greatscottgadgets/misc/README.md

misc
====

miscellaneous Great Scott Gadgets projects
