greatscottgadgets/misc/evaluation-boards/rf-amps/rf-amps.kicad_pcb

## KiCad design evaluation-boards/rf-amps/rf-amps.kicad_pcb (2025-06-16)

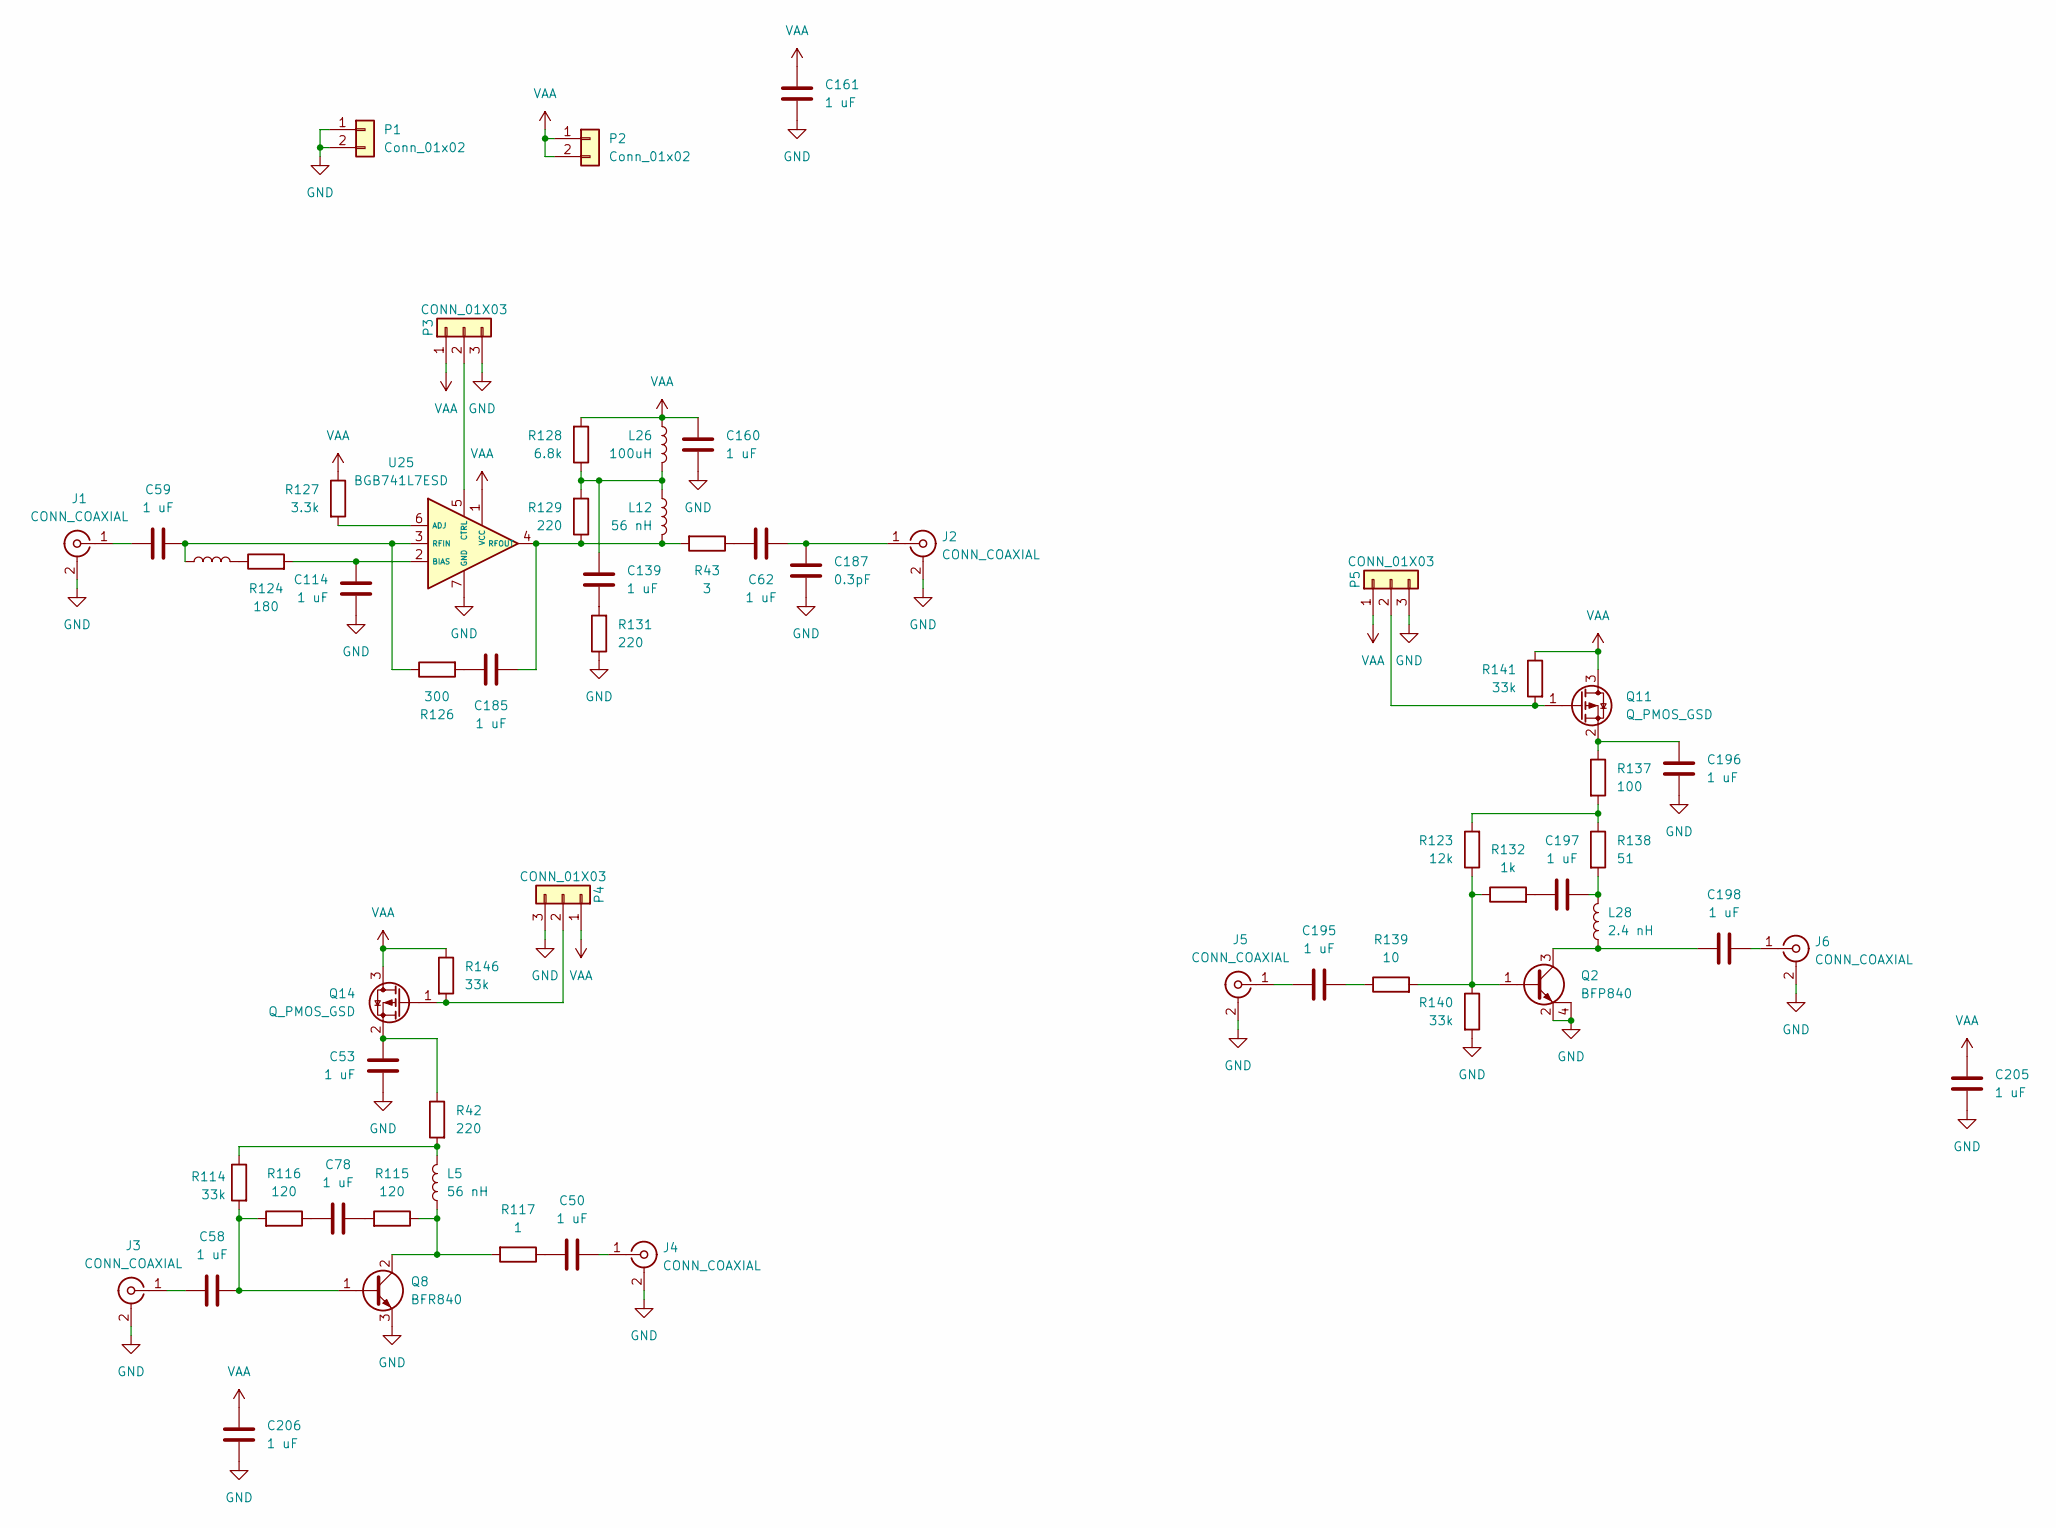
[picture p1: schematic rf-amps.kicad_sch]

Parts:
C50, C53, C58, C59, C62, C78, C114, C139, C160, C161, C185, C195, C196, C197, C198, C205, C206: 1 uF; C_0201_0603Metric; Part Number GRM033R61A105ME44D
C187: 0.3pF; C_0201_0603Metric; Part Number GRM0335C1ER30BA01D
J1, J2, J3, J4, J5, J6: CONN_COAXIAL; SMA_MyAntenna_A-SMA-KE-16.5A_EdgeMount
L5, L12: 56 nH; L_0201_0603Metric; Part Number LQP03TN56NJ02D
L25: 8.2 nH; L_0201_0603Metric; Part Number LQP03TN8N2J02D
L26: 100uH; L_TDK_MLZ2012_h1.25mm; Part Number MLZ2012N101LT000
L28: 2.4 nH; L_0201_0603Metric; Part Number LQP03TN2N4C02D
P1, P2: Conn_01x02; PinHeader_1x02_P2.54mm_Vertical
P3, P4, P5: CONN_01X03; PinHeader_1x03_P2.54mm_Vertical
Q2: BFP840; SOT-343-4-3; Part Number BFP840ESDH6327XTSA1
Q8: BFR840; TSLP-3-9; Part Number BFR840L3RHESDE6327XTSA1
Q11, Q14: Q_PMOS_GSD; TSLP-3-9; Part Number LP0404N3T5G
R42, R129, R131: 220; R_0201_0603Metric; Part Number RC0201JR-07220RL
R43: 3; R_0201_0603Metric; Part Number RC0402JR-073RL
R114, R140, R141, R146: 33k; R_0201_0603Metric; Part Number RC0201JR-0733KL
R115, R116: 120; R_0201_0603Metric; Part Number RC0201FR-07120RL
R117: 1; R_0201_0603Metric; Part Number RC0201JR-071RL
R123: 12k; R_0201_0603Metric; Part Number RC0201FR-0712KL
R124: 180; R_0201_0603Metric; Part Number RC0201FR-07180RL
R126: 300; R_0201_0603Metric; Part Number RC0201FR-07300RL
R127: 3.3k; R_0201_0603Metric; Part Number RC0201FR-073K3L
R128: 6.8k; R_0201_0603Metric; Part Number RC0201FR-076K8L
R132: 1k; R_0201_0603Metric; Part Number RC0201FR-071KL
R137: 100; R_0201_0603Metric; Part Number RC0201JR-07100RL
R138: 51; R_0201_0603Metric; Part Number RC0201JR-0751RL
R139: 10; R_0201_0603Metric; Part Number RC0201JR-0710RL
U25: BGB741L7ESD; TSLP-7-1; Part Number BGB741L7ESDE6327XTSA1

Connections:
GND: C53.2, C114.2, C160.2, C161.2, C187.2, C196.2, C205.2, C206.2, J1.2 (Ext), J2.2 (Ext), J3.2 (Ext), J4.2 (Ext), J5.2 (Ext), J6.2 (Ext), P1.1, P1.2, P3.3, P4.3, P5.3, Q2.2 (E), Q2.4 (C), Q8.3 (E), R131.1, R140.2, U25.7 (GND)
unnamed: C50.2, R117.1
unnamed: C62.1, R43.1
unnamed: C78.1, R115.2
unnamed: C78.2, R116.1
unnamed: C139.1, L12.1, L26.2, R128.1, R129.2
unnamed: C139.2, R131.2
unnamed: C185.2, R126.2
unnamed: C195.1, R139.1
unnamed: C197.1, L28.2, R138.2
unnamed: C197.2, R132.2
unnamed: C198.2, L28.1, Q2.3 (C)
unnamed: C59.1, J1.1 (In)
unnamed: C62.2, C187.1, J2.1 (In)
unnamed: C58.1, J3.1 (In)
unnamed: C50.1, J4.1 (In)
unnamed: C195.2, J5.1 (In)
unnamed: C198.1, J6.1 (In)
unnamed: L5.1, R42.2, R114.1
unnamed: L25.2, R124.1
unnamed: P3.2, U25.5 (CTRL)
unnamed: P4.2, Q14.1 (G), R146.2
unnamed: P5.2, Q11.1 (G), R141.2
unnamed: Q2.1 (B), R123.1, R132.1, R139.2, R140.1
unnamed: C58.2, Q8.1 (B), R114.2, R116.2
unnamed: L5.2, Q8.2 (C), R115.1, R117.2
unnamed: C196.1, Q11.2 (S), R137.1
unnamed: C53.1, Q14.2 (S), R42.1
unnamed: R123.2, R137.2, R138.1
unnamed: R127.2, U25.6 (ADJ)
unnamed: C114.1, R124.2, U25.2 (BIAS)
unnamed: C59.2, L25.1, R126.1, U25.3 (RFIN)
unnamed: C185.1, L12.2, R43.2, R129.1, U25.4 (RFOUT)
VAA: C160.1, C161.1, C205.1, C206.1, L26.1, P2.1, P2.2, P3.1, P4.1, P5.1, Q11.3 (D), Q14.3 (D), R127.1, R128.2, R141.1, R146.1, U25.1 (VCC)

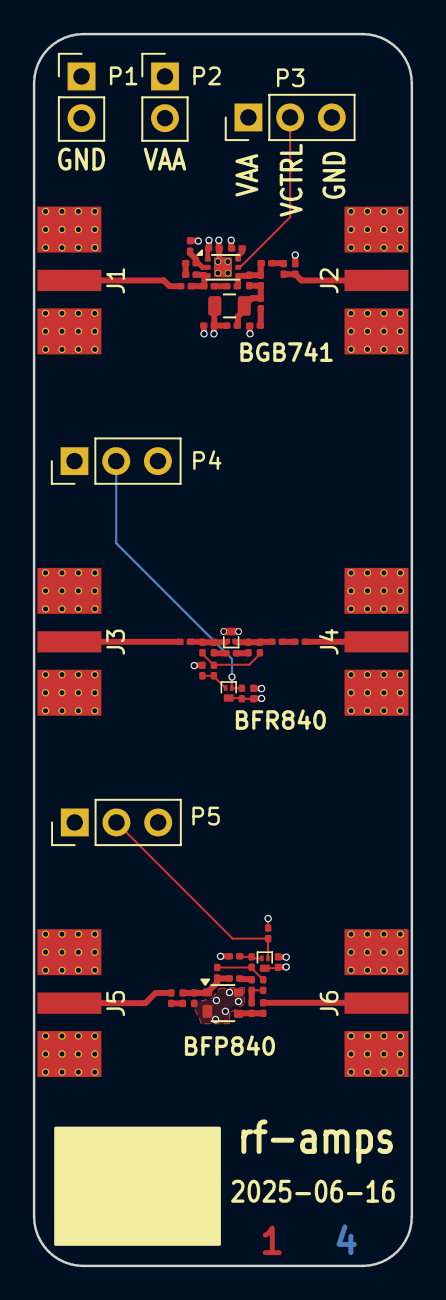
[picture p2: board rf-amps.kicad_pcb from above]

Board: 4 copper layers, 23.0 x 75.0 mm, 59 parts (0 on the bottom side), 34 nets.
