greatscottgadgets/misc/evaluation-boards/baluns/baluns.kicad_pcb

## KiCad design evaluation-boards/baluns/baluns.kicad_pcb (2025-06-16)

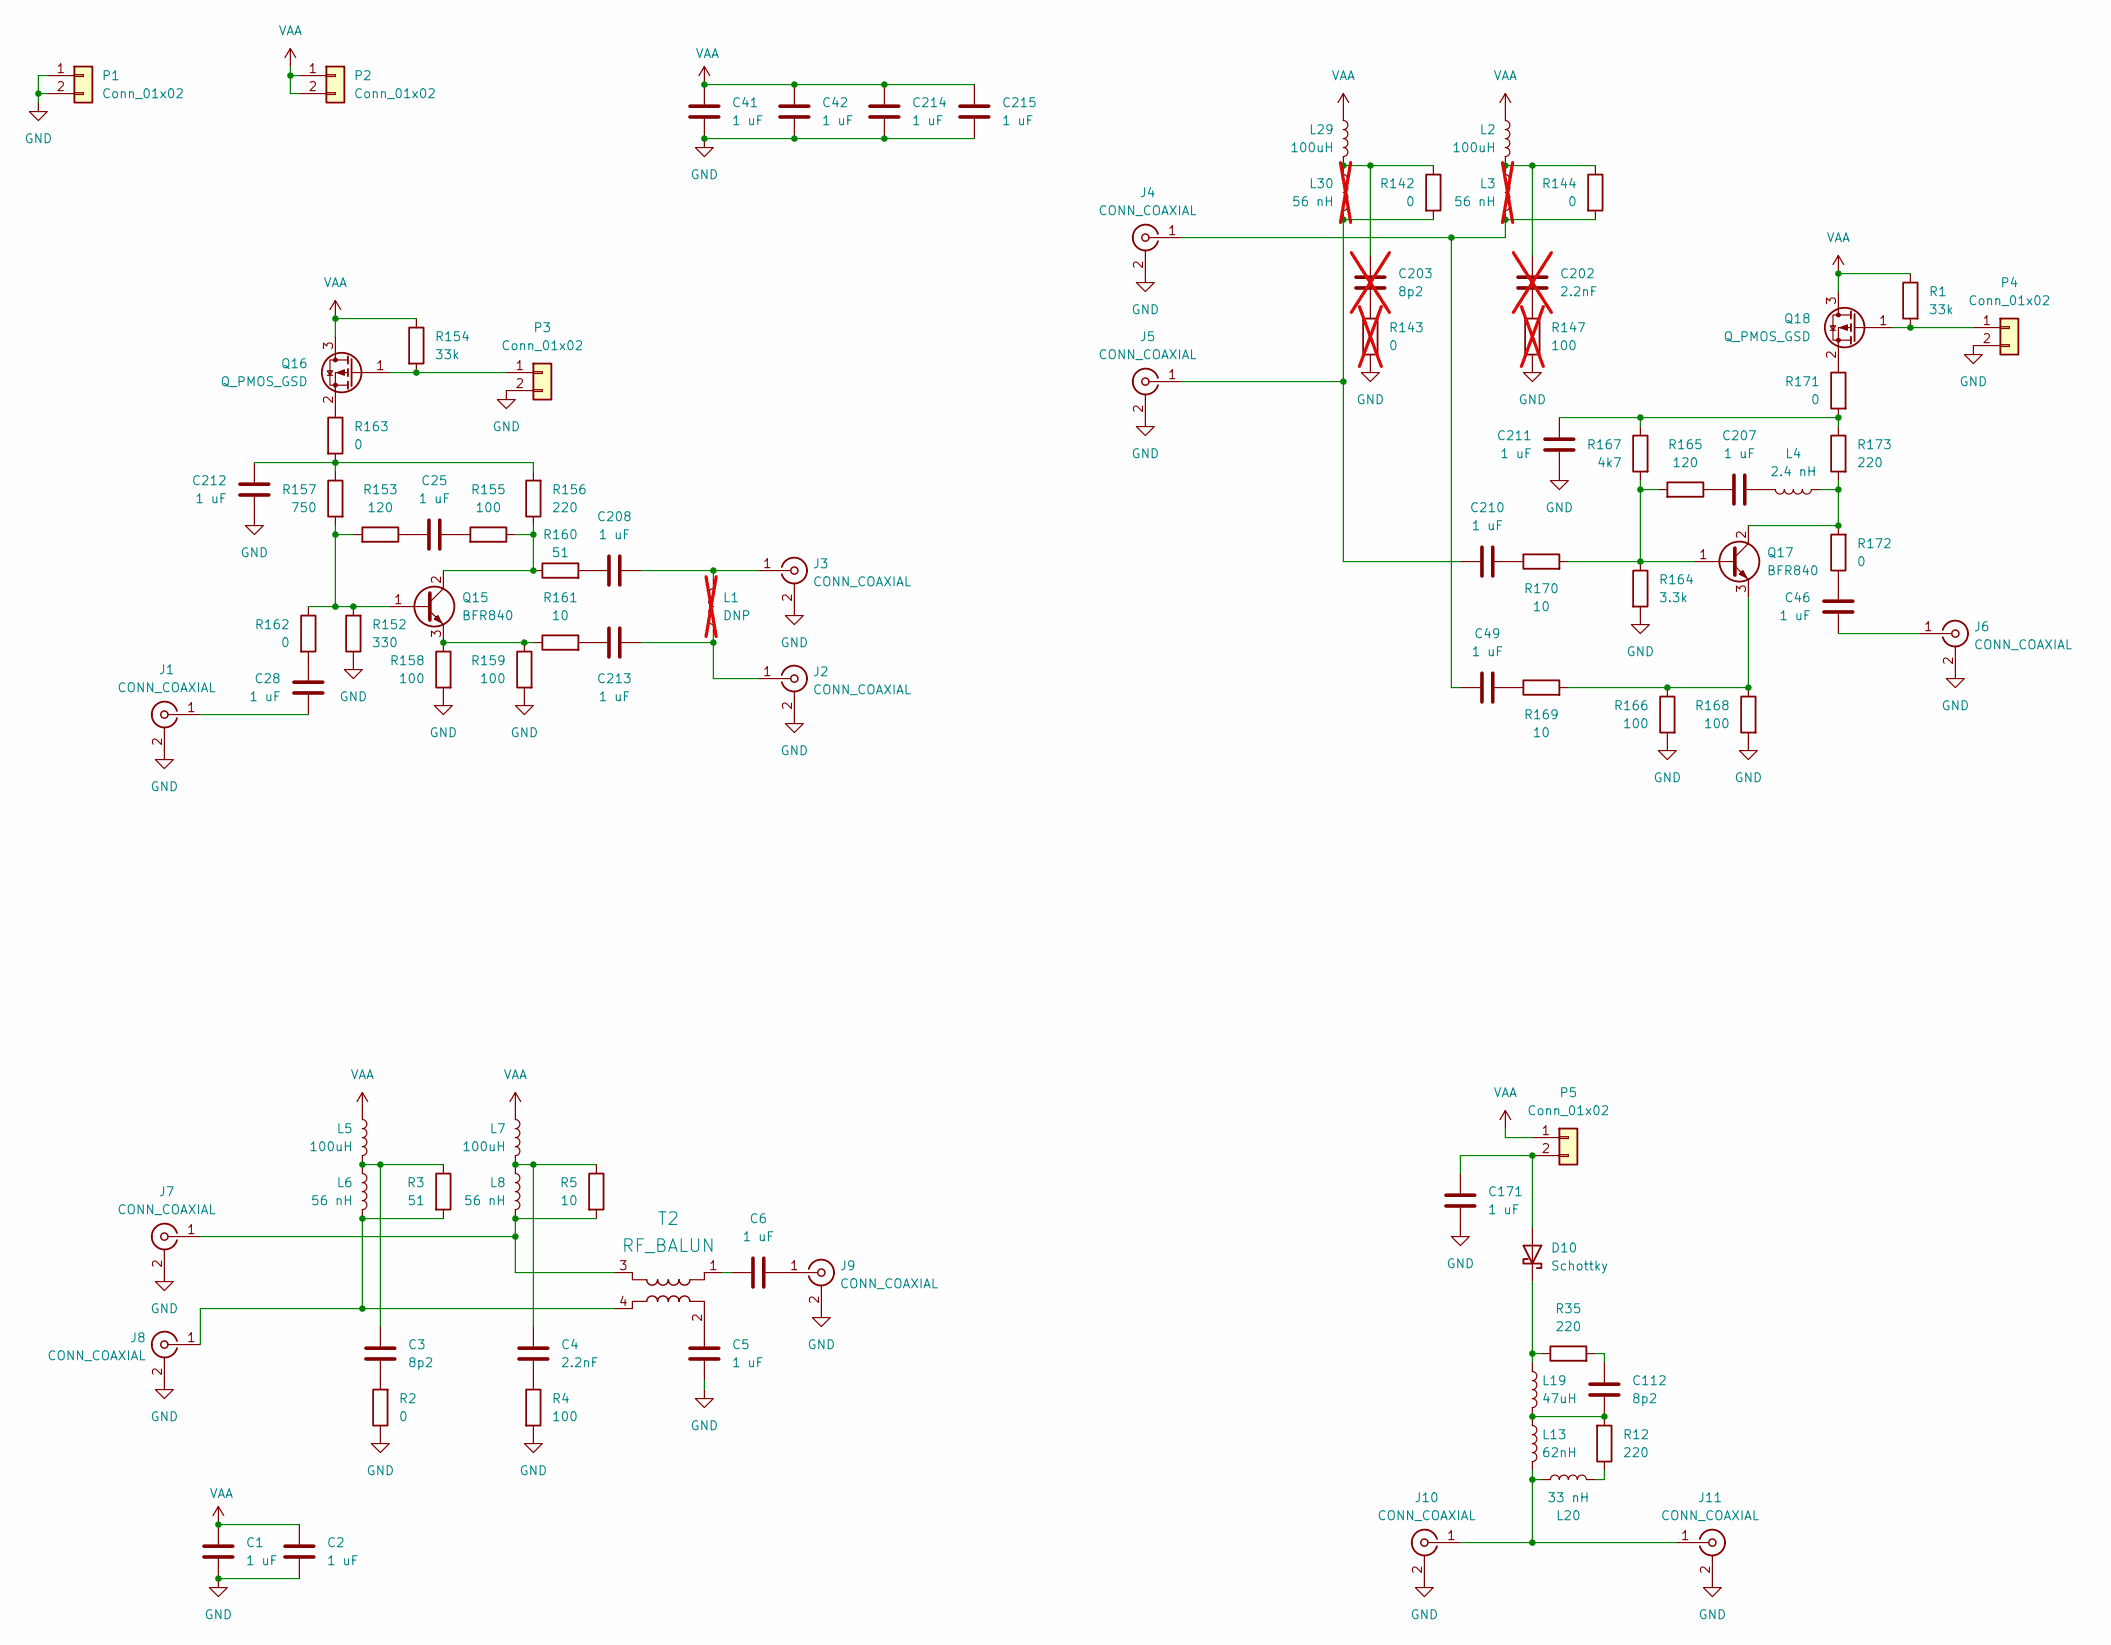
[picture p3: schematic baluns.kicad_sch, {$TITLE}]

Parts:
C1, C2, C5, C6, C25, C28, C41, C42, C46, C49, C171, C207, C208, C210, C211, C212, C213, C214, C215: 1 uF; C_0201_0603Metric; Part Number GRM033R61A105ME44D
C3, C112: 8p2; C_0201_0603Metric; Part Number GRM0335C1H8R2CA01D
C4: 2.2nF; C_0201_0603Metric; Part Number GRM033R71A222KA01D
C202: 2.2nF; C_0201_0603Metric; Part Number GRM033R71A222KA01D; not fitted
C203: 8p2; C_0201_0603Metric; Part Number GRM0335C1H8R2CA01D; not fitted
D10: Schottky; TSLP-2-19; Part Number PMEG4010ESBYL
J1, J2, J3, J4, J5, J6, J7, J8, J9, J10, J11: CONN_COAXIAL; SMA_MyAntenna_A-SMA-KE-16.5A_EdgeMount
L1: DNP; L_0201_0603Metric; not fitted
L2, L5, L7, L29: 100uH; L_TDK_MLZ2012_h1.25mm; Part Number MLZ2012N101LT000
L3, L30: 56 nH; L_0201_0603Metric; Part Number LQP03TN56NJ02D; not fitted
L4: 2.4 nH; L_0201_0603Metric; Part Number LQP03TN2N4C02D
L6, L8: 56 nH; L_0201_0603Metric; Part Number LQP03TN56NJ02D
L13: 62nH; L_0603_1608Metric; Part Number LQW18AN62NJ00D
L19: 47uH; L_Taiyo-Yuden_A251818; Part Number LSQEA251818T470M
L20: 33 nH; L_0201_0603Metric; Part Number LQP03TN33NJ02D
P1, P2, P3, P4, P5: Conn_01x02; PinHeader_1x02_P2.54mm_Vertical
Q15, Q17: BFR840; TSLP-3-9; Part Number BFR840L3RHESDE6327XTSA1
Q16, Q18: Q_PMOS_GSD; TSLP-3-9; Part Number LP0404N3T5G
R1, R154: 33k; R_0201_0603Metric; Part Number RC0201JR-0733KL
R2, R142, R144, R162, R163, R171, R172: 0; R_0201_0603Metric; Part Number RC0201JR-070RL
R3, R160: 51; R_0201_0603Metric; Part Number RC0201JR-0751RL
R4, R155, R158, R159, R166, R168: 100; R_0201_0603Metric; Part Number RC0201JR-07100RL
R5, R161, R169, R170: 10; R_0201_0603Metric; Part Number RC0201JR-0710RL
R12, R35, R156, R173: 220; R_0201_0603Metric; Part Number RC0201JR-07220RL
R143: 0; R_0201_0603Metric; Part Number RC0201JR-070RL; not fitted
R147: 100; R_0201_0603Metric; Part Number RC0201JR-07100RL; not fitted
R152: 330; R_0201_0603Metric; Part Number RC0201JR-07330RL
R153, R165: 120; R_0201_0603Metric; Part Number RC0201FR-07120RL
R157: 750; R_0201_0603Metric; Part Number RC0201JR-07750RL
R164: 3.3k; R_0201_0603Metric; Part Number RC0201FR-073K3L
R167: 4k7; R_0201_0603Metric; Part Number RC0201FR-074K7L
T2: RF_BALUN; Anaren_0805_2012Metric-6; Part Number B0310J50100AHF

Connections:
GND: C1.2, C2.2, C5.1, C41.2, C42.2, C171.2, C211.2, C212.2, C214.2, C215.2, J1.2 (Ext), J2.2 (Ext), J3.2 (Ext), J4.2 (Ext), J5.2 (Ext), J6.2 (Ext), J7.2 (Ext), J8.2 (Ext), J9.2 (Ext), J10.2 (Ext), J11.2 (Ext), P1.1, P1.2, P3.2, P4.2, R2.1, R4.2, R143.1, R147.2, R152.1, R158.2, R159.2, R164.2, R166.2, R168.2
unnamed: C3.1, L5.2, L6.1, R3.1
unnamed: C3.2, R2.2
unnamed: C4.1, R4.1
unnamed: C4.2, L7.2, L8.1, R5.1
unnamed: C6.2, T2.1
unnamed: C25.1, R155.2
unnamed: C25.2, R153.1
unnamed: C28.1, R162.2
unnamed: C46.1, R172.1
unnamed: C49.1, R169.1
unnamed: C112.1, R35.2
unnamed: C112.2, L13.1, L19.2, R12.2
unnamed: C202.1, R147.1
unnamed: C202.2, L2.2, L3.1, R144.1
unnamed: C203.1, L29.2, L30.1, R142.1
unnamed: C203.2, R143.2
unnamed: C207.1, L4.2
unnamed: C207.2, R165.1
unnamed: C208.2, R160.2
unnamed: C210.1, R170.1
unnamed: C211.1, R167.1, R171.2, R173.1
unnamed: C212.1, R156.2, R157.1, R163.2
unnamed: C213.2, R161.2
unnamed: C171.1, D10.2 (A), P5.2
unnamed: D10.1 (K), L19.1, R35.1
unnamed: C28.2, J1.1 (In)
unnamed: C213.1, J2.1 (In), L1.1
unnamed: C208.1, J3.1 (In), L1.2
unnamed: C49.2, J4.1 (In), L3.2, R144.2
unnamed: C210.2, J5.1 (In), L30.2, R142.2
unnamed: C46.2, J6.1 (In)
unnamed: J7.1 (In), L8.2, R5.2, T2.3
unnamed: J8.1 (In), L6.2, R3.2, T2.4
unnamed: C6.1, J9.1 (In)
unnamed: J10.1 (In), J11.1 (In), L13.2, L20.2
unnamed: L20.1, R12.1
unnamed: P3.1, Q16.1 (G), R154.2
unnamed: P4.1, Q18.1 (G), R1.2
unnamed: Q15.1 (B), R152.2, R153.2, R157.2, R162.1
unnamed: Q15.2 (C), R155.1, R156.1, R160.1
unnamed: Q15.3 (E), R158.1, R159.1, R161.1
unnamed: Q16.2 (S), R163.1
unnamed: Q17.1 (B), R164.1, R165.2, R167.2, R170.2
unnamed: L4.1, Q17.2 (C), R172.2, R173.2
unnamed: Q17.3 (E), R166.1, R168.1, R169.2
unnamed: Q18.2 (S), R171.1
unnamed: C5.2, T2.2 (GND)
VAA: C1.1, C2.1, C41.1, C42.1, C214.1, C215.1, L2.1, L5.1, L7.1, L29.1, P2.1, P2.2, P5.1, Q16.3 (D), Q18.3 (D), R1.1, R154.1

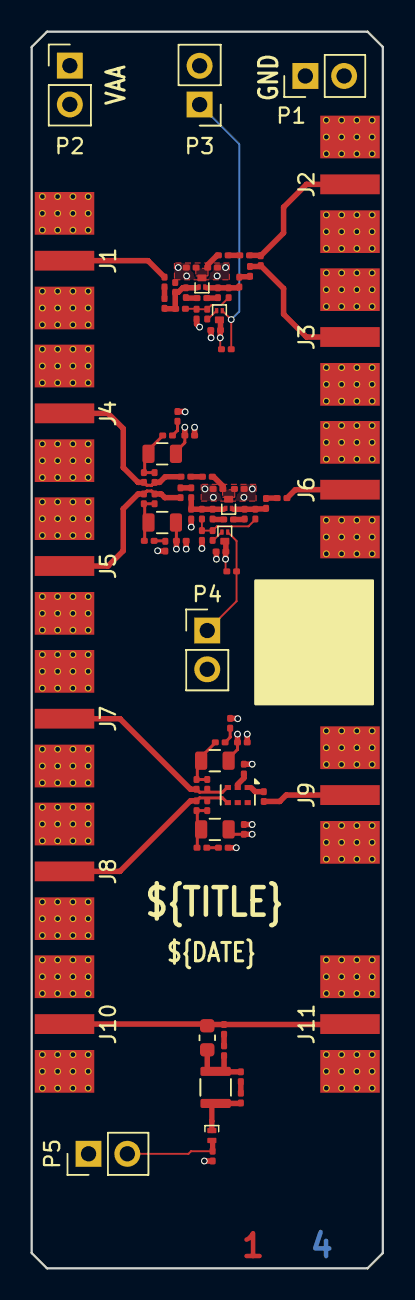
[picture p4: board baluns.kicad_pcb from above]

Board: 4 copper layers, 23.0 x 81.0 mm, 92 parts (0 on the bottom side), 49 nets.
