greatscottgadgets/misc/evaluation-boards/filters/filters.kicad_pcb

## KiCad design evaluation-boards/filters/filters.kicad_pcb (2025-06-16)

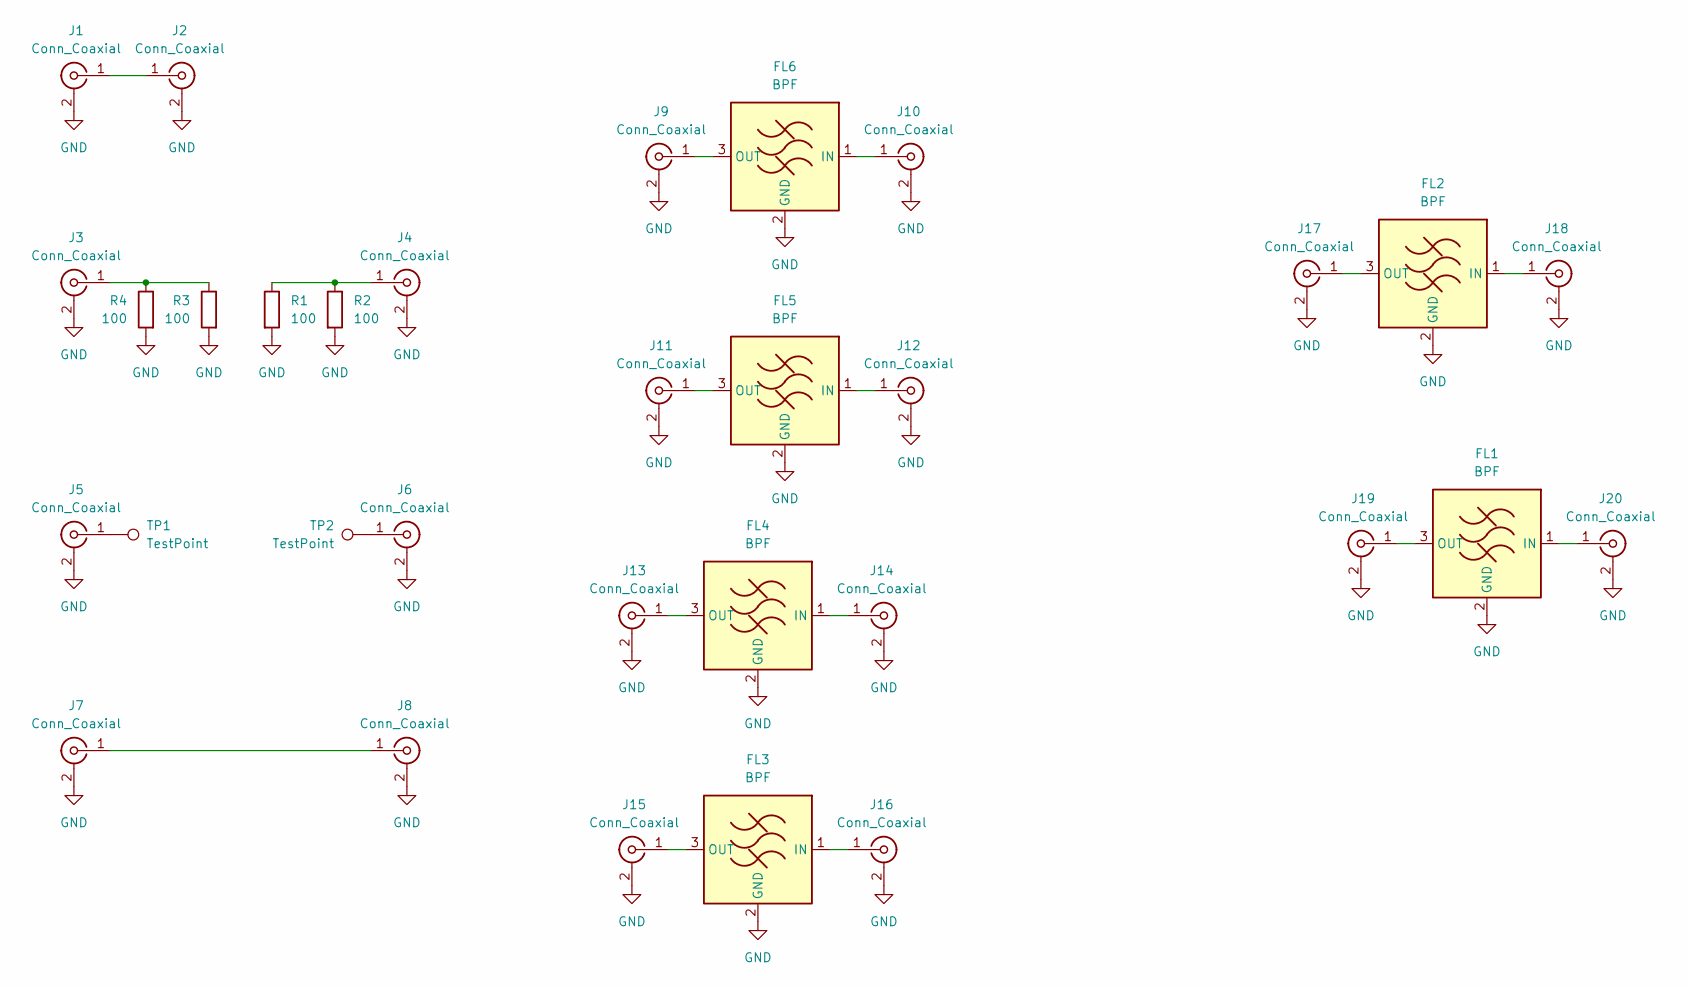
[picture p5: schematic filters.kicad_sch, ${TITLE}]

Parts:
FL1, FL2, FL3, FL4, FL5, FL6: BPF; Filter_Pulse_BPF1608LM09R5000A; Part Number BPF1608LM02R2400A
J1, J2, J3, J4, J5, J6, J7, J8, J9, J10, J11, J12, J13, J14, J15, J16, J17, J18, J19, J20: Conn_Coaxial; SMA_MyAntenna_A-SMA-KE-16.5A_EdgeMount
R1, R2, R3, R4: 100; R_0201_0603Metric
TP1, TP2: TestPoint; Square_Pad_0.364x0.364mm

Connections:
GND: FL1.2 (GND), FL1.4 (GND), FL2.2 (GND), FL2.4 (GND), FL3.2 (GND), FL3.4 (GND), FL4.2 (GND), FL4.4 (GND), FL5.2 (GND), FL5.4 (GND), FL6.2 (GND), FL6.4 (GND), J1.2 (Ext), J2.2 (Ext), J3.2 (Ext), J4.2 (Ext), J5.2 (Ext), J6.2 (Ext), J7.2 (Ext), J8.2 (Ext), J9.2 (Ext), J10.2 (Ext), J11.2 (Ext), J12.2 (Ext), J13.2 (Ext), J14.2 (Ext), J15.2 (Ext), J16.2 (Ext), J17.2 (Ext), J18.2 (Ext), J19.2 (Ext), J20.2 (Ext), R1.2, R2.2, R3.2, R4.2
unnamed: FL1.1 (IN), J20.1 (In)
unnamed: FL1.3 (OUT), J19.1 (In)
unnamed: FL2.1 (IN), J18.1 (In)
unnamed: FL2.3 (OUT), J17.1 (In)
unnamed: FL3.1 (IN), J16.1 (In)
unnamed: FL3.3 (OUT), J15.1 (In)
unnamed: FL4.1 (IN), J14.1 (In)
unnamed: FL4.3 (OUT), J13.1 (In)
unnamed: FL5.1 (IN), J12.1 (In)
unnamed: FL5.3 (OUT), J11.1 (In)
unnamed: FL6.1 (IN), J10.1 (In)
unnamed: FL6.3 (OUT), J9.1 (In)
unnamed: J1.1 (In), J2.1 (In)
unnamed: J3.1 (In), R3.1, R4.1
unnamed: J4.1 (In), R1.1, R2.1
unnamed: J5.1 (In), TP1.1
unnamed: J6.1 (In), TP2.1
unnamed: J7.1 (In), J8.1 (In)

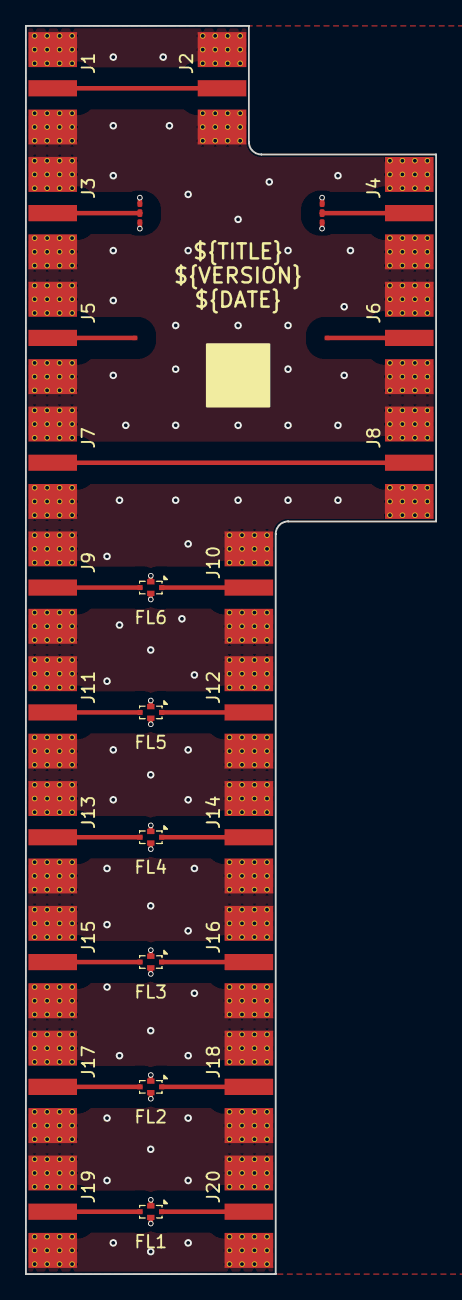
[picture p6: board filters.kicad_pcb from above]

Board: 4 copper layers, 32.9 x 100.0 mm, 32 parts (0 on the bottom side), 19 nets.
