greatscottgadgets/misc/evaluation-boards/trace-width/sma-jlcpcb.kicad_pcb

## KiCad design evaluation-boards/trace-width/sma-jlcpcb.kicad_pcb (2025-03-12)

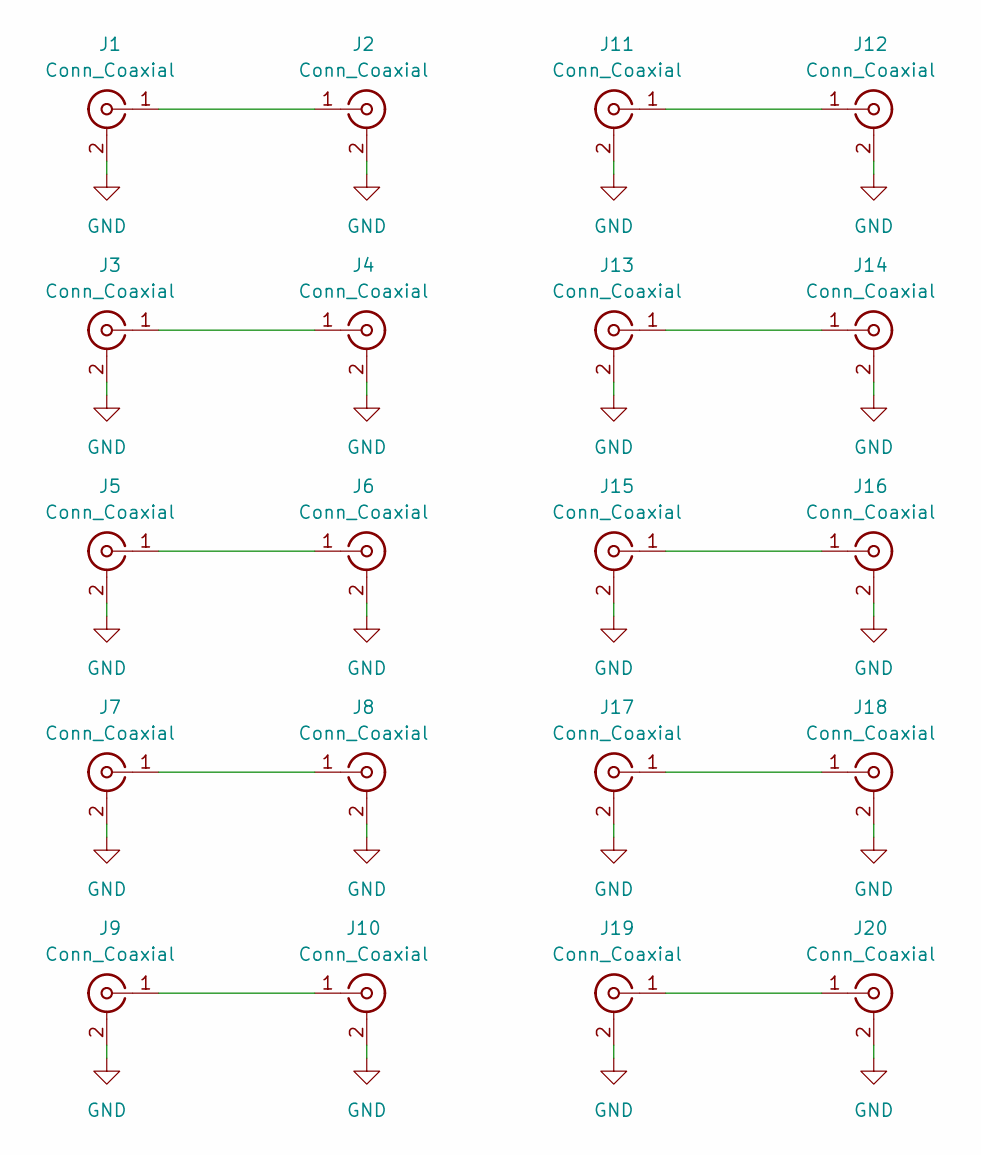
[picture p7: schematic sma-jlcpcb.kicad_sch]

Parts:
J1, J2, J3, J4, J5, J6, J7, J8, J9, J10, J11, J12, J13, J14, J15, J16, J17, J18, J19, J20: Conn_Coaxial

Connections:
GND: J1.2 (Ext), J2.2 (Ext), J3.2 (Ext), J4.2 (Ext), J5.2 (Ext), J6.2 (Ext), J7.2 (Ext), J8.2 (Ext), J9.2 (Ext), J10.2 (Ext), J11.2 (Ext), J12.2 (Ext), J13.2 (Ext), J14.2 (Ext), J15.2 (Ext), J16.2 (Ext), J17.2 (Ext), J18.2 (Ext), J19.2 (Ext), J20.2 (Ext)
unnamed: J1.1 (In), J2.1 (In)
unnamed: J3.1 (In), J4.1 (In)
unnamed: J5.1 (In), J6.1 (In)
unnamed: J7.1 (In), J8.1 (In)
unnamed: J9.1 (In), J10.1 (In)
unnamed: J11.1 (In), J12.1 (In)
unnamed: J13.1 (In), J14.1 (In)
unnamed: J15.1 (In), J16.1 (In)
unnamed: J17.1 (In), J18.1 (In)
unnamed: J19.1 (In), J20.1 (In)

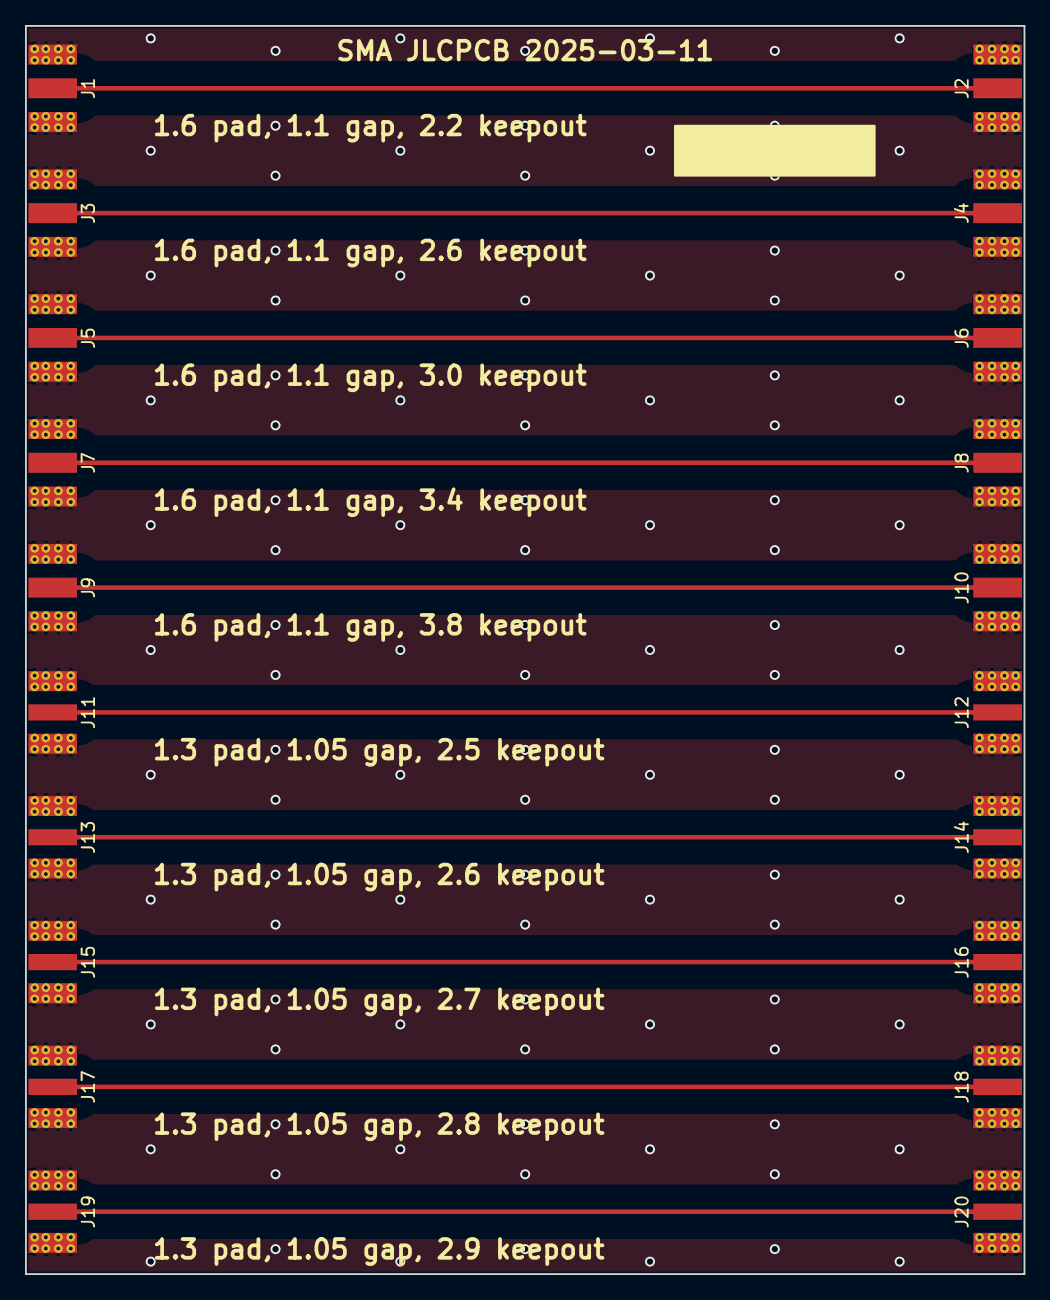
[picture p8: board sma-jlcpcb.kicad_pcb from above]

Board: 6 copper layers, 80.0 x 100.0 mm, 20 parts (0 on the bottom side), 11 nets.
