greatscottgadgets/misc/evaluation-boards/leds/leds.kicad_pcb

## KiCad design evaluation-boards/leds/leds.kicad_pcb (2025-03-12)

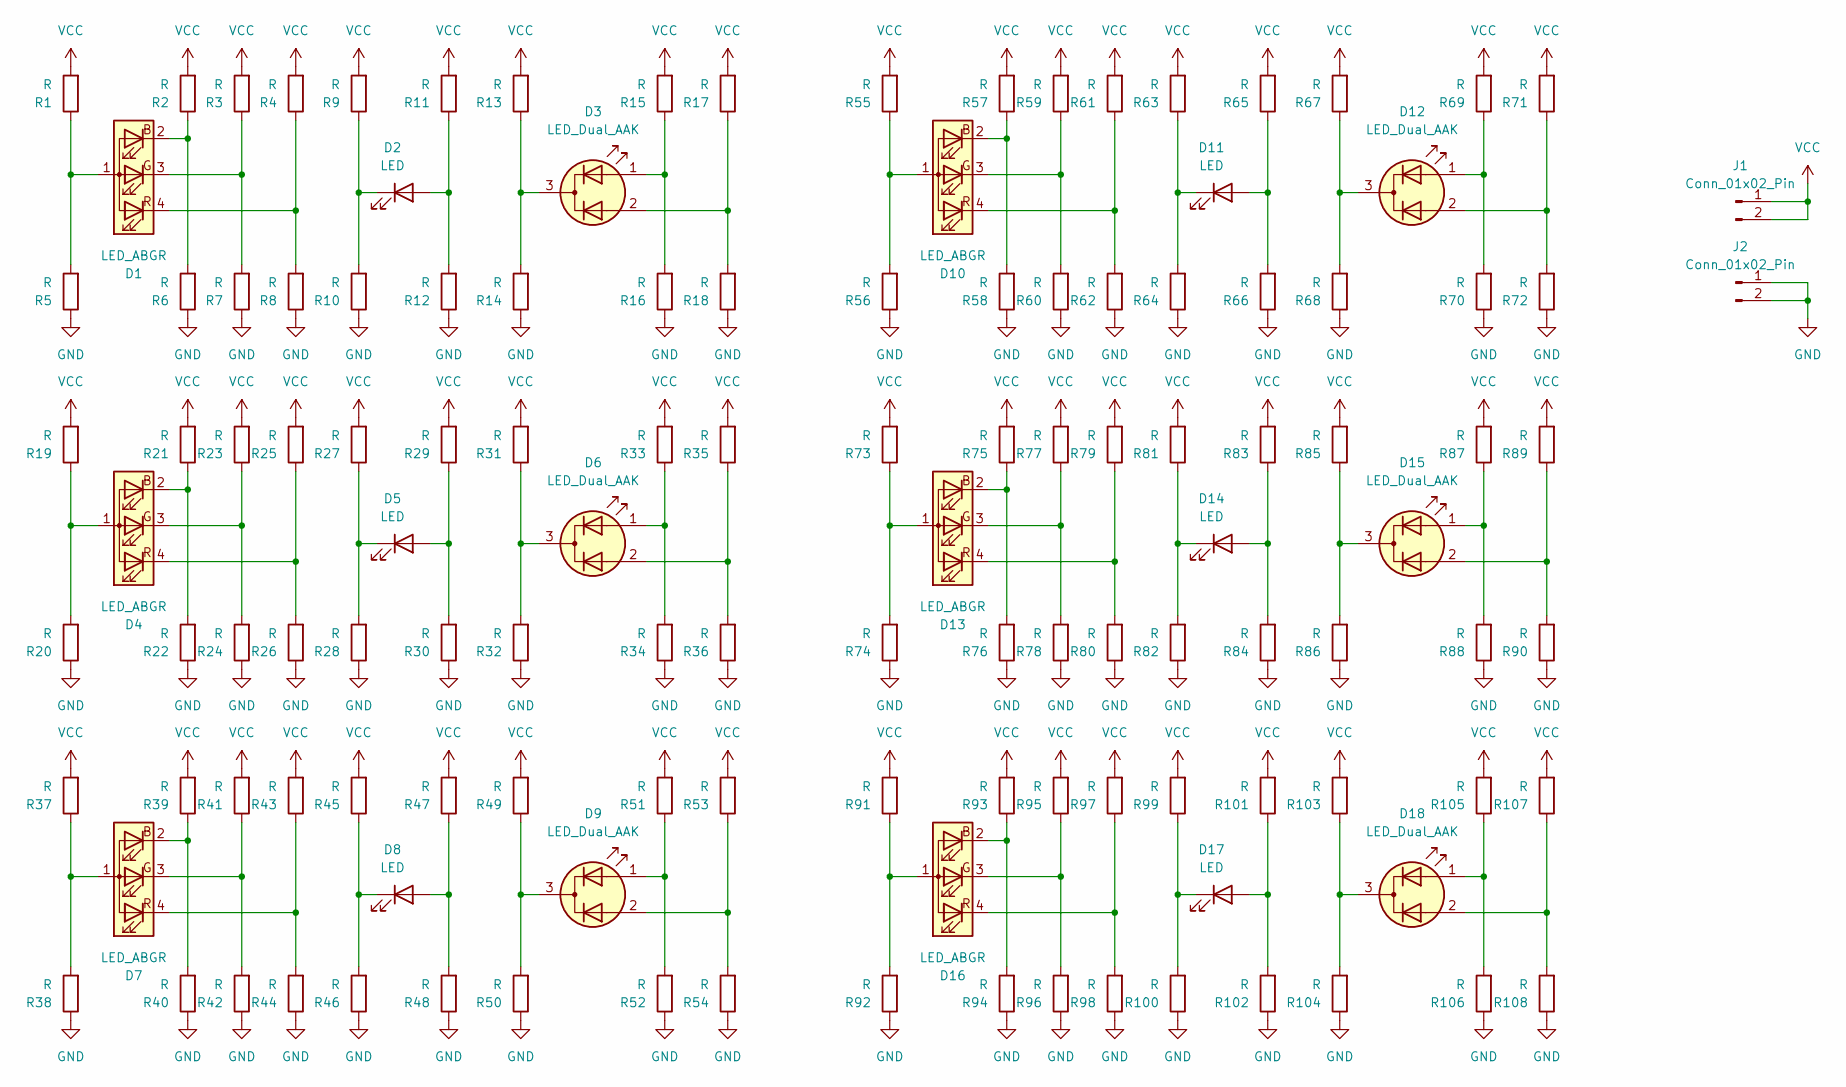
[picture p9: schematic leds.kicad_sch, ${TITLE}]

Parts:
D1, D4, D7, D10, D13, D16: LED_ABGR; LED_RGB_Everlight_EASV3015RGBA0_Horizontal
D2, D5, D8, D11, D14, D17: LED; LED_Kingbright_APA1606_1.6x0.6mm_Horizontal
D3, D6, D9, D12, D15, D18: LED_Dual_AAK; LED_Kingbright_KPA-3010_3x2x1mm
J1, J2: Conn_01x02_Pin; PinHeader_1x02_P2.54mm_Vertical
R1, R2, R3, R4, R5, R6, R7, R8, R9, R10, R11, R12, R13, R14, R15, R16, R17, R18, R19, R20, R21, R22, R23, R24, R25, R26, R27, R28, R29, R30, R31, R32, R33, R34, R35, R36, R37, R38, R39, R40, R41, R42, R43, R44, R45, R46, R47, R48, R49, R50, R51, R52, R53, R54, R55, R56, R57, R58, R59, R60, R61, R62, R63, R64, R65, R66, R67, R68, R69, R70, R71, R72, R73, R74, R75, R76, R77, R78, R79, R80, R81, R82, R83, R84, R85, R86, R87, R88, R89, R90, R91, R92, R93, R94, R95, R96, R97, R98, R99, R100, R101, R102, R103, R104, R105, R106, R107, R108: R; R_0402_1005Metric

Connections:
GND: J2.1, J2.2, R5.1, R6.1, R7.1, R8.1, R10.1, R12.1, R14.1, R16.1, R18.1, R20.1, R22.1, R24.1, R26.1, R28.1, R30.1, R32.1, R34.1, R36.1, R38.1, R40.1, R42.1, R44.1, R46.1, R48.1, R50.1, R52.1, R54.1, R56.1, R58.1, R60.1, R62.1, R64.1, R66.1, R68.1, R70.1, R72.1, R74.1, R76.1, R78.1, R80.1, R82.1, R84.1, R86.1, R88.1, R90.1, R92.1, R94.1, R96.1, R98.1, R100.1, R102.1, R104.1, R106.1, R108.1
unnamed: D1.1 (A), R1.1, R5.2
unnamed: D1.2 (BK), R2.1, R6.2
unnamed: D1.3 (GK), R3.1, R7.2
unnamed: D1.4 (RK), R4.1, R8.2
unnamed: D2.2 (A), R11.1, R12.2
unnamed: D2.1 (K), R9.1, R10.2
unnamed: D3.1 (A1), R15.1, R16.2
unnamed: D3.2 (A2), R17.1, R18.2
unnamed: D3.3 (K), R13.1, R14.2
unnamed: D4.1 (A), R19.1, R20.2
unnamed: D4.2 (BK), R21.1, R22.2
unnamed: D4.3 (GK), R23.1, R24.2
unnamed: D4.4 (RK), R25.1, R26.2
unnamed: D5.2 (A), R29.1, R30.2
unnamed: D5.1 (K), R27.1, R28.2
unnamed: D6.1 (A1), R33.1, R34.2
unnamed: D6.2 (A2), R35.1, R36.2
unnamed: D6.3 (K), R31.1, R32.2
unnamed: D7.1 (A), R37.1, R38.2
unnamed: D7.2 (BK), R39.1, R40.2
unnamed: D7.3 (GK), R41.1, R42.2
unnamed: D7.4 (RK), R43.1, R44.2
unnamed: D8.2 (A), R47.1, R48.2
unnamed: D8.1 (K), R45.1, R46.2
unnamed: D9.1 (A1), R51.1, R52.2
unnamed: D9.2 (A2), R53.1, R54.2
unnamed: D9.3 (K), R49.1, R50.2
unnamed: D10.1 (A), R55.1, R56.2
unnamed: D10.2 (BK), R57.1, R58.2
unnamed: D10.3 (GK), R59.1, R60.2
unnamed: D10.4 (RK), R61.1, R62.2
unnamed: D11.2 (A), R65.1, R66.2
unnamed: D11.1 (K), R63.1, R64.2
unnamed: D12.1 (A1), R69.1, R70.2
unnamed: D12.2 (A2), R71.1, R72.2
unnamed: D12.3 (K), R67.1, R68.2
unnamed: D13.1 (A), R73.1, R74.2
unnamed: D13.2 (BK), R75.1, R76.2
unnamed: D13.3 (GK), R77.1, R78.2
unnamed: D13.4 (RK), R79.1, R80.2
unnamed: D14.2 (A), R83.1, R84.2
unnamed: D14.1 (K), R81.1, R82.2
unnamed: D15.1 (A1), R87.1, R88.2
unnamed: D15.2 (A2), R89.1, R90.2
unnamed: D15.3 (K), R85.1, R86.2
unnamed: D16.1 (A), R91.1, R92.2
unnamed: D16.2 (BK), R93.1, R94.2
unnamed: D16.3 (GK), R95.1, R96.2
unnamed: D16.4 (RK), R97.1, R98.2
unnamed: D17.2 (A), R101.1, R102.2
unnamed: D17.1 (K), R99.1, R100.2
unnamed: D18.1 (A1), R105.1, R106.2
unnamed: D18.2 (A2), R107.1, R108.2
unnamed: D18.3 (K), R103.1, R104.2
VCC: J1.1, J1.2, R1.2, R2.2, R3.2, R4.2, R9.2, R11.2, R13.2, R15.2, R17.2, R19.2, R21.2, R23.2, R25.2, R27.2, R29.2, R31.2, R33.2, R35.2, R37.2, R39.2, R41.2, R43.2, R45.2, R47.2, R49.2, R51.2, R53.2, R55.2, R57.2, R59.2, R61.2, R63.2, R65.2, R67.2, R69.2, R71.2, R73.2, R75.2, R77.2, R79.2, R81.2, R83.2, R85.2, R87.2, R89.2, R91.2, R93.2, R95.2, R97.2, R99.2, R101.2, R103.2, R105.2, R107.2
