greatscottgadgets/misc/evaluation-boards/leds/leds.kicad_pcb

## KiCad design evaluation-boards/leds/leds.kicad_pcb (continued)

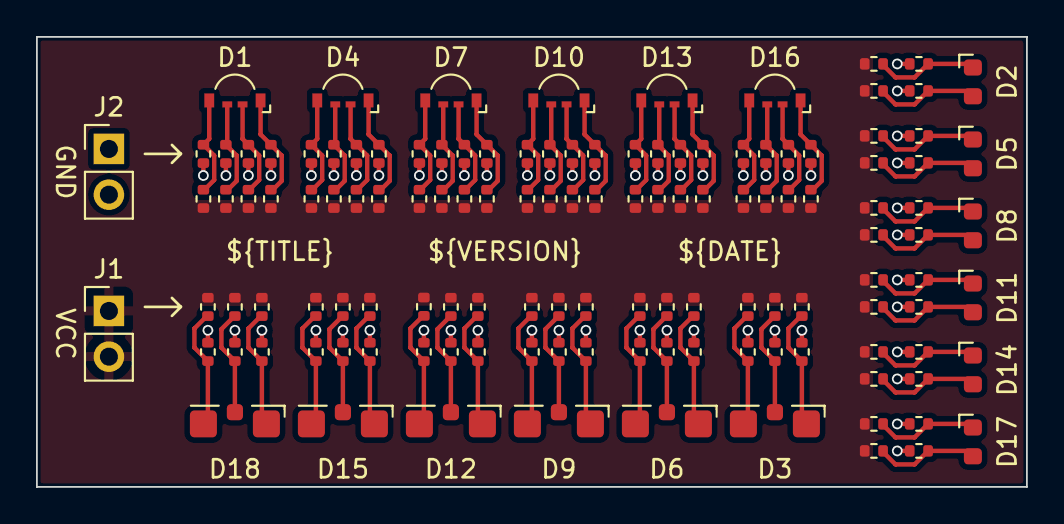
[picture p10: board leds.kicad_pcb from above]

Board: 2 copper layers, 55.0 x 25.0 mm, 128 parts (0 on the bottom side), 56 nets.
