greatscottgadgets/misc/evaluation-boards/limiters/limiters.kicad_pcb

## KiCad design evaluation-boards/limiters/limiters.kicad_pcb (2024-12-10)

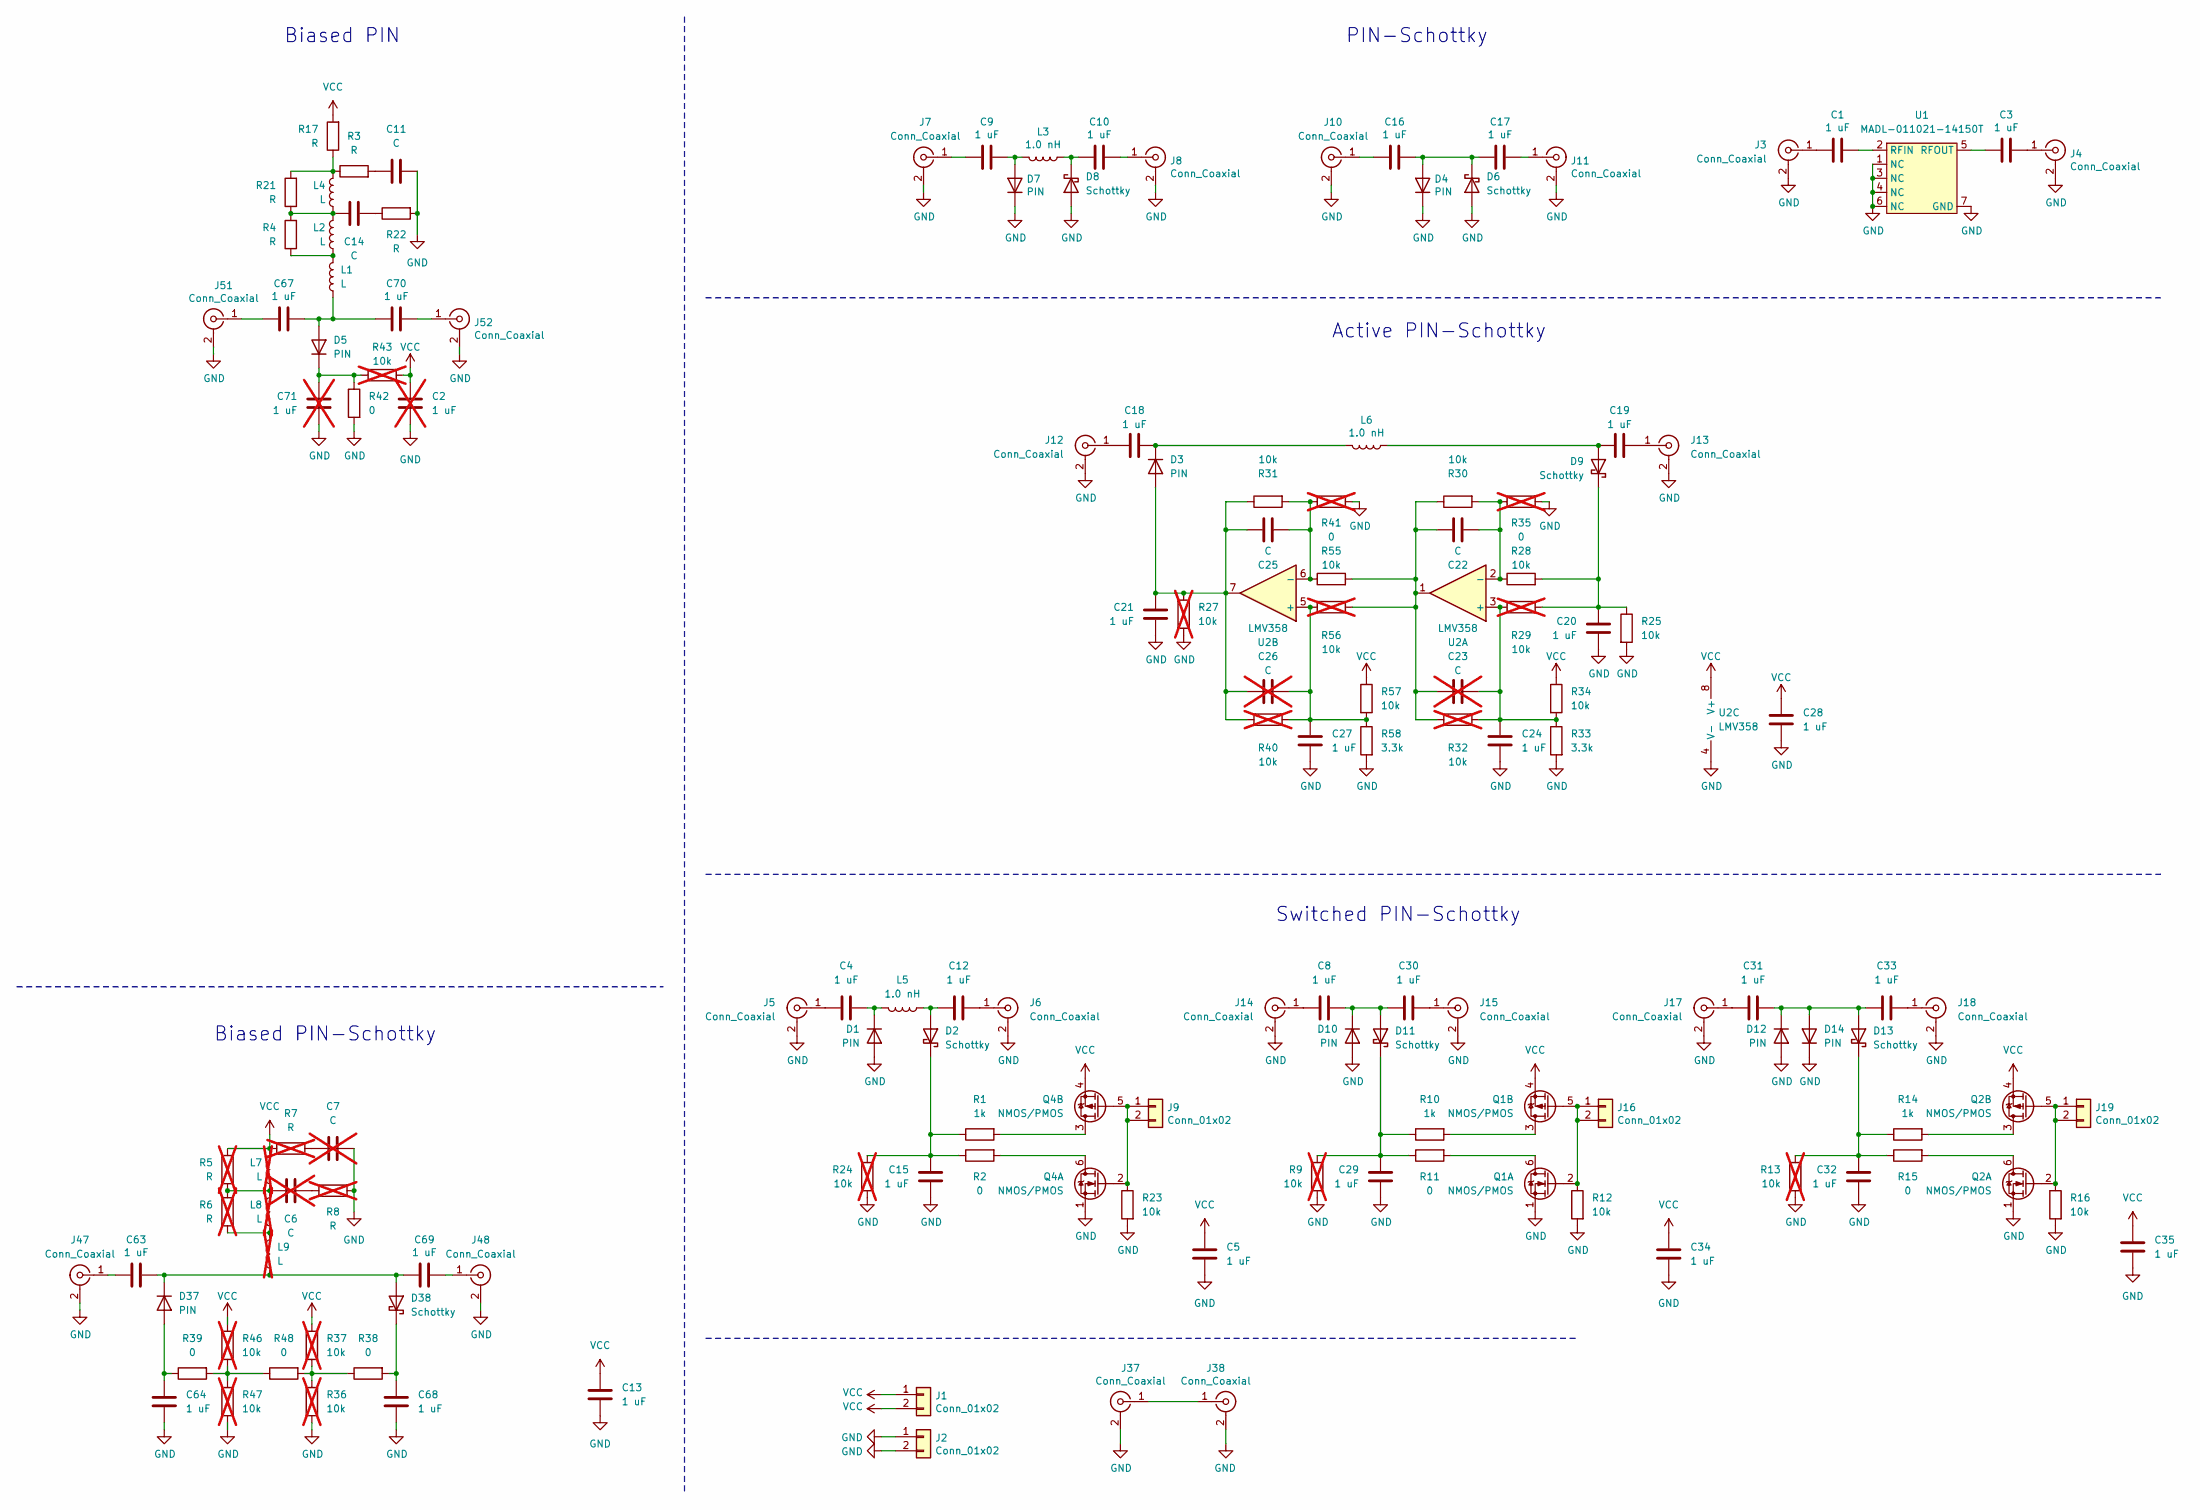
[picture p11: schematic limiters.kicad_sch]

Parts:
C1, C3, C5, C10, C12, C13, C15, C17, C18, C19, C20, C21, C24, C27, C28, C29, C30, C32, C33, C34, C35, C63, C64, C67, C68, C69, C70: 1 uF; C_0201_0603Metric; Part Number GRM033R61A105ME44D
C2, C71: 1 uF; C_0201_0603Metric; Part Number GRM033R61A105ME44D; not fitted
C4, C8, C31: 1 uF; C_0402_1005Metric; Part Number Capacitor_SMD:C_0402_1005Metric
C6, C7, C23, C26: C; C_0201_0603Metric; not fitted
C9, C16: 1 uF; C_0402_1005Metric
C11, C14, C22, C25: C; C_0201_0603Metric
D1, D3, D4, D5, D7, D10, D12, D14, D37: PIN; TSLP-2-19; Part Number BAR9002ELE6327XTMA1
D2, D6, D8, D9, D11, D13, D38: Schottky; TSSLP-2-1; Part Number BAT2402LSE6327XTSA1
J1, J2, J9, J16, J19: Conn_01x02; PinHeader_1x02_P2.54mm_Vertical
J3, J4, J5, J6, J7, J8, J10, J11, J12, J13, J14, J15, J17, J18, J37, J38, J47, J48, J51, J52: Conn_Coaxial; Linx_SMA_CONSMA003.062; Part Number CONSMA003.062
L1, L2: L; L_0201_0603Metric
L3, L5, L6: 1.0 nH; L_0201_0603Metric; Part Number LQP03HQ1N0W02D
L4: L; L_0805_2012Metric
L7: L; L_0805_2012Metric; not fitted
L8, L9: L; L_0201_0603Metric; not fitted
Q1, Q2, Q4: NMOS/PMOS; SOT-563; Part Number DMC2400UV
R1, R10, R14: 1k; R_0402_1005Metric
R2, R11, R15, R38, R39, R42, R48: 0; R_0402_1005Metric
R3, R4, R17, R21, R22: R; R_0201_0603Metric
R5, R6, R7, R8: R; R_0201_0603Metric; not fitted
R9, R13, R24, R27, R29, R32, R36, R37, R40, R43, R46, R47, R56: 10k; R_0402_1005Metric; not fitted
R12, R16, R23, R25, R28, R30, R31, R34, R55, R57: 10k; R_0402_1005Metric
R33, R58: 3.3k; R_0402_1005Metric
R35, R41: 0; R_0402_1005Metric; not fitted
U1: MADL-011021-14150T; TDFN-6-1EP_1.5x1.2mm_P0.4mm_EP0.47x0.8mm
U2: LMV358; MSOP-8_3x3mm_P0.65mm

Connections:
GND: C2.2, C5.2, C7.1, C11.1, C13.2, C15.2, C20.2, C21.2, C24.2, C27.2, C28.2, C29.2, C32.2, C34.2, C35.2, C64.2, C68.2, C71.2, D1.2 (A), D4.1 (K), D6.2 (A), D7.1 (K), D8.2 (A), D10.2 (A), D12.2 (A), D14.1 (K), J2.1, J2.2, J3.2 (Ext), J4.2 (Ext), J5.2 (Ext), J6.2 (Ext), J7.2 (Ext), J8.2 (Ext), J10.2 (Ext), J11.2 (Ext), J12.2 (Ext), J13.2 (Ext), J14.2 (Ext), J15.2 (Ext), J17.2 (Ext), J18.2 (Ext), J37.2 (Ext), J38.2 (Ext), J47.2 (Ext), J48.2 (Ext), J51.2 (Ext), J52.2 (Ext), Q1.1 (S), Q2.1 (S), Q4.1 (S), R8.2, R9.2, R12.2, R13.2, R16.2, R22.2, R23.2, R24.2, R25.2, R27.2, R33.2, R35.2, R36.2, R41.2, R42.2, R47.2, R58.2, U1.1 (NC), U1.3 (NC), U1.4 (NC), U1.6 (NC), U1.7 (GND), U2.4 (V-)
unnamed: C6.1, R8.1
unnamed: C6.2, L7.1, L8.2, R5.1, R6.2
unnamed: C7.2, R7.2
unnamed: C11.2, R3.2
unnamed: C14.1, R22.1
unnamed: C14.2, L2.2, L4.1, R4.2, R21.1
unnamed: C22.1, C23.1, R30.1, R32.1, R55.2, R56.2, U2.1
unnamed: C4.1, D1.1 (K), L5.2
unnamed: C12.2, D2.2 (A), L5.1
unnamed: C15.1, D2.1 (K), R1.1, R2.1, R24.1
unnamed: C21.1, C25.1, C26.1, D3.2 (A), R27.1, R31.1, R40.1, U2.7
unnamed: C18.1, D3.1 (K), L6.2
unnamed: C16.1, C17.2, D4.2 (A), D6.1 (K)
unnamed: C67.1, C70.2, D5.2 (A), L1.1
unnamed: C71.1, D5.1 (K), R42.1, R43.1
unnamed: C9.1, D7.2 (A), L3.2
unnamed: C10.2, D8.1 (K), L3.1
unnamed: C19.2, D9.2 (A), L6.1
unnamed: C20.1, D9.1 (K), R25.1, R28.2, R29.2
unnamed: C8.1, C30.2, D10.1 (K), D11.2 (A)
unnamed: C29.1, D11.1 (K), R9.1, R10.1, R11.1
unnamed: C31.1, C33.2, D12.1 (K), D13.2 (A), D14.2 (A)
unnamed: C32.1, D13.1 (K), R13.1, R14.1, R15.1
unnamed: C64.1, D37.2 (A), R39.1
unnamed: C63.1, C69.2, D37.1 (K), D38.2 (A), L9.1
unnamed: C68.1, D38.1 (K), R38.2
unnamed: C1.2, J3.1 (In)
unnamed: C3.1, J4.1 (In)
unnamed: C4.2, J5.1 (In)
unnamed: C12.1, J6.1 (In)
unnamed: C9.2, J7.1 (In)
unnamed: C10.1, J8.1 (In)
unnamed: J9.1, J9.2, Q4.2 (G), Q4.5 (G), R23.1
unnamed: C16.2, J10.1 (In)
unnamed: C17.1, J11.1 (In)
unnamed: C18.2, J12.1 (In)
unnamed: C19.1, J13.1 (In)
unnamed: C8.2, J14.1 (In)
unnamed: C30.1, J15.1 (In)
unnamed: J16.1, J16.2, Q1.2 (G), Q1.5 (G), R12.1
unnamed: C31.2, J17.1 (In)
unnamed: C33.1, J18.1 (In)
unnamed: J19.1, J19.2, Q2.2 (G), Q2.5 (G), R16.1
unnamed: J37.1 (In), J38.1 (In)
unnamed: C63.2, J47.1 (In)
unnamed: C69.1, J48.1 (In)
unnamed: C67.2, J51.1 (In)
unnamed: C70.1, J52.1 (In)
unnamed: L1.2, L2.1, R4.1
unnamed: L4.2, R3.1, R17.1, R21.2
unnamed: L8.1, L9.2, R6.1
unnamed: Q1.6 (D), R11.2
unnamed: Q1.3 (D), R10.2
unnamed: Q2.6 (D), R15.2
unnamed: Q2.3 (D), R14.2
unnamed: Q4.6 (D), R2.2
unnamed: Q4.3 (D), R1.2
unnamed: R36.1, R37.2, R38.1, R48.2
unnamed: R39.2, R46.2, R47.1, R48.1
unnamed: C1.1, U1.2 (RFIN)
unnamed: C3.2, U1.5 (RFOUT)
unnamed: C23.2, C24.1, R29.1, R32.2, R33.1, R34.2, U2.3 (+)
unnamed: C22.2, R28.1, R30.2, R35.1, U2.2 (-)
unnamed: C26.2, C27.1, R40.2, R56.1, R57.2, R58.1, U2.5 (+)
unnamed: C25.2, R31.2, R41.1, R55.1, U2.6 (-)
VCC: C2.1, C5.1, C13.1, C28.1, C34.1, C35.1, J1.1, J1.2, L7.2, Q1.4 (S), Q2.4 (S), Q4.4 (S), R5.2, R7.1, R17.2, R34.1, R37.1, R43.2, R46.1, R57.1, U2.8 (V+)

Notes on the sheet:
Active PIN-Schottky
Switched PIN-Schottky
Biased PIN-Schottky
PIN-Schottky
Biased PIN

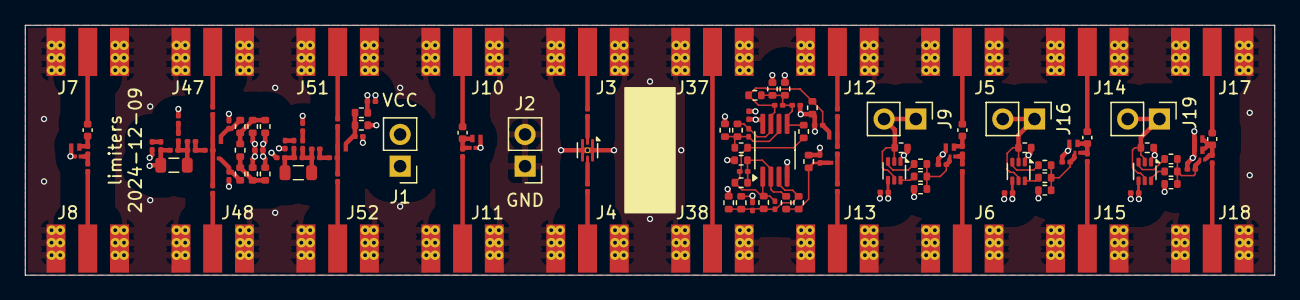
[picture p12: board limiters.kicad_pcb from above]

Board: 4 copper layers, 100.0 x 20.0 mm, 143 parts (0 on the bottom side), 67 nets.
