greatscottgadgets/misc/evaluation-boards/passives/passives.kicad_pcb

## KiCad design evaluation-boards/passives/passives.kicad_pcb (2024-12-09)

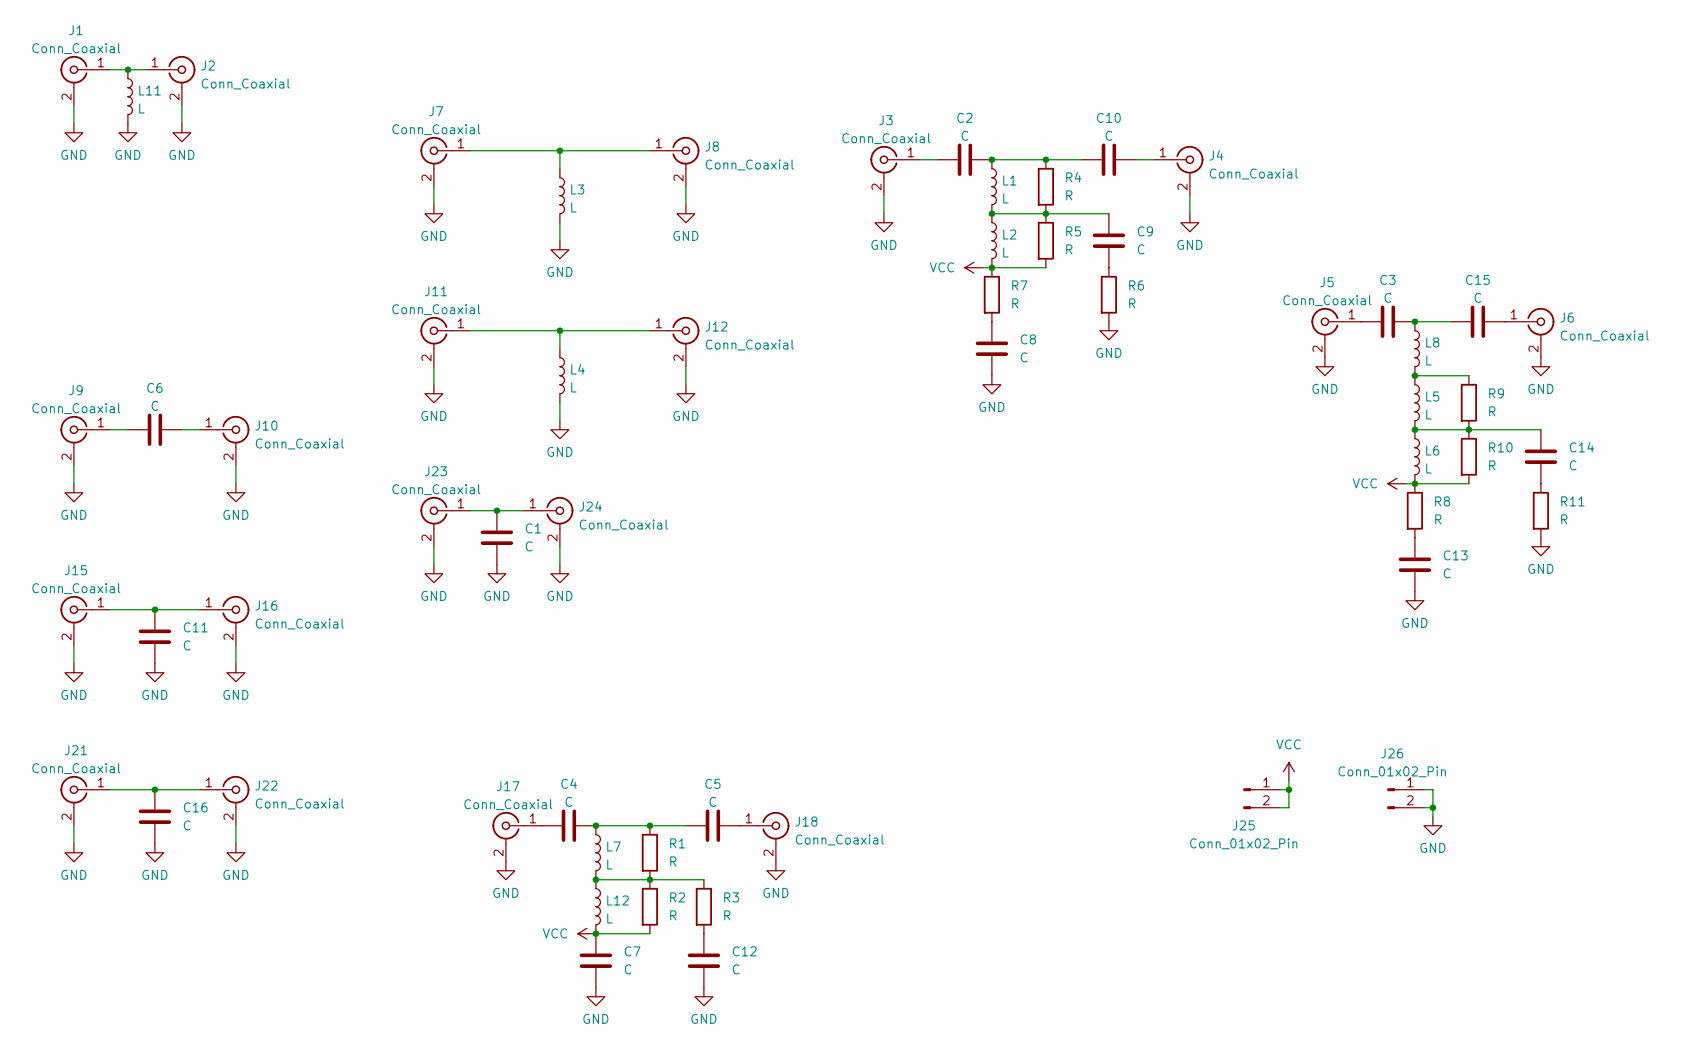
[picture p13: schematic passives.kicad_sch]

Parts:
C1, C2, C3, C4, C5, C8, C9, C10, C11, C13, C14, C15: C; C_0201_0603Metric
C6, C7, C12, C16: C; C_0402_1005Metric
J1, J2, J3, J4, J5, J6, J7, J8, J9, J10, J11, J12, J15, J16, J17, J18, J21, J22, J23, J24: Conn_Coaxial; Linx_SMA_CONSMA003.062
J25, J26: Conn_01x02_Pin; PinHeader_1x02_P2.54mm_Vertical
L1, L5, L8: L; L_0201_0603Metric
L2, L4, L6: L; L_0805_2012Metric
L3, L7, L11, L12: L; L_0603_1608Metric
R1, R2, R3: R; R_0402_1005Metric
R4, R5, R6, R7, R8, R9, R10, R11: R; R_0201_0603Metric

Connections:
GND: C1.1, C7.1, C8.1, C11.1, C12.1, C13.1, C16.1, J1.2 (Ext), J2.2 (Ext), J3.2 (Ext), J4.2 (Ext), J5.2 (Ext), J6.2 (Ext), J7.2 (Ext), J8.2 (Ext), J9.2 (Ext), J10.2 (Ext), J11.2 (Ext), J12.2 (Ext), J15.2 (Ext), J16.2 (Ext), J17.2 (Ext), J18.2 (Ext), J21.2 (Ext), J22.2 (Ext), J23.2 (Ext), J24.2 (Ext), J26.1, J26.2, L3.2, L4.2, L11.2, R6.2, R11.2
unnamed: C4.2, C5.1, L7.1, R1.1
unnamed: C8.2, R7.2
unnamed: C9.1, R6.1
unnamed: C9.2, L1.2, L2.1, R4.2, R5.1
unnamed: C2.2, C10.1, L1.1, R4.1
unnamed: C12.2, R3.2
unnamed: C13.2, R8.2
unnamed: C14.1, R11.1
unnamed: C14.2, L5.2, L6.1, R9.2, R10.1
unnamed: C3.2, C15.1, L8.1
unnamed: J1.1 (In), J2.1 (In), L11.1
unnamed: C2.1, J3.1 (In)
unnamed: C10.2, J4.1 (In)
unnamed: C3.1, J5.1 (In)
unnamed: C15.2, J6.1 (In)
unnamed: J7.1 (In), J8.1 (In), L3.1
unnamed: C6.1, J9.1 (In)
unnamed: C6.2, J10.1 (In)
unnamed: J11.1 (In), J12.1 (In), L4.1
unnamed: C11.2, J15.1 (In), J16.1 (In)
unnamed: C4.1, J17.1 (In)
unnamed: C5.2, J18.1 (In)
unnamed: C16.2, J21.1 (In), J22.1 (In)
unnamed: C1.2, J23.1 (In), J24.1 (In)
unnamed: L5.1, L8.2, R9.1
unnamed: L7.2, L12.1, R1.2, R2.1, R3.1
VCC: C7.2, J25.1, J25.2, L2.2, L6.2, L12.2, R2.2, R5.2, R7.1, R8.1, R10.2

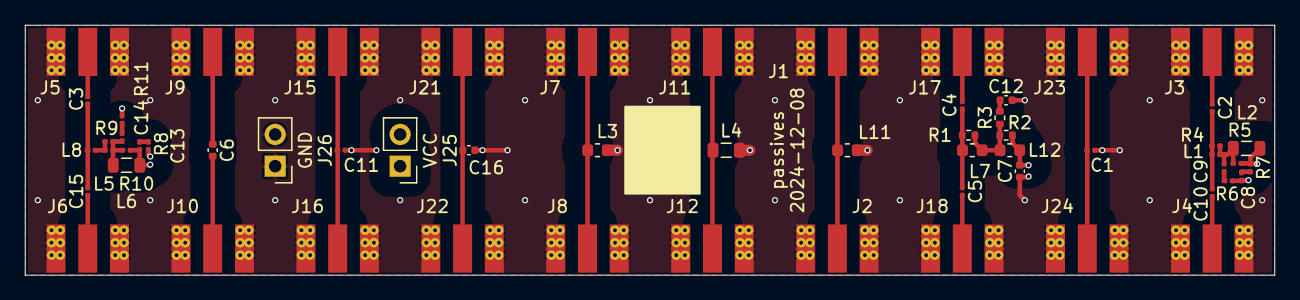
[picture p14: board passives.kicad_pcb from above]

Board: 4 copper layers, 100.0 x 20.0 mm, 59 parts (0 on the bottom side), 28 nets.
