greatscottgadgets/misc/evaluation-boards/rf-switch-sp4t/rf-switch-sp4t.kicad_pcb

## KiCad design evaluation-boards/rf-switch-sp4t/rf-switch-sp4t.kicad_pcb (2024-11-12)

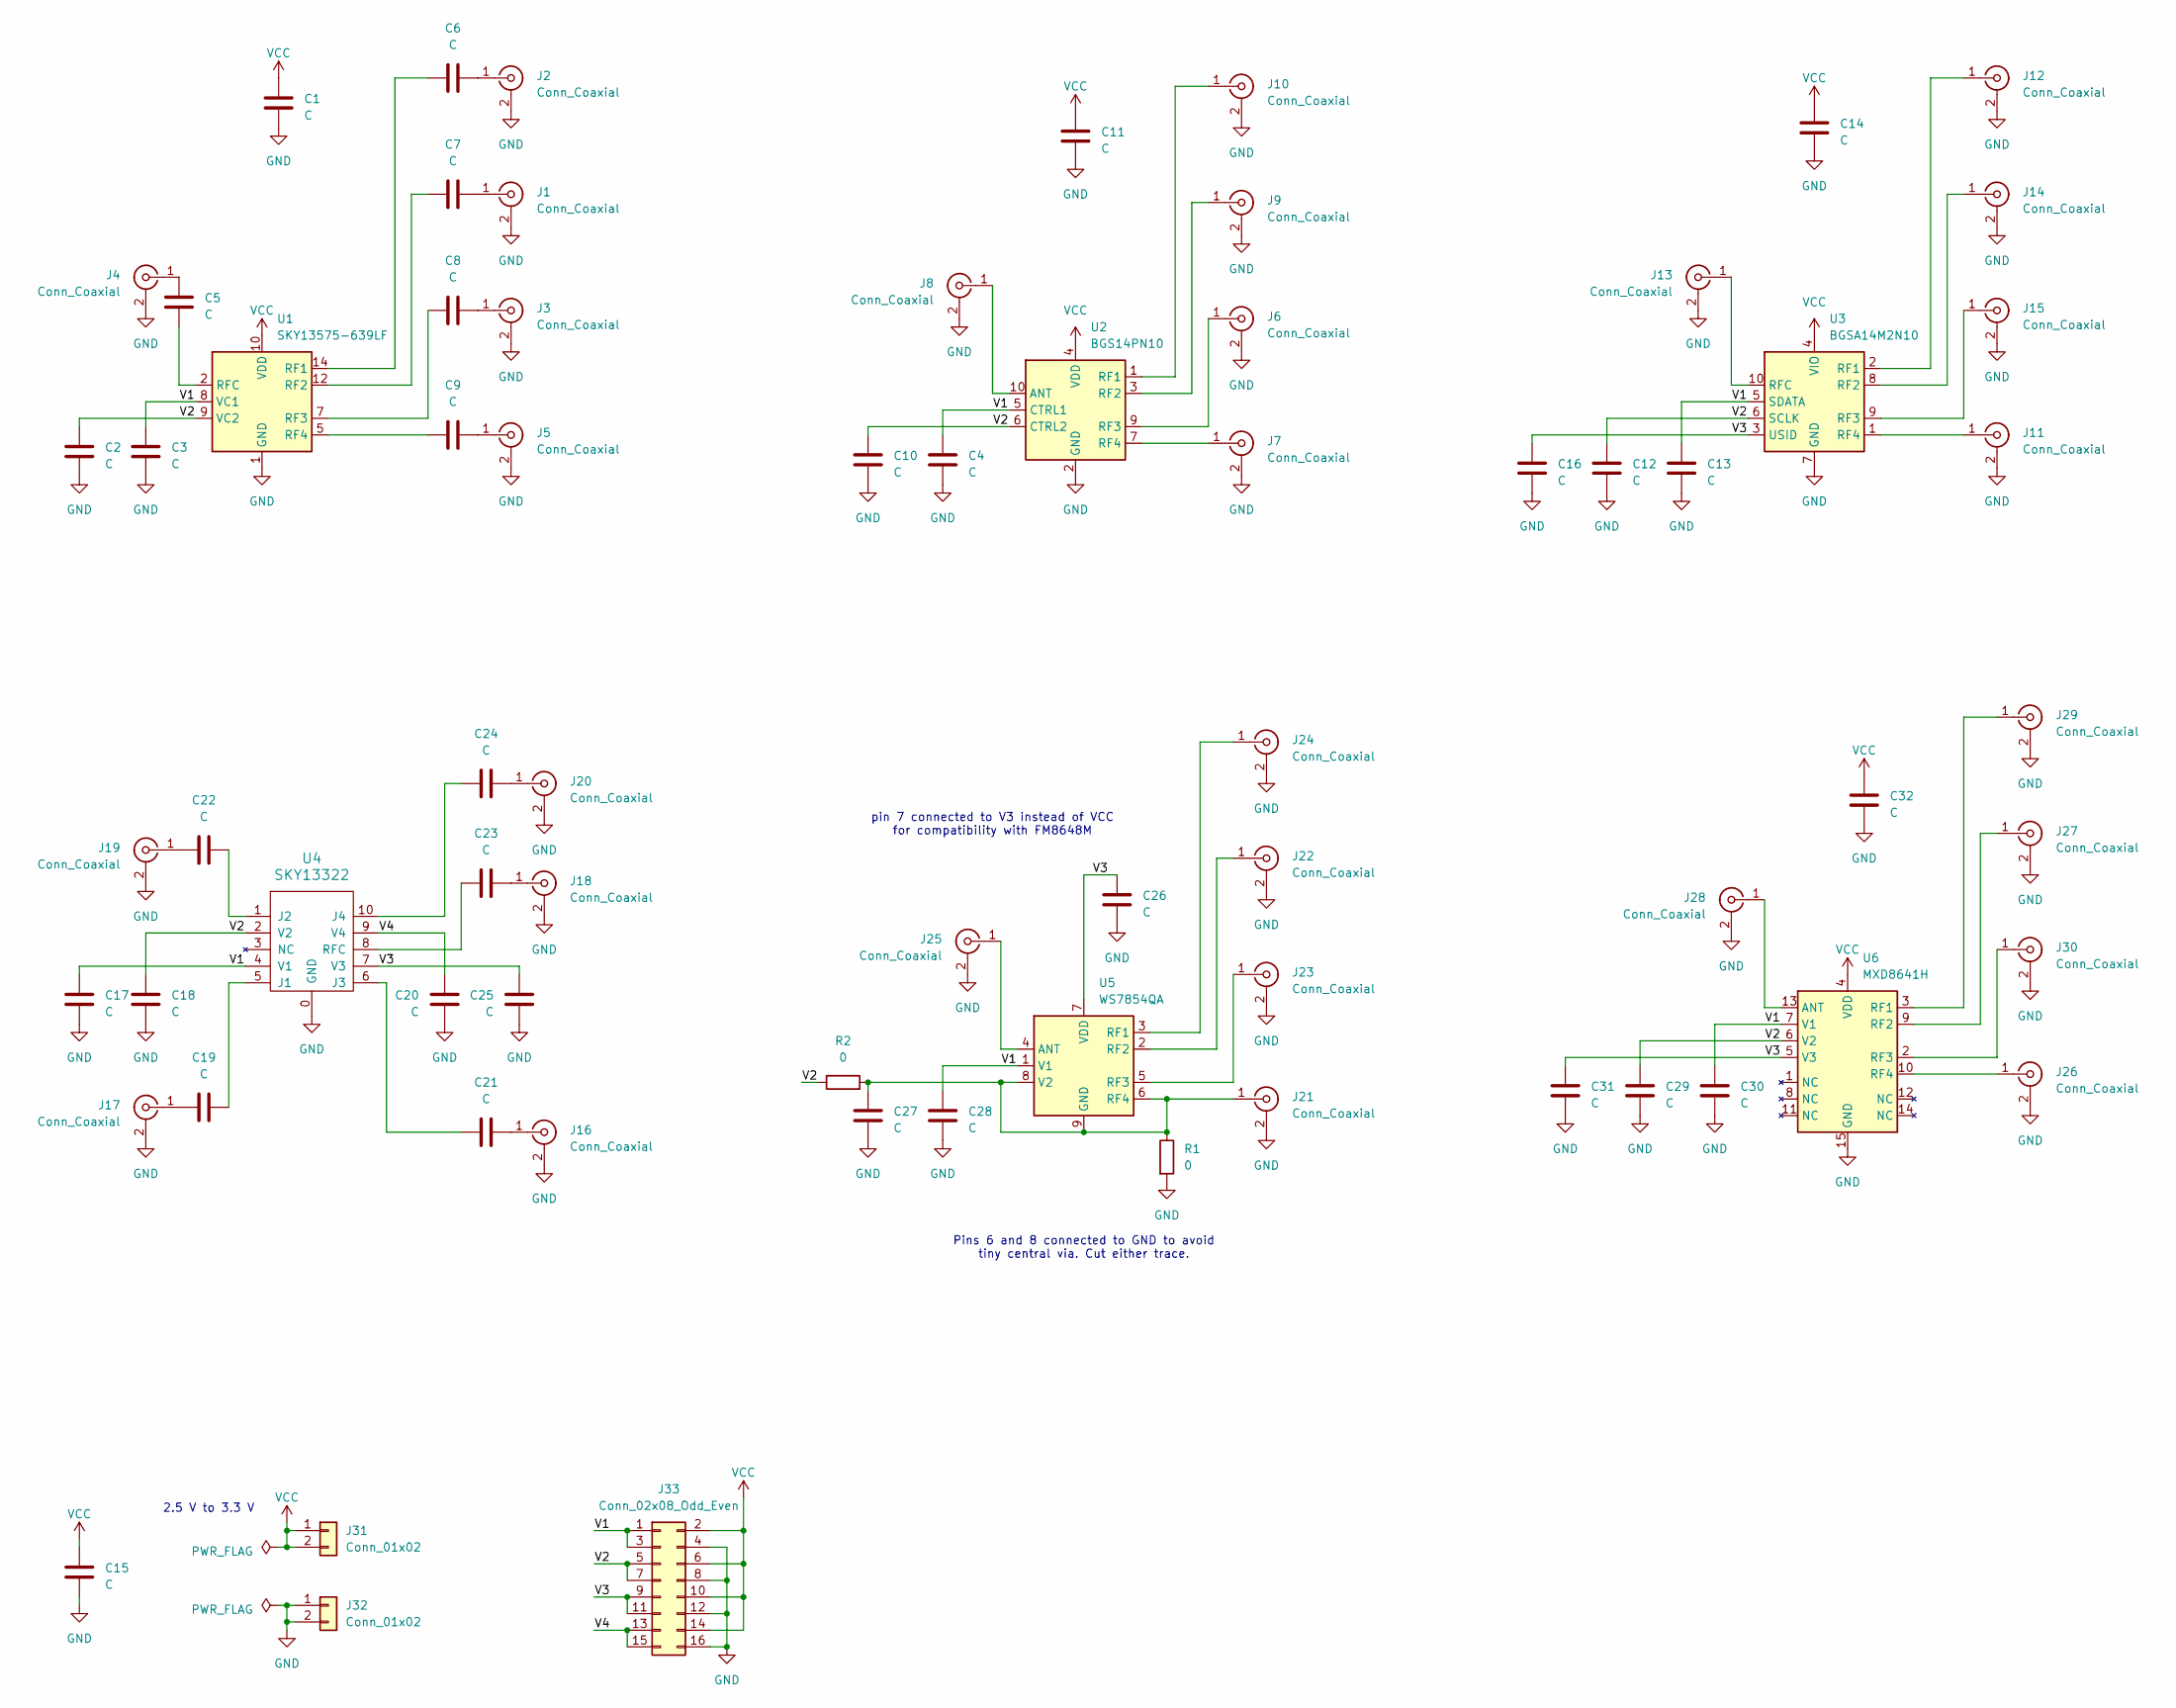
[picture p15: schematic rf-switch-sp4t.kicad_sch, ${TITLE}]

Parts:
C1, C2, C3, C4, C5, C6, C7, C8, C9, C10, C11, C12, C13, C14, C15, C16, C17, C18, C19, C20, C21, C22, C23, C24, C25, C26, C27, C28, C29, C30, C31, C32: C; C_0201_0603Metric
J1, J2, J3, J4, J5, J6, J7, J8, J9, J10, J11, J12, J13, J14, J15, J16, J17, J18, J19, J20, J21, J22, J23, J24, J25, J26, J27, J28, J29, J30: Conn_Coaxial; Linx_SMA_CONSMA003.062
J31, J32: Conn_01x02; PinHeader_1x02_P2.54mm_Vertical
J33: Conn_02x08_Odd_Even; PinHeader_2x08_P2.54mm_Vertical
R1, R2: 0; R_0201_0603Metric
U1: SKY13575-639LF; Skyworks_SKY13575_639LF
U2: BGS14PN10; ATSLP-10-50
U3: BGSA14M2N10; TSNP-10-10
U4: SKY13322; SKY13322-375LF
U5: WS7854QA; TSNP-9-3
U6: MXD8641H; SKY13414

Connections:
/V1: C3.1, C4.1, C13.1, C17.1, C28.1, C30.1, J33.1, J33.3, U1.8 (VC1), U2.5 (CTRL1), U3.5 (SDATA), U4.4 (V1), U5.1 (V1), U6.7 (V1)
/V2: C2.1, C10.1, C12.1, C18.1, C29.1, J33.5, J33.7, R2.1, U1.9 (VC2), U2.6 (CTRL2), U3.6 (SCLK), U4.2 (V2), U6.6 (V2)
/V3: C16.1, C25.1, C26.1, C31.1, J33.9, J33.11, U3.3 (USID), U4.7 (V3), U5.7 (VDD), U6.5 (V3)
/V4: C20.1, J33.13, J33.15, U4.9 (V4)
GND: C1.2, C2.2, C3.2, C4.2, C10.2, C11.2, C12.2, C13.2, C14.2, C15.2, C16.2, C17.2, C18.2, C20.2, C25.2, C26.2, C27.2, C28.2, C29.2, C30.2, C31.2, C32.2, J1.2 (Ext), J2.2 (Ext), J3.2 (Ext), J4.2 (Ext), J5.2 (Ext), J6.2 (Ext), J7.2 (Ext), J8.2 (Ext), J9.2 (Ext), J10.2 (Ext), J11.2 (Ext), J12.2 (Ext), J13.2 (Ext), J14.2 (Ext), J15.2 (Ext), J16.2 (Ext), J17.2 (Ext), J18.2 (Ext), J19.2 (Ext), J20.2 (Ext), J21.2 (Ext), J22.2 (Ext), J23.2 (Ext), J24.2 (Ext), J25.2 (Ext), J26.2 (Ext), J27.2 (Ext), J28.2 (Ext), J29.2 (Ext), J30.2 (Ext), J32.1, J32.2, J33.4, J33.8, J33.12, J33.16, R1.2, U1.1 (GND), U1.3 (GND), U1.4 (GND), U1.6 (GND), U1.11 (GND), U1.13 (GND), U1.15 (GND), U2.2 (GND), U2.8 (GND), U3.7 (GND), U4.0 (GND), U6.15 (GND)
unnamed: C7.2, J1.1 (In)
unnamed: C6.2, J2.1 (In)
unnamed: C8.2, J3.1 (In)
unnamed: C5.1, J4.1 (In)
unnamed: C9.2, J5.1 (In)
unnamed: J6.1 (In), U2.9 (RF3)
unnamed: J7.1 (In), U2.7 (RF4)
unnamed: J8.1 (In), U2.10 (ANT)
unnamed: J9.1 (In), U2.3 (RF2)
unnamed: J10.1 (In), U2.1 (RF1)
unnamed: J11.1 (In), U3.1 (RF4)
unnamed: J12.1 (In), U3.2 (RF1)
unnamed: J13.1 (In), U3.10 (RFC)
unnamed: J14.1 (In), U3.8 (RF2)
unnamed: J15.1 (In), U3.9 (RF3)
unnamed: C21.2, J16.1 (In)
unnamed: C19.1, J17.1 (In)
unnamed: C23.2, J18.1 (In)
unnamed: C22.2, J19.1 (In)
unnamed: C24.2, J20.1 (In)
unnamed: C27.1, J21.1 (In), R1.1, R2.2, U5.6 (RF4), U5.8 (V2), U5.9 (GND)
unnamed: J22.1 (In), U5.2 (RF2)
unnamed: J23.1 (In), U5.5 (RF3)
unnamed: J24.1 (In), U5.3 (RF1)
unnamed: J25.1 (In), U5.4 (ANT)
unnamed: J26.1 (In), U6.10 (RF4)
unnamed: J27.1 (In), U6.9 (RF2)
unnamed: J28.1 (In), U6.13 (ANT)
unnamed: J29.1 (In), U6.3 (RF1)
unnamed: J30.1 (In), U6.2 (RF3)
unnamed: C6.1, U1.14 (RF1)
unnamed: C7.1, U1.12 (RF2)
unnamed: C8.1, U1.7 (RF3)
unnamed: C9.1, U1.5 (RF4)
unnamed: C5.2, U1.2 (RFC)
unnamed: C19.2, U4.5 (J1)
unnamed: C22.1, U4.1 (J2)
unnamed: C21.1, U4.6 (J3)
unnamed: C24.1, U4.10 (J4)
unnamed: C23.1, U4.8 (RFC)
VCC: C1.1, C11.1, C14.1, C15.1, C32.1, J31.1, J31.2, J33.2, J33.6, J33.10, J33.14, U1.10 (VDD), U2.4 (VDD), U3.4 (VIO), U6.4 (VDD)

Notes on the sheet:
2.5 V to 3.3 V
pin 7 connected to V3 instead of VCC for compatibility with FM8648M
Pins 6 and 8 connected to GND to avoid tiny central via. Cut either trace.

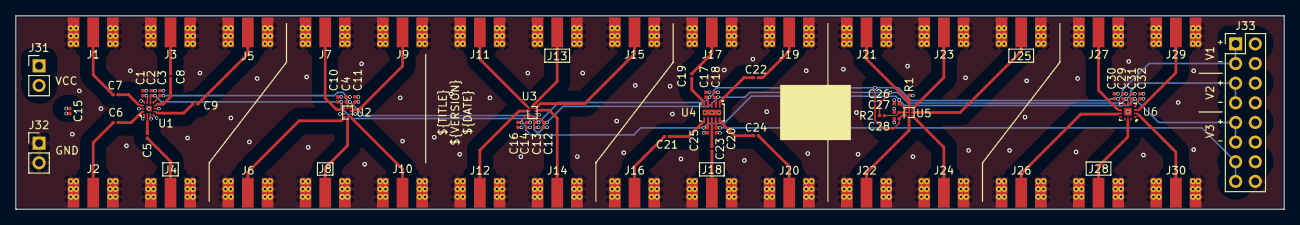
[picture p16: board rf-switch-sp4t.kicad_pcb from above]

Board: 4 copper layers, 164.0 x 25.0 mm, 73 parts (0 on the bottom side), 46 nets.
