greatscottgadgets/misc/evaluation-boards/rf-switch-sp3t/rf-switch-sp3t.kicad_pcb

## KiCad design evaluation-boards/rf-switch-sp3t/rf-switch-sp3t.kicad_pcb (2024-11-12)

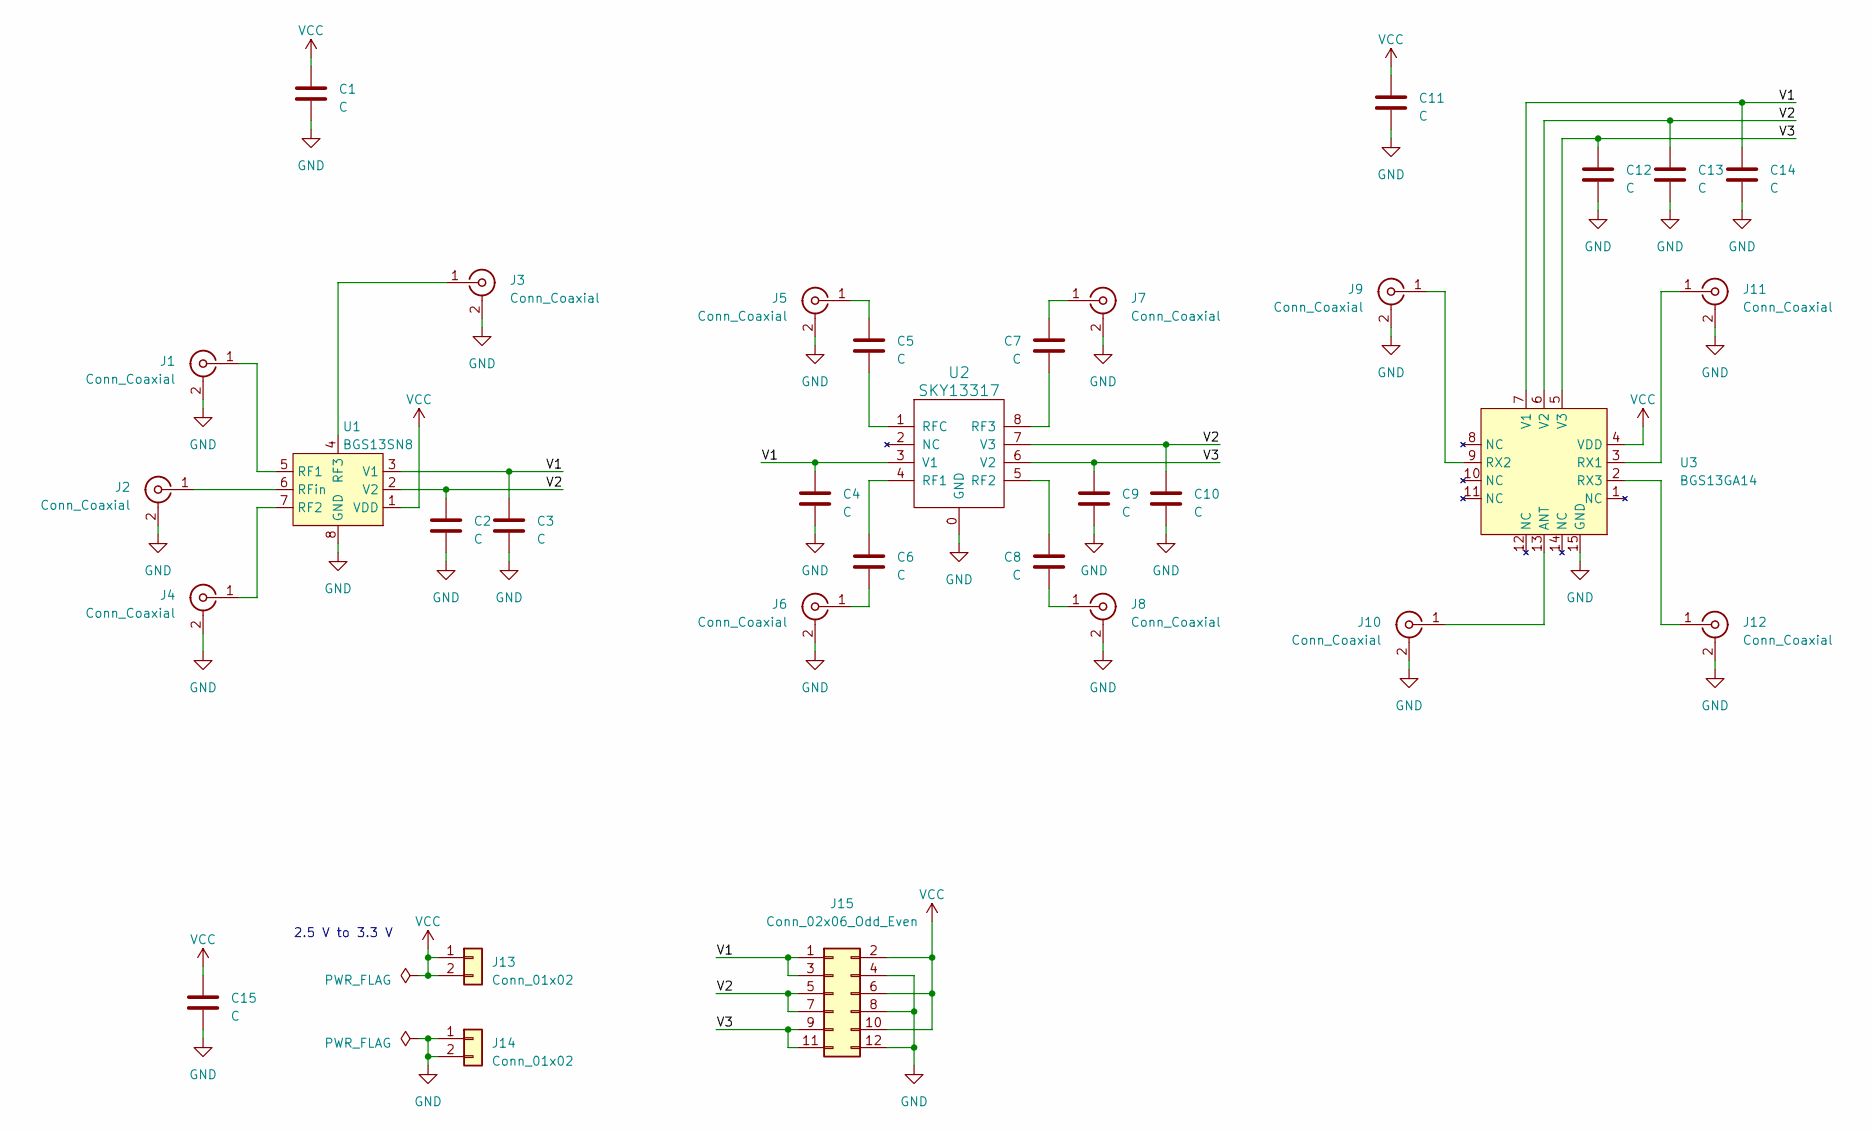
[picture p17: schematic rf-switch-sp3t.kicad_sch, ${TITLE}]

Parts:
C1, C2, C3, C4, C5, C6, C7, C8, C9, C10, C11, C12, C13, C14, C15: C; C_0201_0603Metric
J1, J2, J3, J4, J5, J6, J7, J8, J9, J10, J11, J12: Conn_Coaxial; Linx_SMA_CONSMA003.062
J13, J14: Conn_01x02; PinHeader_1x02_P2.54mm_Vertical
J15: Conn_02x06_Odd_Even; PinHeader_2x06_P2.54mm_Vertical
U1: BGS13SN8; TSNP-9-3
U2: SKY13317; SKY13317-373LF
U3: BGS13GA14; ATSLP-14-1EP_2x2mm_P0.4mm_EP1x1mm

Connections:
/V1: C3.1, C4.1, C14.1, J15.1, J15.3, U1.3 (V1), U2.3 (V1), U3.7 (V1)
/V2: C2.1, C10.1, C13.1, J15.5, J15.7, U1.2 (V2), U2.7 (V3), U3.6 (V2)
/V3: C9.1, C12.1, J15.9, J15.11, U2.6 (V2), U3.5 (V3)
GND: C1.2, C2.2, C3.2, C4.2, C9.2, C10.2, C11.2, C12.2, C13.2, C14.2, C15.2, J1.2 (Ext), J2.2 (Ext), J3.2 (Ext), J4.2 (Ext), J5.2 (Ext), J6.2 (Ext), J7.2 (Ext), J8.2 (Ext), J9.2 (Ext), J10.2 (Ext), J11.2 (Ext), J12.2 (Ext), J14.1, J14.2, J15.4, J15.8, J15.12, U1.8 (GND), U1.9 (GND), U2.0 (GND), U3.15 (GND)
unnamed: J1.1 (In), U1.5 (RF1)
unnamed: J2.1 (In), U1.6 (RFin)
unnamed: J3.1 (In), U1.4 (RF3)
unnamed: J4.1 (In), U1.7 (RF2)
unnamed: C5.1, J5.1 (In)
unnamed: C6.2, J6.1 (In)
unnamed: C7.1, J7.1 (In)
unnamed: C8.2, J8.1 (In)
unnamed: J9.1 (In), U3.9 (RX2)
unnamed: J10.1 (In), U3.13 (ANT)
unnamed: J11.1 (In), U3.3 (RX1)
unnamed: J12.1 (In), U3.2 (RX3)
unnamed: C6.1, U2.4 (RF1)
unnamed: C8.1, U2.5 (RF2)
unnamed: C7.2, U2.8 (RF3)
unnamed: C5.2, U2.1 (RFC)
VCC: C1.1, C11.1, C15.1, J13.1, J13.2, J15.2, J15.6, J15.10, U1.1 (VDD), U3.4 (VDD)

Notes on the sheet:
2.5 V to 3.3 V

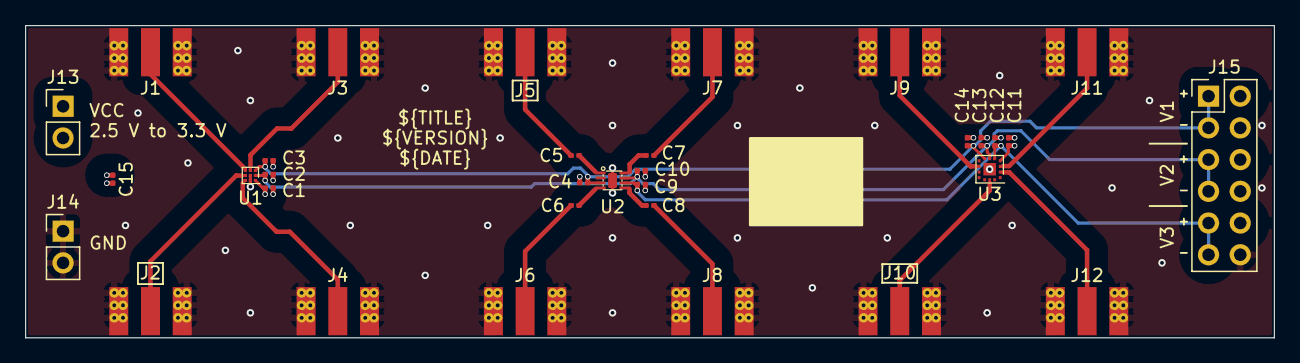
[picture p18: board rf-switch-sp3t.kicad_pcb from above]

Board: 4 copper layers, 100.0 x 25.0 mm, 33 parts (0 on the bottom side), 21 nets.
