greatscottgadgets/misc/evaluation-boards/rf-switch-spdt/rf-switch-spdt.kicad_pcb

## KiCad design evaluation-boards/rf-switch-spdt/rf-switch-spdt.kicad_pcb (2024-11-12)

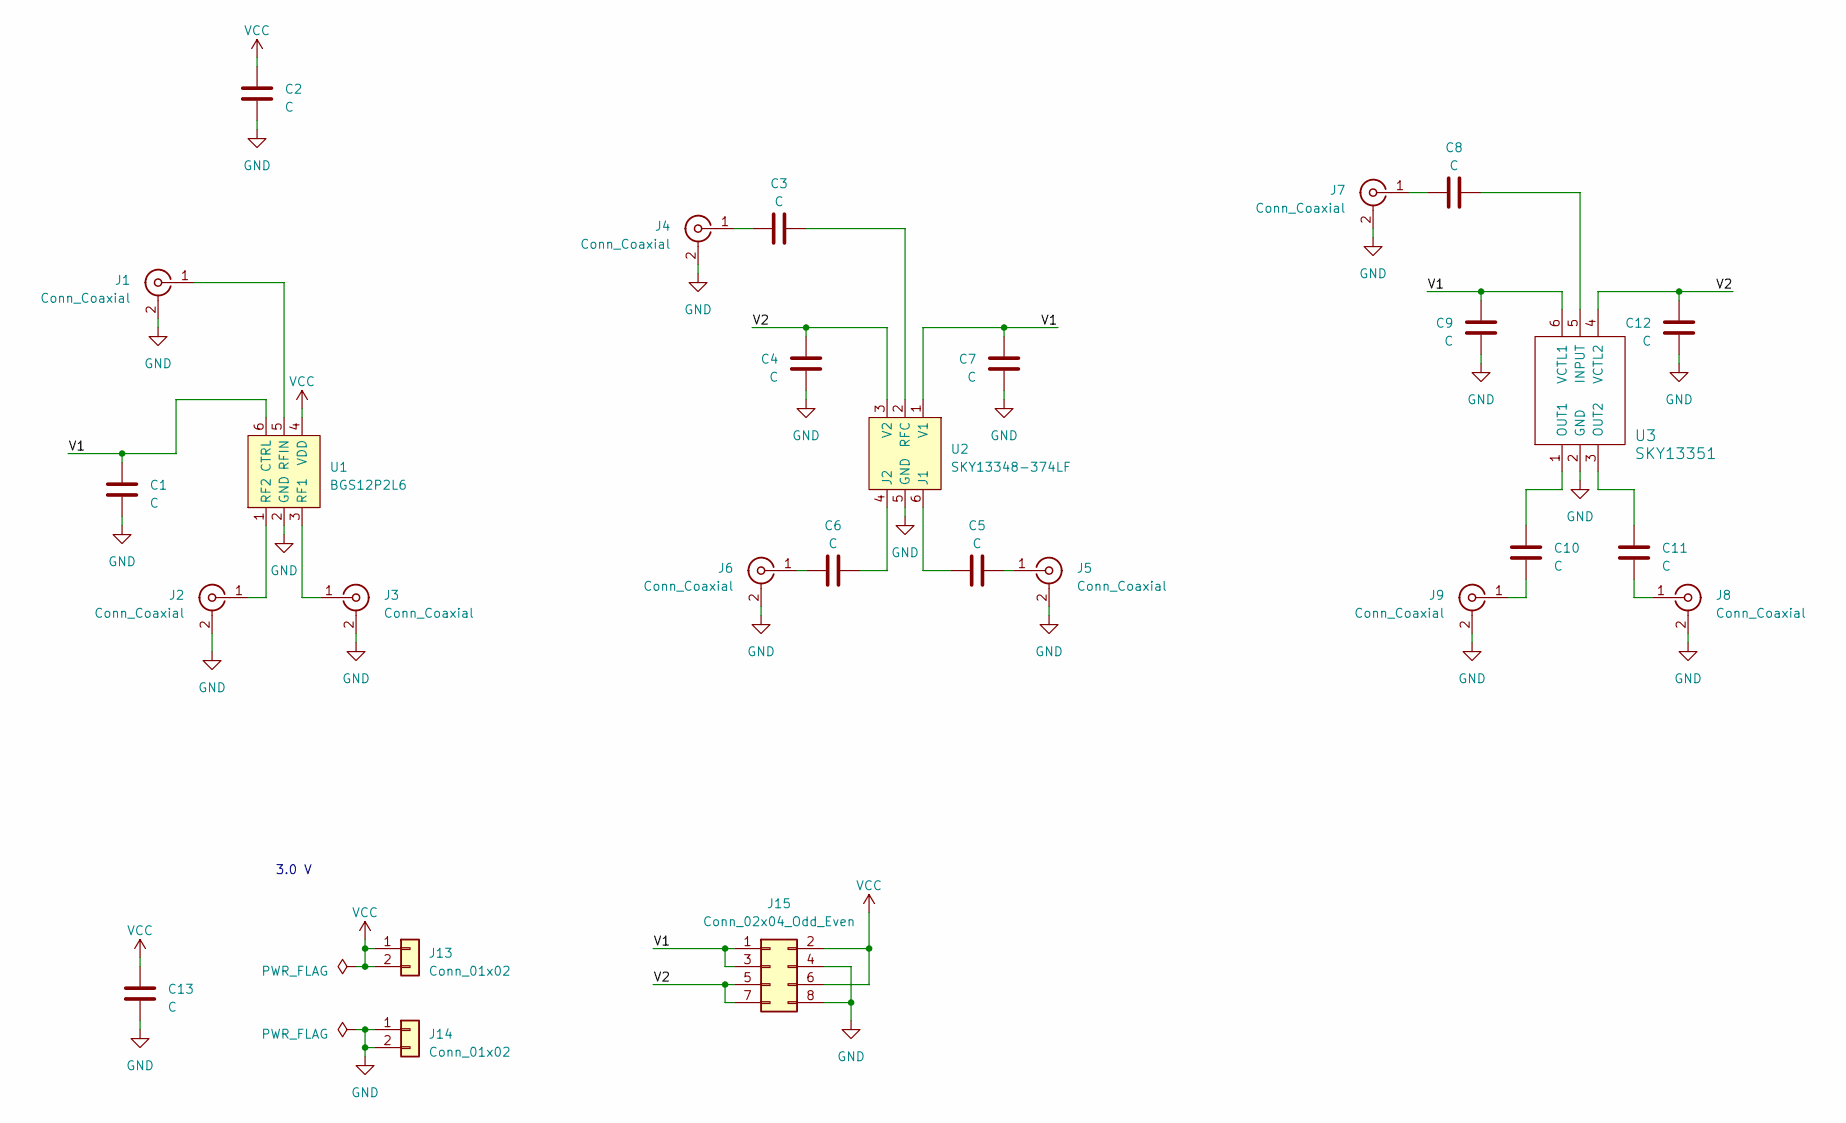
[picture p19: schematic rf-switch-spdt.kicad_sch, ${TITLE}]

Parts:
C1, C2, C3, C4, C5, C6, C7, C8, C9, C10, C11, C12, C13: C; C_0201_0603Metric
J1, J2, J3, J4, J5, J6, J7, J8, J9: Conn_Coaxial; Linx_SMA_CONSMA003.062
J13, J14: Conn_01x02; PinHeader_1x02_P2.54mm_Vertical
J15: Conn_02x04_Odd_Even; PinHeader_2x04_P2.54mm_Vertical
U1: BGS12P2L6; TSLP-6-4_1.1x0.7mm_P0.4mm
U2: SKY13348-374LF; Skyworks_SKY65404-31
U3: SKY13351; SKY13351-378LF

Connections:
/V1: C1.1, C7.1, C9.1, J15.1, J15.3, U1.6 (CTRL), U2.1 (V1), U3.6 (VCTL1)
/V2: C4.1, C12.1, J15.5, J15.7, U2.3 (V2), U3.4 (VCTL2)
GND: C1.2, C2.2, C4.2, C7.2, C9.2, C12.2, C13.2, J1.2 (Ext), J2.2 (Ext), J3.2 (Ext), J4.2 (Ext), J5.2 (Ext), J6.2 (Ext), J7.2 (Ext), J8.2 (Ext), J9.2 (Ext), J14.1, J14.2, J15.4, J15.8, U1.2 (GND), U2.5 (GND), U2.7 (GND), U3.2 (GND)
unnamed: J1.1 (In), U1.5 (RFIN)
unnamed: J2.1 (In), U1.1 (RF2)
unnamed: J3.1 (In), U1.3 (RF1)
unnamed: C3.1, J4.1 (In)
unnamed: C5.2, J5.1 (In)
unnamed: C6.1, J6.1 (In)
unnamed: C8.1, J7.1 (In)
unnamed: C11.2, J8.1 (In)
unnamed: C10.2, J9.1 (In)
unnamed: C5.1, U2.6 (J1)
unnamed: C6.2, U2.4 (J2)
unnamed: C3.2, U2.2 (RFC)
unnamed: C8.2, U3.5 (INPUT)
unnamed: C10.1, U3.1 (OUT1)
unnamed: C11.1, U3.3 (OUT2)
VCC: C2.1, C13.1, J13.1, J13.2, J15.2, J15.6, U1.4 (VDD)

Notes on the sheet:
3.0 V

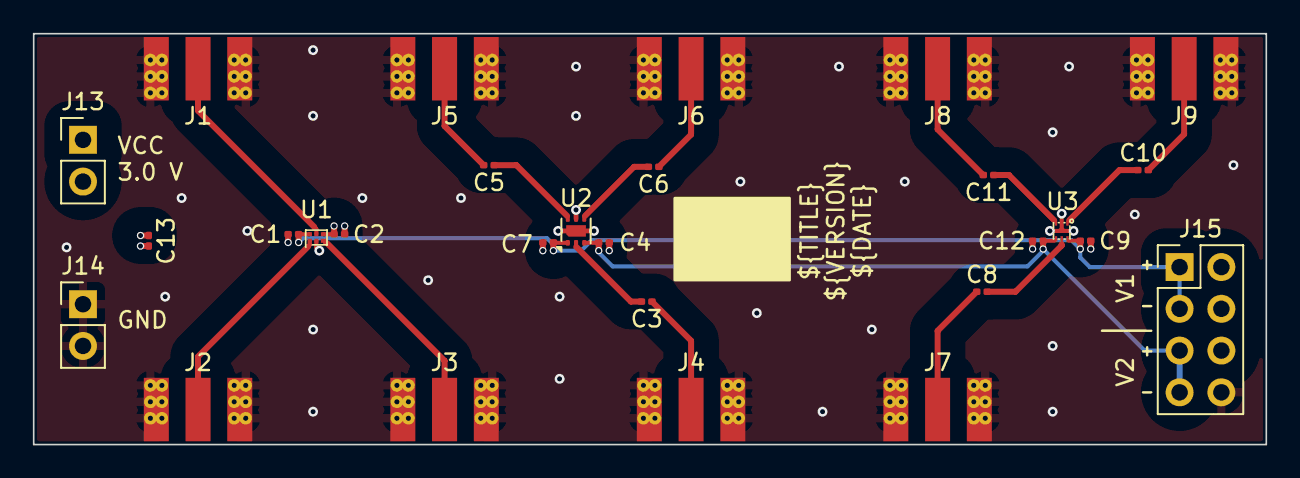
[picture p20: board rf-switch-spdt.kicad_pcb from above]

Board: 4 copper layers, 75.0 x 25.0 mm, 28 parts (0 on the bottom side), 19 nets.
