greatscottgadgets/misc/evaluation-boards/rf-switch-dpdt/rf-switch-dpdt.kicad_pcb

## KiCad design evaluation-boards/rf-switch-dpdt/rf-switch-dpdt.kicad_pcb (2023-04-22)

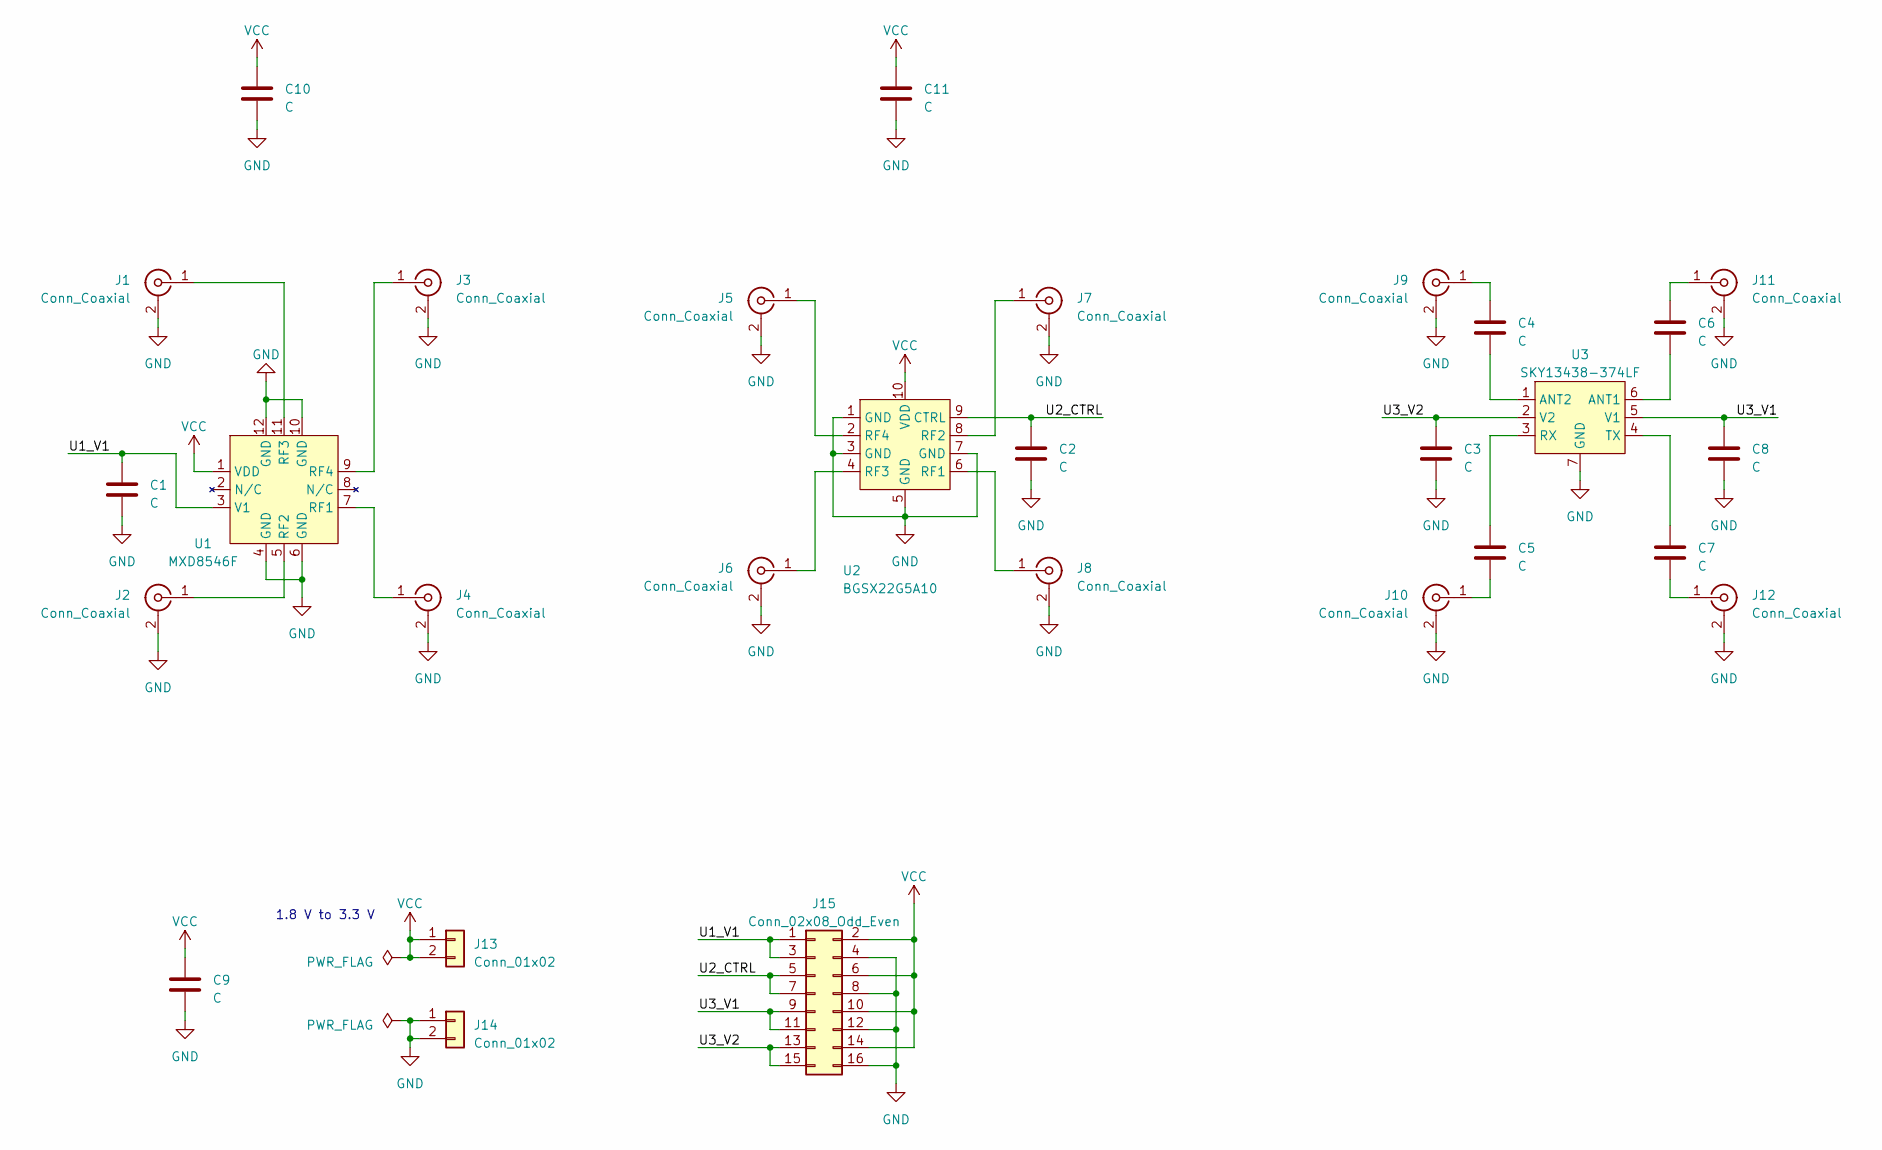
[picture p21: schematic rf-switch-dpdt.kicad_sch, ${TITLE}]

Parts:
C1, C2, C3, C4, C5, C6, C7, C8, C9, C10, C11: C; C_0402_1005Metric
J1, J2, J3, J4, J5, J6, J7, J8, J9, J10, J11, J12: Conn_Coaxial; CONSMA003.062
J13, J14: Conn_01x02; PinHeader_1x02_P2.54mm_Vertical
J15: Conn_02x08_Odd_Even; PinHeader_2x08_P2.54mm_Vertical
U1: MXD8546F; QFN-12-1EP_2x2mm_P0.5mm_EP1x1mm
U2: BGSX22G5A10; ATSLP-10-50
U3: SKY13438-374LF; Skyworks_SKY65404-31

Connections:
/U1_V1: C1.1, J15.1, J15.3, U1.3 (V1)
/U2_CTRL: C2.1, J15.5, J15.7, U2.9 (CTRL)
/U3_V1: C8.1, J15.9, J15.11, U3.5 (V1)
/U3_V2: C3.1, J15.13, J15.15, U3.2 (V2)
GND: C1.2, C2.2, C3.2, C8.2, C9.2, C10.2, C11.2, J1.2 (Ext), J2.2 (Ext), J3.2 (Ext), J4.2 (Ext), J5.2 (Ext), J6.2 (Ext), J7.2 (Ext), J8.2 (Ext), J9.2 (Ext), J10.2 (Ext), J11.2 (Ext), J12.2 (Ext), J14.1, J14.2, J15.4, J15.8, J15.12, J15.16, U1.4 (GND), U1.6 (GND), U1.10 (GND), U1.12 (GND), U1.13 (GND), U2.1 (GND), U2.3 (GND), U2.5 (GND), U2.7 (GND), U3.7 (GND)
unnamed: J1.1 (In), U1.11 (RF3)
unnamed: J2.1 (In), U1.5 (RF2)
unnamed: J3.1 (In), U1.9 (RF4)
unnamed: J4.1 (In), U1.7 (RF1)
unnamed: J5.1 (In), U2.2 (RF4)
unnamed: J6.1 (In), U2.4 (RF3)
unnamed: J7.1 (In), U2.8 (RF2)
unnamed: J8.1 (In), U2.6 (RF1)
unnamed: C4.1, J9.1 (In)
unnamed: C5.2, J10.1 (In)
unnamed: C6.1, J11.1 (In)
unnamed: C7.2, J12.1 (In)
unnamed: C6.2, U3.6 (ANT1)
unnamed: C4.2, U3.1 (ANT2)
unnamed: C5.1, U3.3 (RX)
unnamed: C7.1, U3.4 (TX)
VCC: C9.1, C10.1, C11.1, J13.1, J13.2, J15.2, J15.6, J15.10, J15.14, U1.1 (VDD), U2.10 (VDD)

Notes on the sheet:
1.8 V to 3.3 V

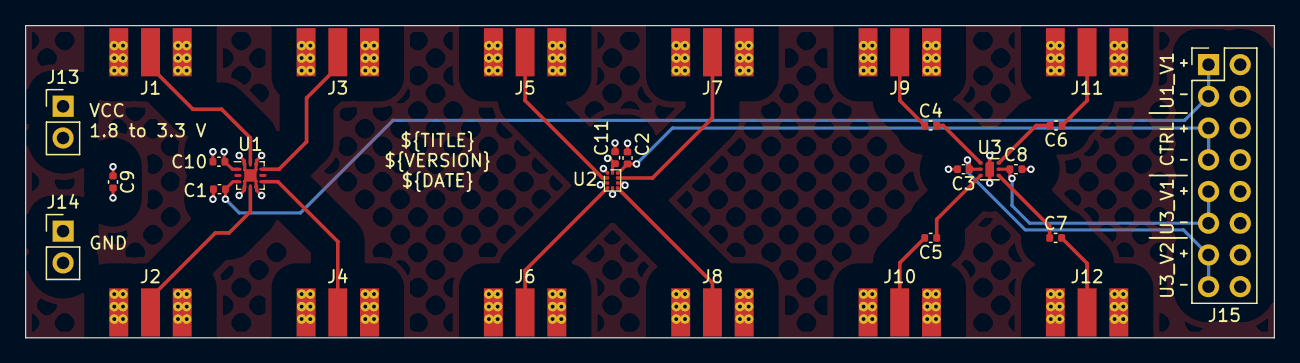
[picture p22: board rf-switch-dpdt.kicad_pcb from above]

Board: 4 copper layers, 100.0 x 25.0 mm, 29 parts (0 on the bottom side), 22 nets.
