greatscottgadgets/misc/evaluation-boards/vbus-switch/vbus-switch.kicad_pcb

## KiCad design evaluation-boards/vbus-switch/vbus-switch.kicad_pcb (2023-02-13)

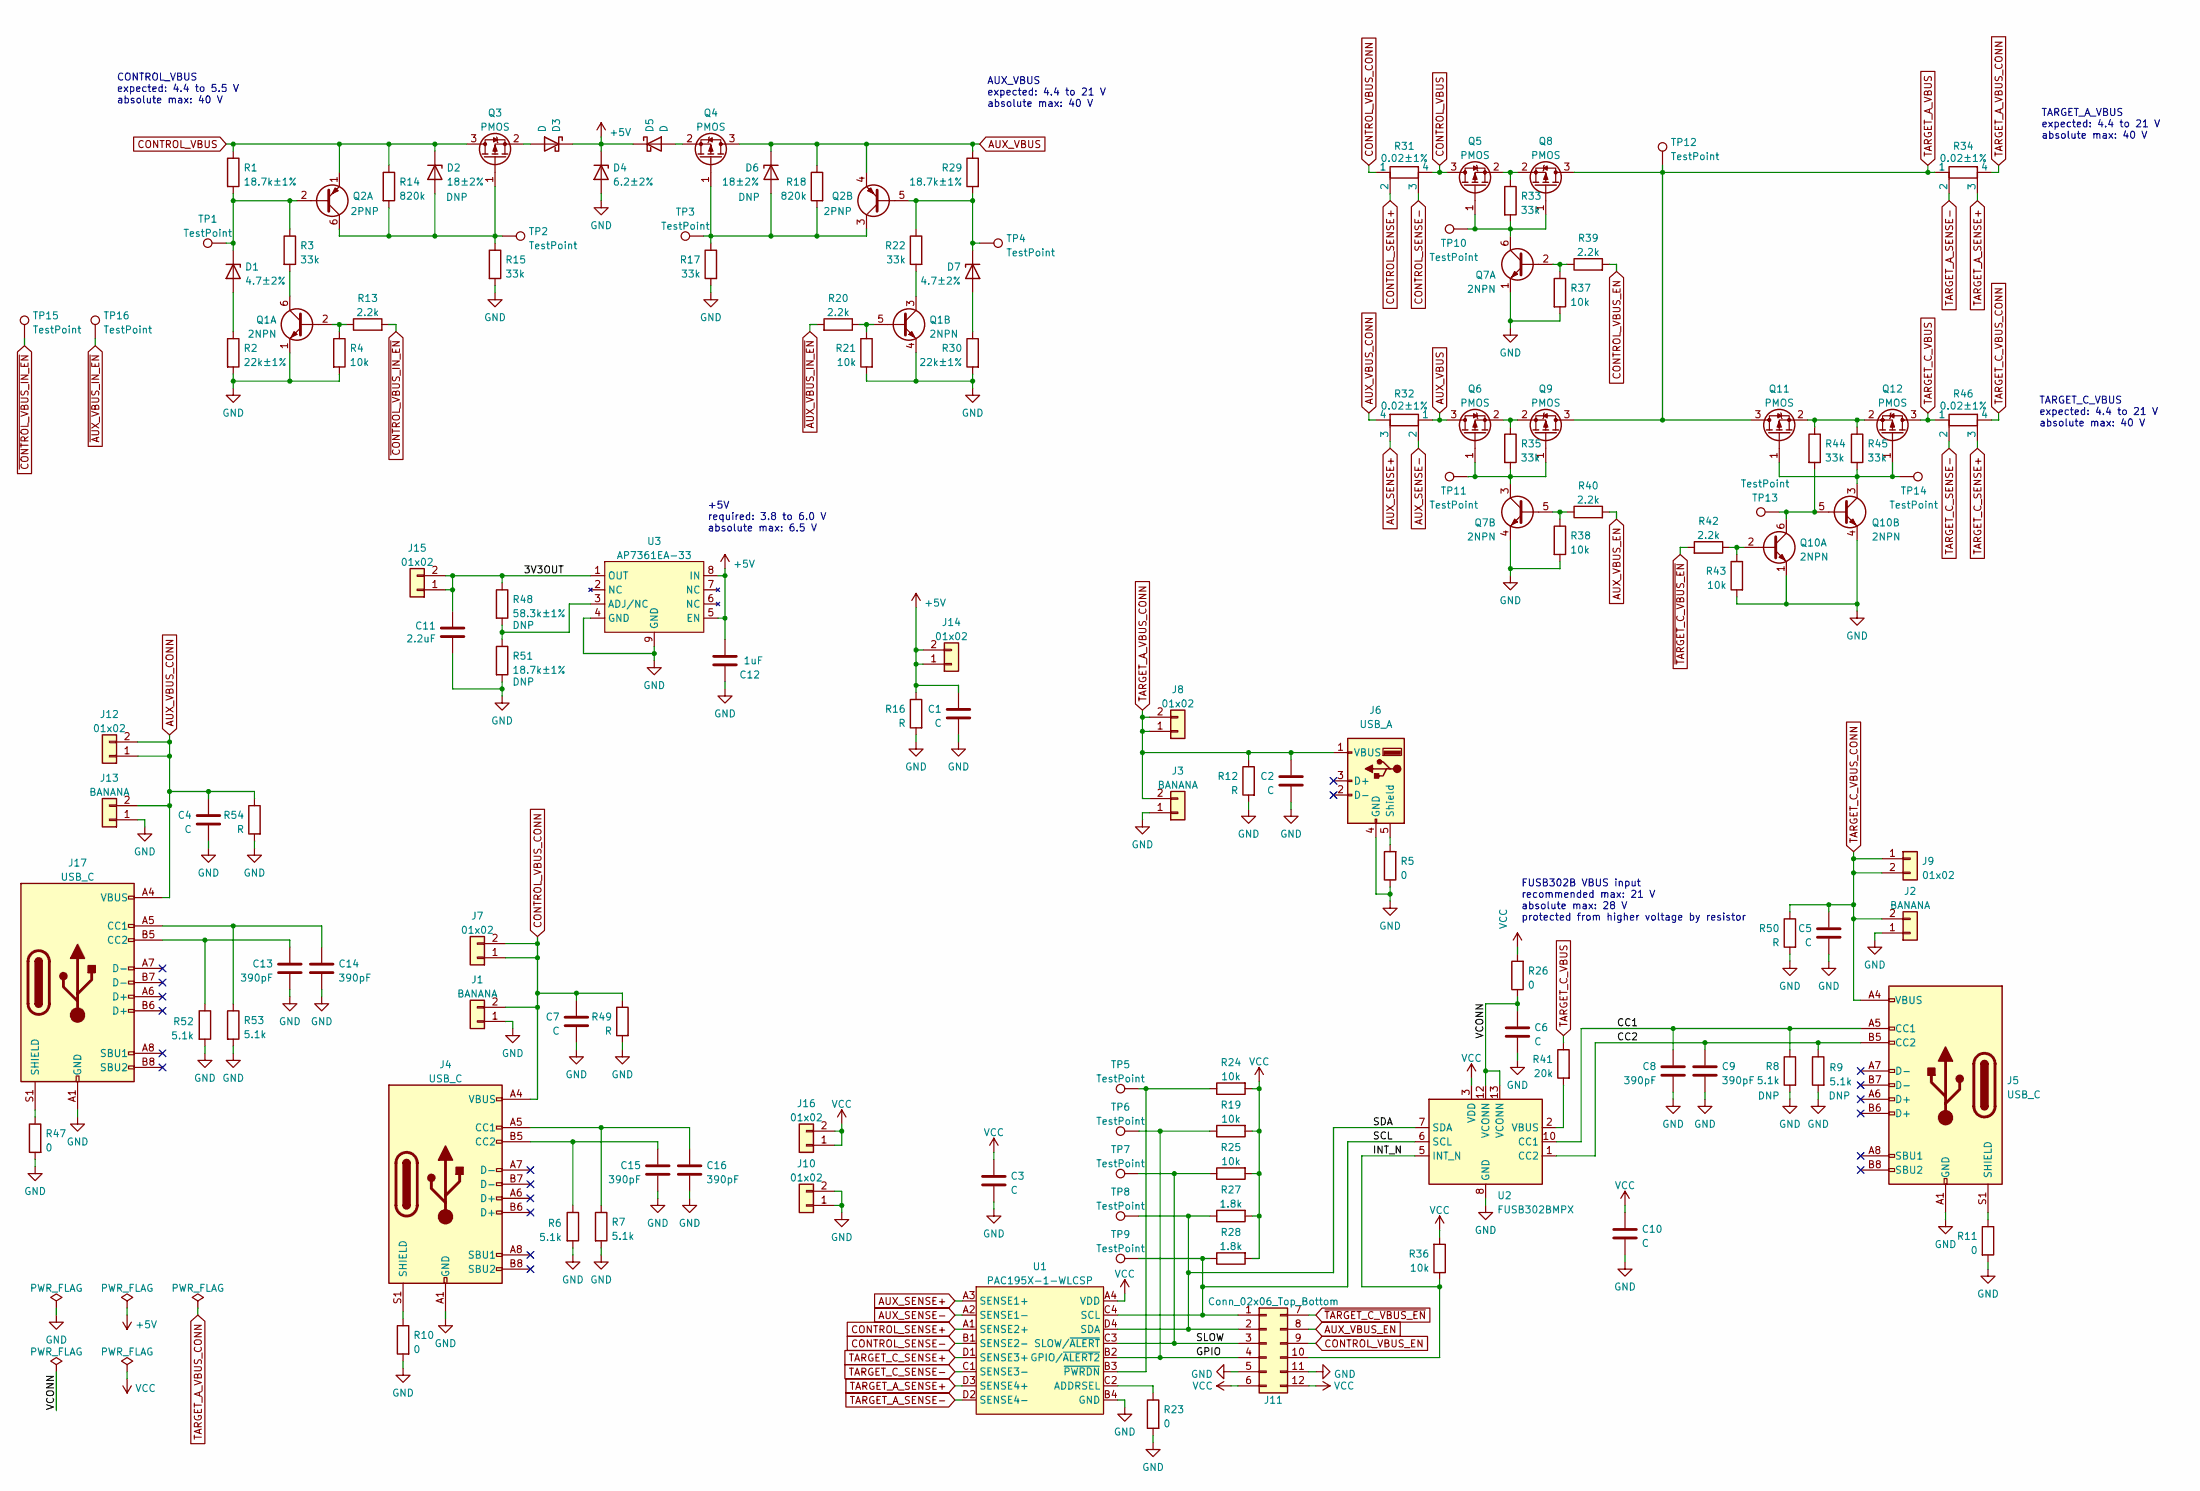
[picture p23: schematic vbus-switch.kicad_sch]

Parts:
C1, C2, C3, C4, C5, C6, C7, C10: C; C_0402_1005Metric
C8, C9, C13, C14, C15, C16: 390pF; C_0402_1005Metric
C11: 2.2uF; C_0603_1608Metric; Part Number CL10A225KP8NNNC
C12: 1uF; C_0603_1608Metric; Part Number GENERIC-CAP-0603-1uF
D1, D7: 4.7±2%; DFN1006-2; Part Number BZX884-B4V7,315
D2, D6: 18±2%; DFN1006-2; Part Number BZX884-B18,315
D3, D5: D; D_SOD-123F; Part Number PMEG10010ELRX
D4: 6.2±2%; DFN1006-2; Part Number BZX884-B6V2,315
J1, J2, J3, J13: BANANA; Banana_Jack_2Pin
J4, J5, J17: USB_C; USB_C_Receptacle_HRO_TYPE-C-31-M-12; Part Number U262-161N-4BVC11
J6: USB_A; USB_A_Kycon_KUSBXHT-SB-AS1N-B30-NF_Horizontal; Part Number C42411
J7, J8, J9, J10, J12, J14, J15, J16: 01x02; PinHeader_1x02_P2.54mm_Vertical
J11: Conn_02x06_Top_Bottom; PinHeader_2x06_P2.54mm_PMOD
Q1, Q7, Q10: 2NPN; SOT-363_SC-70-6; Part Number BC847BS
Q2: 2PNP; SOT-363_SC-70-6; Part Number BCM857BS
Q3, Q4, Q5, Q6, Q8, Q9, Q11, Q12: PMOS; SOT-23-3; Part Number PJA3441_R1_00001
R1, R29, R51: 18.7k±1%; R_0402_1005Metric
R2, R30: 22k±1%; R_0402_1005Metric
R3, R15, R17, R22, R33, R35, R44, R45: 33k; R_0402_1005Metric
R4, R19, R21, R24, R25, R36, R37, R38, R43: 10k; R_0402_1005Metric
R5, R10, R11, R23, R26, R47: 0; R_0402_1005Metric
R6, R7, R8, R9, R52, R53: 5.1k; R_0402_1005Metric
R12, R16, R49, R50, R54: R; R_0402_1005Metric
R13, R20, R39, R40, R42: 2.2k; R_0402_1005Metric
R14, R18: 820k; R_0402_1005Metric
R27, R28: 1.8k; R_0402_1005Metric
R31, R32, R34, R46: 0.02±1%; R_0603_1608Metric_Current_Sense; Part Number ERJ-3BWFR020V
R41: 20k; R_0402_1005Metric
R48: 58.3k±1%; R_0402_1005Metric
TP1, TP2, TP3, TP4, TP5, TP6, TP7, TP8, TP9, TP10, TP11, TP12, TP13, TP14, TP15, TP16: TestPoint; TestPoint_Pad_D1.5mm
U1: PAC195X-1-WLCSP; WLCSP-16_2.225x2.170mm_Layout4x4_P0.5mm; Part Number PAC1954T-E/J6CX
U2: FUSB302BMPX; WQFN-14-1EP_2.5x2.5mm_P0.5mm_EP1.45x1.45mm; Part Number FUSB302BMPX
U3: AP7361EA-33; DFN-8-1EP_3x3mm_P0.65mm_EP1.55x2.4mm; Part Number AP7361EA-33FGE-7

Connections:
+5V: C1.1, C12.2, D3.1 (K), D4.1 (K), D5.1 (K), J14.1, J14.2, R16.1, U3.5 (EN), U3.8 (IN)
/3V3OUT: C11.1, J15.1, J15.2, R48.1, U3.1 (OUT)
/CC1: C8.2, J5.A5 (CC1), R8.1, U2.10 (CC1), U2.11 (CC1)
/CC2: C9.1, J5.B5 (CC2), R9.1, U2.1 (CC2), U2.14 (CC2)
/GPIO: J11.4, R19.1, TP6.1, U1.B2 (GPIO/~ALERT2)
/INT_N: J11.10, R36.1, U2.5 (INT_N)
/SCL: J11.1, R28.1, TP9.1, U1.C4 (SCL), U2.6 (SCL)
/SDA: J11.2, R27.1, TP8.1, U1.D4 (SDA), U2.7 (SDA)
/SLOW: J11.3, R25.1, TP7.1, U1.C3 (SLOW/~ALERT)
/VCONN: C6.1, R26.1, U2.12 (VCONN), U2.13 (VCONN)
AUX_SENSE+: R32.3, U1.A3 (SENSE1+)
AUX_SENSE-: R32.2, U1.A2 (SENSE1-)
AUX_VBUS: D6.1 (K), Q2.4 (E2), Q4.3 (D), Q6.3 (D), R18.1, R29.1, R32.1
AUX_VBUS_CONN: C4.1, J12.1, J12.2, J13.2, J17.A4 (VBUS), J17.A9 (VBUS), J17.B4 (VBUS), J17.B9 (VBUS), R32.4, R54.1
AUX_VBUS_EN: J11.8, R40.2
CONTROL_SENSE+: R31.2, U1.A1 (SENSE2+)
CONTROL_SENSE-: R31.3, U1.B1 (SENSE2-)
CONTROL_VBUS: D2.1 (K), Q2.1 (E1), Q3.3 (D), Q5.3 (D), R1.1, R14.1, R31.4
CONTROL_VBUS_CONN: C7.1, J1.2, J4.A4 (VBUS), J4.A9 (VBUS), J4.B4 (VBUS), J4.B9 (VBUS), J7.1, J7.2, R31.1, R49.1
CONTROL_VBUS_EN: J11.9, R39.2
GND: C1.2, C2.2, C3.2, C4.2, C5.2, C6.2, C7.2, C8.1, C9.2, C10.2, C11.2, C12.1, C13.1, C14.2, C15.1, C16.2, D4.2 (A), J1.1, J2.1, J3.1, J4.A1 (GND), J4.A12 (GND), J4.B1 (GND), J4.B12 (GND), J5.A1 (GND), J5.A12 (GND), J5.B1 (GND), J5.B12 (GND), J6.4 (GND), J10.1, J10.2, J11.5, J11.11, J13.1, J17.A1 (GND), J17.A12 (GND), J17.B1 (GND), J17.B12 (GND), Q1.1 (E1), Q1.4 (E2), Q7.1 (E1), Q7.4 (E2), Q10.1 (E1), Q10.4 (E2), R2.2, R4.2, R5.1, R6.2, R7.2, R8.2, R9.2, R10.2, R11.2, R12.2, R15.2, R16.2, R17.2, R21.2, R23.2, R30.2, R37.2, R38.2, R43.2, R47.2, R49.2, R50.2, R51.2, R52.2, R53.2, R54.2, U1.B4 (GND), U2.8 (GND), U2.9 (GND), U2.15 (GND), U3.4 (GND), U3.9 (GND)
unnamed: C13.2, J17.B5 (CC2), R52.1
unnamed: C14.1, J17.A5 (CC1), R53.1
unnamed: C15.2, J4.B5 (CC2), R6.1
unnamed: C16.1, J4.A5 (CC1), R7.1
unnamed: D1.1 (K), Q2.2 (B1), R1.2, R3.1, TP1.1
unnamed: D1.2 (A), R2.1
unnamed: D2.2 (A), Q2.6 (C1), Q3.1 (G), R14.2, R15.1, TP2.1
unnamed: D3.2 (A), Q3.2 (S)
unnamed: D5.2 (A), Q4.2 (S)
unnamed: D6.2 (A), Q2.3 (C2), Q4.1 (G), R17.1, R18.2, TP3.1
unnamed: D7.1 (K), Q2.5 (B2), R22.1, R29.2, TP4.1
unnamed: D7.2 (A), R30.1
unnamed: J4.S1 (SHIELD), R10.1
unnamed: J5.S1 (SHIELD), R11.1
unnamed: J6.5 (Shield), R5.2
unnamed: J17.S1 (SHIELD), R47.1
unnamed: Q1.2 (B1), R4.1, R13.1
unnamed: Q1.3 (C2), R22.2
unnamed: Q1.5 (B2), R20.1, R21.1
unnamed: Q1.6 (C1), R3.2
unnamed: Q5.1 (G), Q7.6 (C1), Q8.1 (G), R33.2, TP10.1
unnamed: Q5.2 (S), Q8.2 (S), R33.1
unnamed: Q6.1 (G), Q7.3 (C2), Q9.1 (G), R35.2, TP11.1
unnamed: Q6.2 (S), Q9.2 (S), R35.1
unnamed: Q7.2 (B1), R37.1, R39.1
unnamed: Q7.5 (B2), R38.1, R40.1
unnamed: Q10.2 (B1), R42.1, R43.1
unnamed: Q10.3 (C2), Q11.1 (G), Q12.1 (G), R45.2, TP14.1
unnamed: Q10.5 (B2), Q10.6 (C1), R44.2, TP13.1
unnamed: Q11.2 (S), Q12.2 (S), R44.1, R45.1
unnamed: R23.1, U1.C2 (ADDRSEL)
unnamed: R24.1, TP5.1, U1.B3 (~PWRDN)
unnamed: R41.2, U2.2 (VBUS)
unnamed: R48.2, R51.1, U3.3 (ADJ/NC)
TARGET_A_SENSE+: R34.3, U1.D3 (SENSE4+)
TARGET_A_SENSE-: R34.2, U1.D2 (SENSE4-)
TARGET_A_VBUS: Q8.3 (D), Q9.3 (D), Q11.3 (D), R34.1, TP12.1
TARGET_A_VBUS_CONN: C2.1, J3.2, J6.1 (VBUS), J8.1, J8.2, R12.1, R34.4
TARGET_C_SENSE+: R46.3, U1.D1 (SENSE3+)
TARGET_C_SENSE-: R46.2, U1.C1 (SENSE3-)
TARGET_C_VBUS: Q12.3 (D), R41.1, R46.1
TARGET_C_VBUS_CONN: C5.1, J2.2, J5.A4 (VBUS), J5.A9 (VBUS), J5.B4 (VBUS), J5.B9 (VBUS), J9.1, J9.2, R46.4, R50.1
VCC: C3.1, C10.1, J11.6, J11.12, J16.1, J16.2, R19.2, R24.2, R25.2, R26.2, R27.2, R28.2, R36.2, U1.A4 (VDD), U2.3 (VDD), U2.4 (VDD)
~AUX_VBUS_IN_EN: R20.2, TP16.1
~CONTROL_VBUS_IN_EN: R13.2, TP15.1
~TARGET_C_VBUS_EN: J11.7, R42.2

Notes on the sheet:
CONTROL_VBUS expected: 4.4 to 5.5 V absolute max: 40 V
+5V required: 3.8 to 6.0 V absolute max: 6.5 V
AUX_VBUS expected: 4.4 to 21 V absolute max: 40 V
FUSB302B VBUS input recommended max: 21 V absolute max: 28 V protected from higher voltage by resistor
TARGET_C_VBUS expected: 4.4 to 21 V absolute max: 40 V
TARGET_A_VBUS expected: 4.4 to 21 V absolute max: 40 V

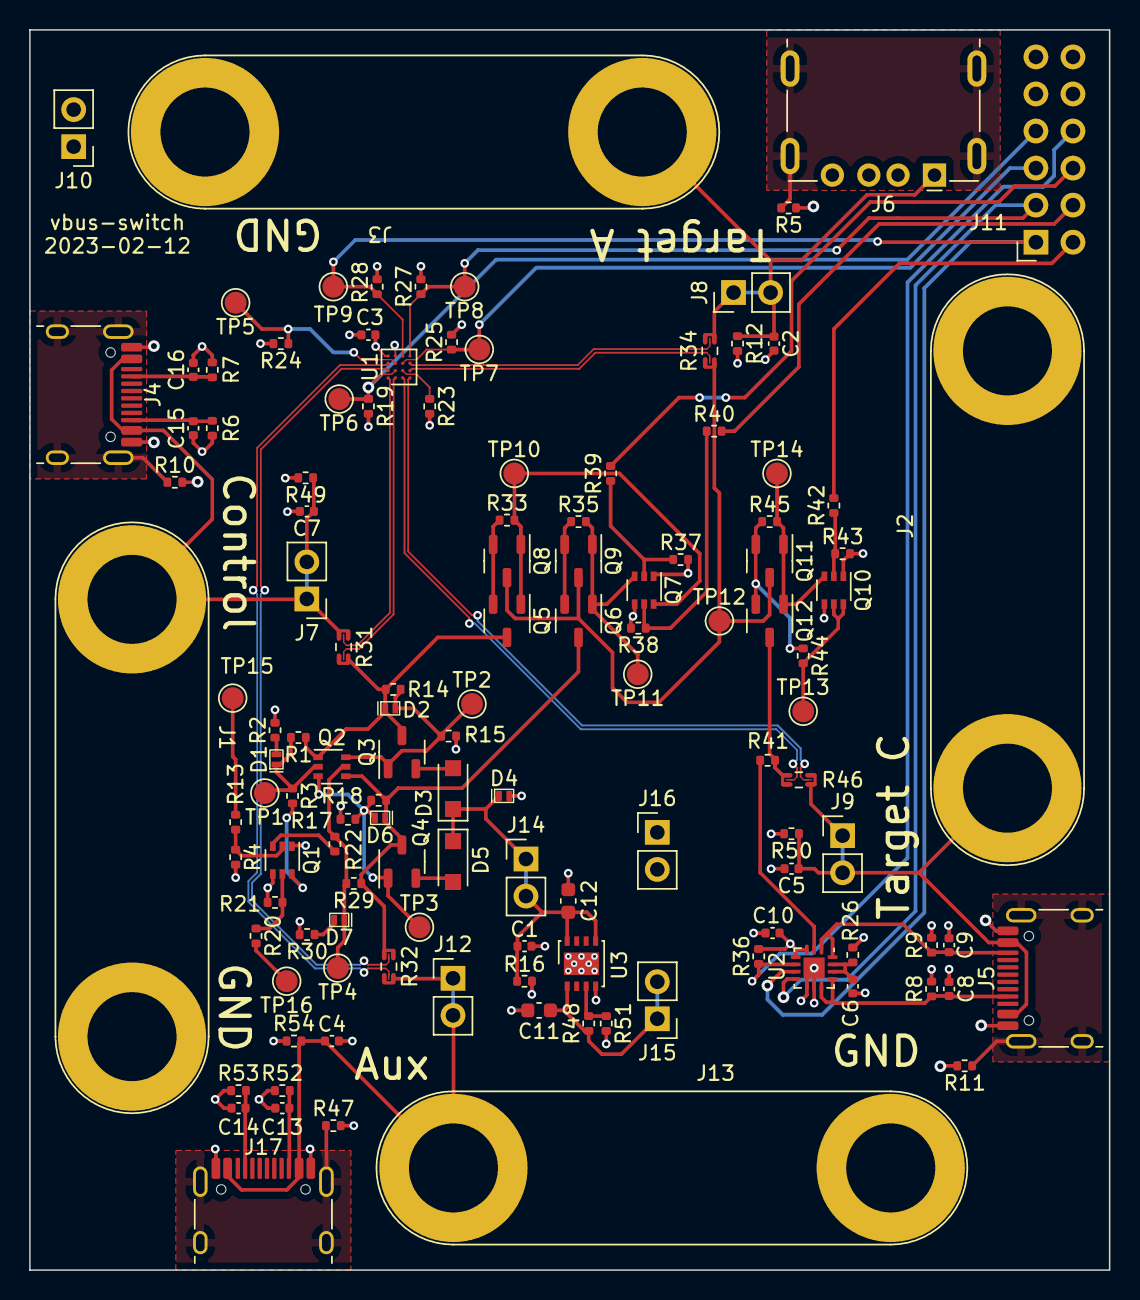
[picture p24: board vbus-switch.kicad_pcb from above]

Board: 4 copper layers, 74.0 x 85.0 mm, 125 parts (0 on the bottom side), 67 nets.
