greatscottgadgets/misc/evaluation-boards/pmos-or/pmos-or.kicad_pcb

## KiCad design evaluation-boards/pmos-or/pmos-or.kicad_pcb (2023-01-24)

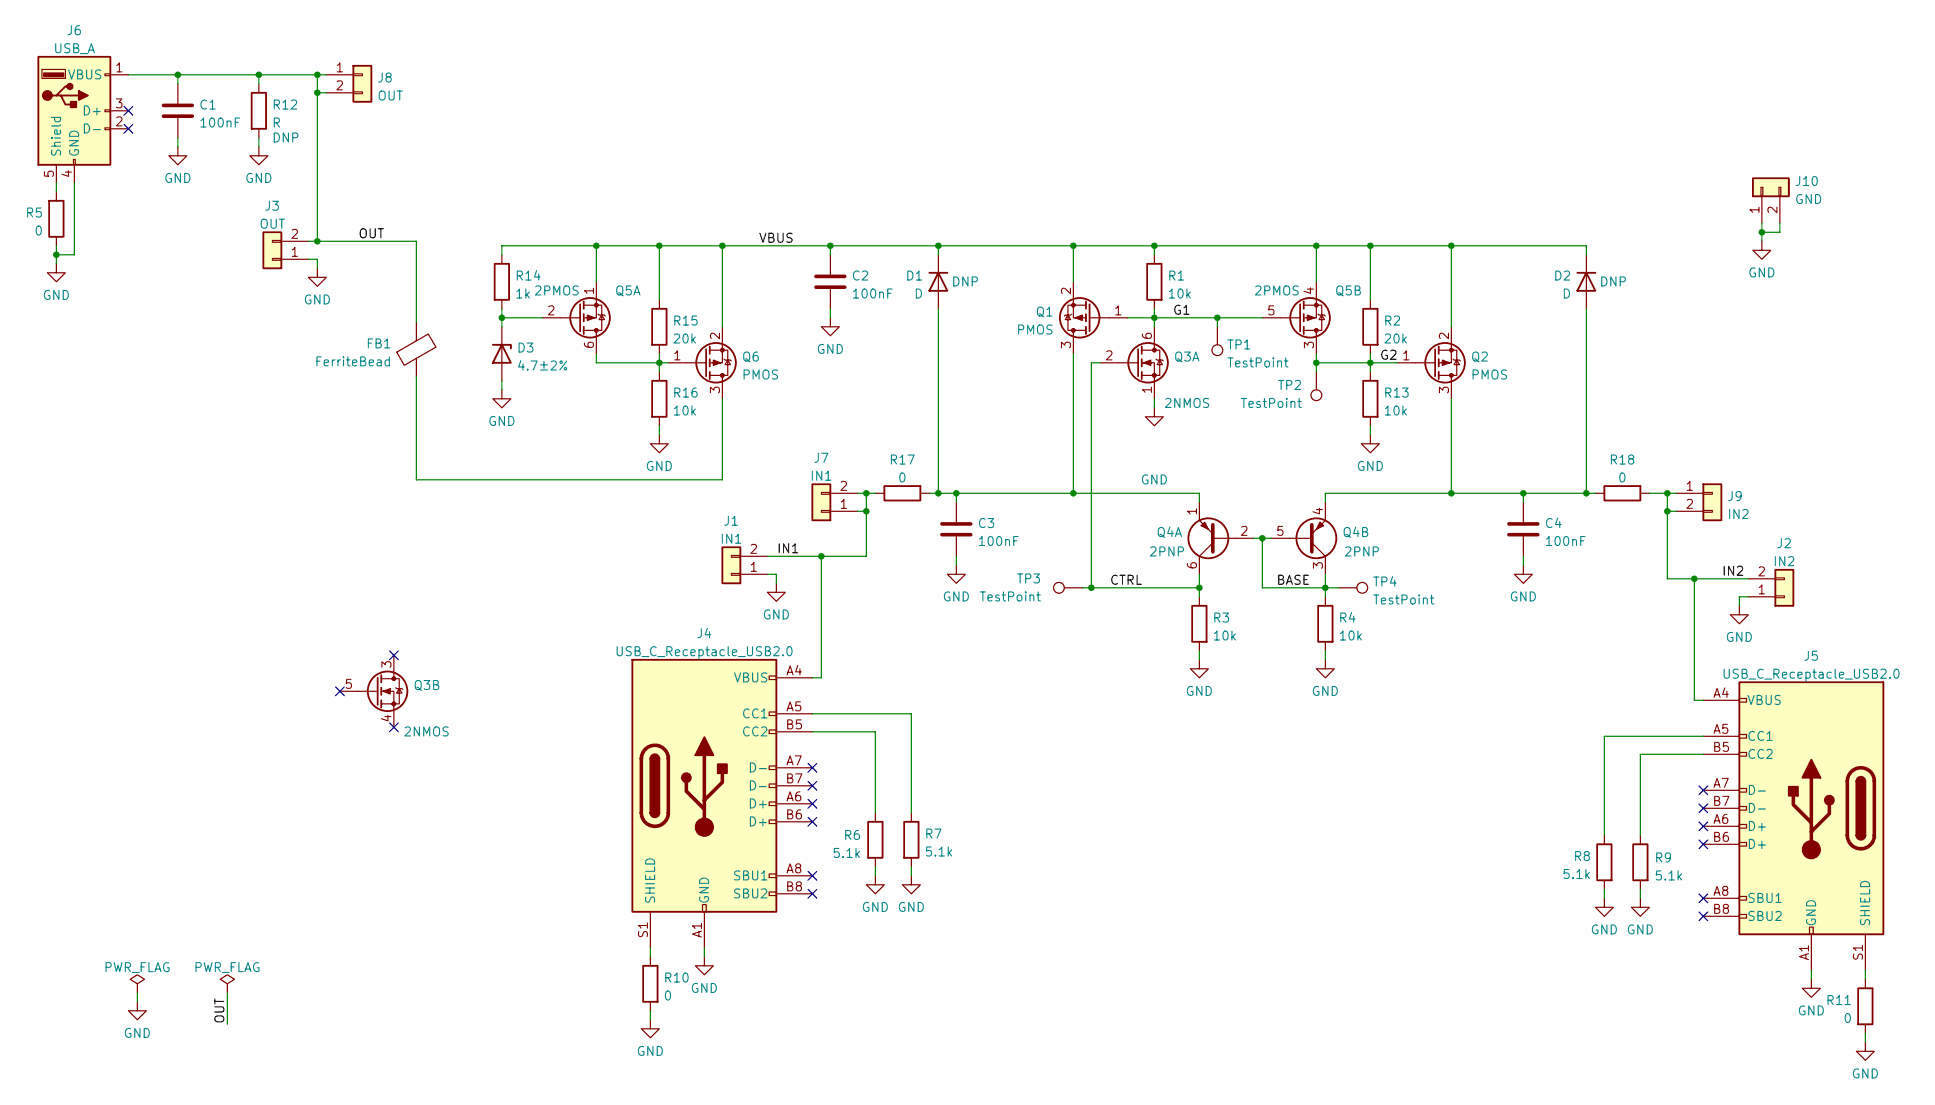
[picture p25: schematic pmos-or.kicad_sch]

Parts:
C1, C2, C3, C4: 100nF; C_0402_1005Metric
D1, D2: D; SOD128; Part Number PMEG3050BEP,115
D3: 4.7±2%; DFN1006-2; Part Number BZX884-B4V7,315
FB1: FerriteBead; L_0805_2012Metric
J1: IN1; Banana_Jack_2Pin
J2: IN2; Banana_Jack_2Pin
J3: OUT; Banana_Jack_2Pin
J4, J5: USB_C_Receptacle_USB2.0; USB_C_Receptacle_HRO_TYPE-C-31-M-12; Part Number U262-161N-4BVC11
J6: USB_A; USB_A_Kycon_KUSBXHT-SB-AS1N-B30-NF_Horizontal; Part Number C42411
J7: IN1; PinHeader_1x02_P2.54mm_Vertical
J8: OUT; PinHeader_1x02_P2.54mm_Vertical
J9: IN2; PinHeader_1x02_P2.54mm_Vertical
J10: GND; PinHeader_1x02_P2.54mm_Vertical
Q1, Q2, Q6: PMOS; SOT-23-3; Part Number PJA3441_R1_00001
Q3: 2NMOS; SOT-363_SC-70-6; Part Number 2N7002DW
Q4: 2PNP; SOT-363_SC-70-6; Part Number BCM857BS-7-F
Q5: 2PMOS; SOT-363_SC-70-6; Part Number BSS84DW
R1, R3, R4, R13, R16: 10k; R_0402_1005Metric
R2, R15: 20k; R_0402_1005Metric
R5, R10, R11, R17, R18: 0; R_0402_1005Metric
R6, R7, R8, R9: 5.1k; R_0402_1005Metric
R12: R; R_0402_1005Metric
R14: 1k; R_0402_1005Metric
TP1, TP2, TP3, TP4: TestPoint; TestPoint_Pad_D2.0mm

Connections:
/BASE: Q4.2 (B1), Q4.3 (C2), Q4.5 (B2), R4.1, TP4.1
/CTRL: Q3.2 (G), Q4.6 (C1), R3.1, TP3.1
/G1: Q1.1 (G), Q3.6 (D), Q5.5 (G), R1.2, TP1.1
/G2: Q2.1 (G), Q5.3 (D), R2.2, R13.1, TP2.1
/IN1: J1.2, J4.A4 (VBUS), J4.A9 (VBUS), J4.B4 (VBUS), J4.B9 (VBUS), J7.1, J7.2, R17.1
/IN2: J2.2, J5.A4 (VBUS), J5.A9 (VBUS), J5.B4 (VBUS), J5.B9 (VBUS), J9.1, J9.2, R18.2
/OUT: C1.1, FB1.2, J3.2, J6.1 (VBUS), J8.1, J8.2, R12.1
/VBUS: C2.1, D1.1 (K), D2.1 (K), Q1.2 (S), Q2.2 (S), Q5.1 (S), Q5.4 (S), Q6.2 (S), R1.1, R2.1, R14.1, R15.1
GND: C1.2, C2.2, C3.2, C4.2, D3.2 (A), J1.1, J2.1, J3.1, J4.A1 (GND), J4.A12 (GND), J4.B1 (GND), J4.B12 (GND), J5.A1 (GND), J5.A12 (GND), J5.B1 (GND), J5.B12 (GND), J6.4 (GND), J10.1, J10.2, Q3.1 (S), R3.2, R4.2, R5.1, R6.2, R7.2, R8.2, R9.2, R10.2, R11.2, R12.2, R13.2, R16.2
unnamed: C3.1, D1.2 (A), Q1.3 (D), Q4.1 (E1), R17.2
unnamed: C4.1, D2.2 (A), Q2.3 (D), Q4.4 (E2), R18.1
unnamed: D3.1 (K), Q5.2 (G), R14.2
unnamed: FB1.1, Q6.3 (D)
unnamed: J4.A5 (CC1), R7.1
unnamed: J4.B5 (CC2), R6.1
unnamed: J4.S1 (SHIELD), R10.1
unnamed: J5.A5 (CC1), R8.1
unnamed: J5.B5 (CC2), R9.1
unnamed: J5.S1 (SHIELD), R11.1
unnamed: J6.5 (Shield), R5.2
unnamed: Q5.6 (D), Q6.1 (G), R15.2, R16.1

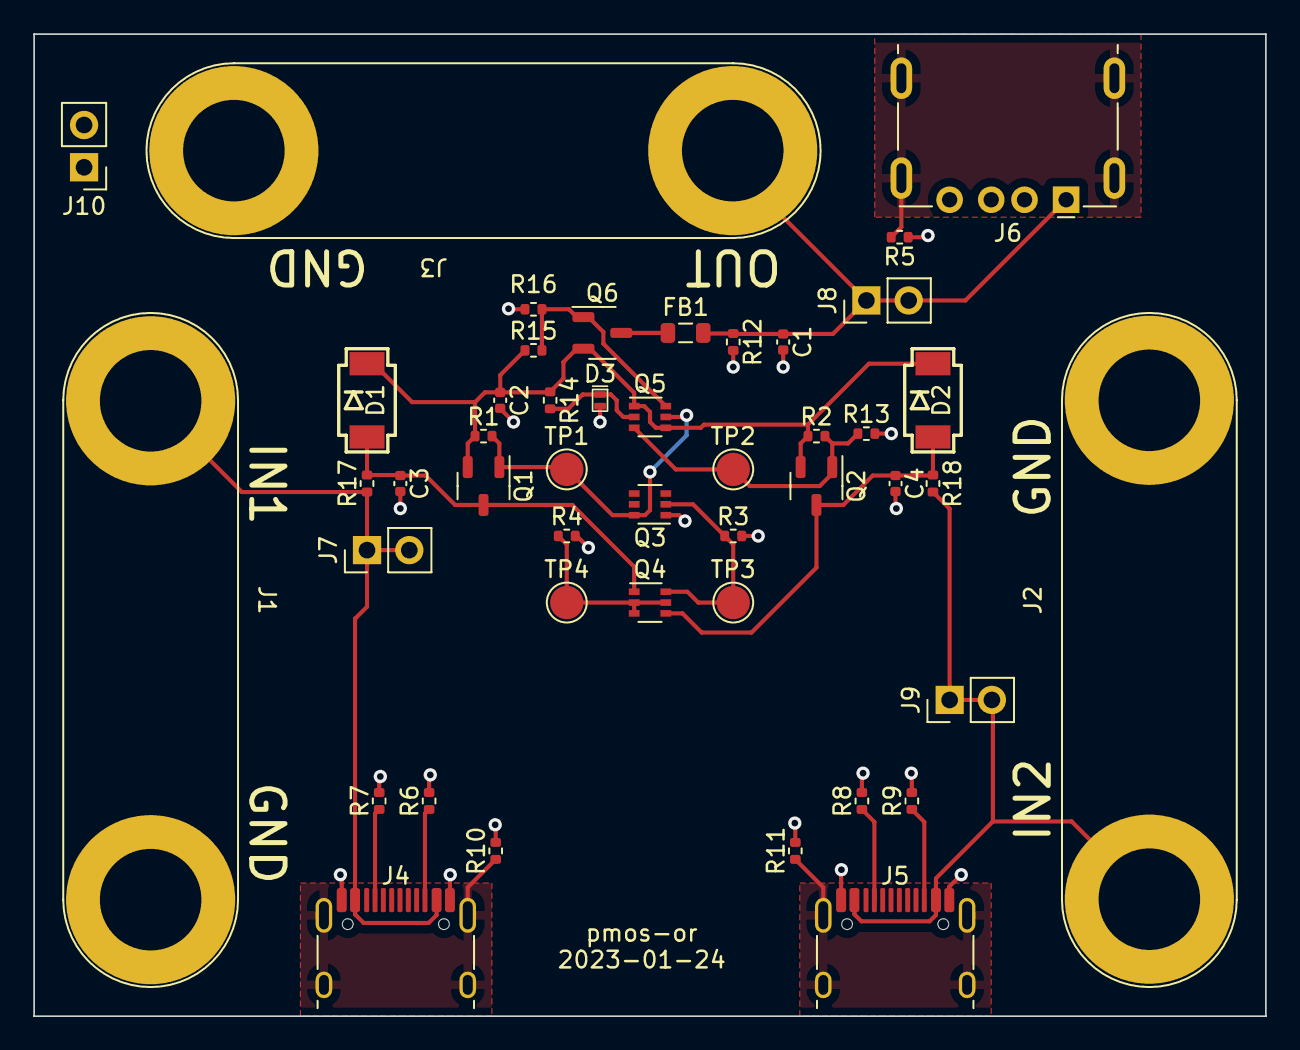
[picture p26: board pmos-or.kicad_pcb from above]

Board: 2 copper layers, 74.0 x 59.0 mm, 46 parts (0 on the bottom side), 21 nets.
