greatscottgadgets/misc/evaluation-boards/Si5351A/Si5351A.kicad_pcb

## KiCad design evaluation-boards/Si5351A/Si5351A.kicad_pcb (2022-08-11)

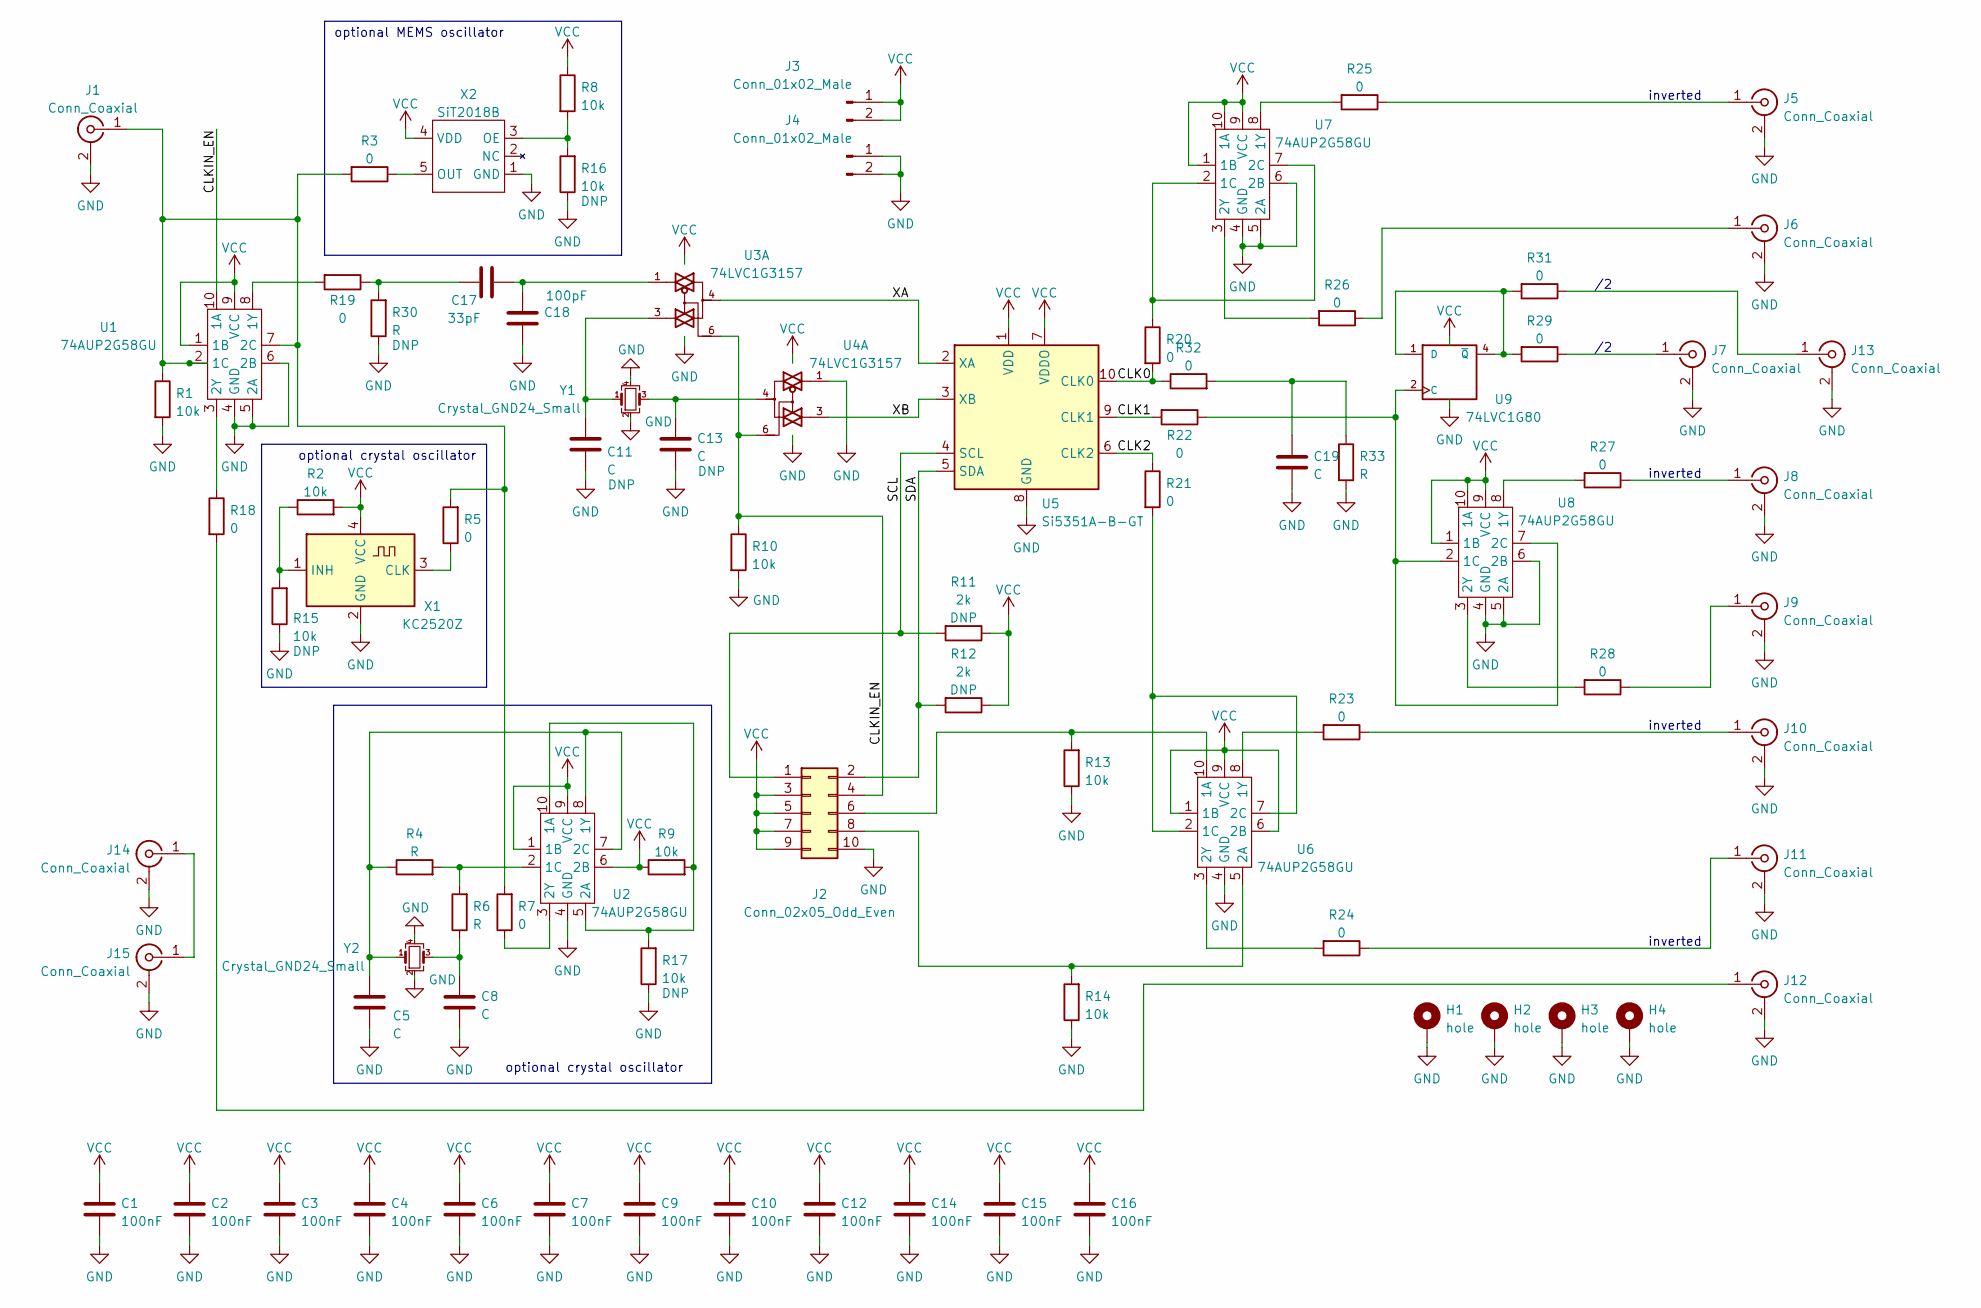
[picture p27: schematic Si5351A.kicad_sch]

Parts:
C1, C2, C3, C4, C6, C7, C9, C10, C12, C14, C15, C16: 100nF; C_0402_1005Metric
C5, C8, C11, C13, C19: C; C_0402_1005Metric
C17: 33pF; C_0402_1005Metric
C18: 100pF; C_0402_1005Metric
H1, H2, H3, H4: hole; MountingHole_2.2mm_M2_Pad_Via
J1, J5, J6, J7, J8, J9, J10, J11, J12, J13, J14, J15: Conn_Coaxial; SMA-EDGE
J2: Conn_02x05_Odd_Even; PinHeader_2x05_P2.54mm_Vertical
J3, J4: Conn_01x02_Male; PinHeader_1x02_P2.54mm_Vertical
R1, R2, R8, R9, R10, R13, R14, R15, R16, R17: 10k; R_0402_1005Metric
R3, R5, R7, R18, R19, R20, R21, R22, R23, R24, R25, R26, R27, R28, R29, R31, R32: 0; R_0402_1005Metric
R4, R6, R30, R33: R; R_0402_1005Metric
R11, R12: 2k; R_0402_1005Metric
U1, U2, U6, U7, U8: 74AUP2G58GU; XQFN10; Part Number 74AUP2G58GUX
U3, U4: 74LVC1G3157; XSON6; Part Number 74LVC1G3157GM,115
U5: Si5351A-B-GT; MSOP-10_3x3mm_P0.5mm; Part Number Si5351A-B-GTR
U9: 74LVC1G80; SOT-353_SC-70-5; Part Number SN74LVC1G80DCKR
X1: KC2520Z; Oscillator_SMD_Kyocera_KC2520Z-4Pin_2.5x2.0mm; Part Number KC2520Z25.0000C1KX00
X2: SiT2018B; SOT-23-5; Part Number SIT2018BEAS1-33N-27.000000E
Y1, Y2: Crystal_GND24_Small; Crystal_SMD_3225-4Pin_3.2x2.5mm

Connections:
/CLK0: R20.2, R32.1, U5.10 (CLK0)
/CLK1: R22.2, U5.9 (CLK1)
/CLK2: R21.1, U5.6 (CLK2)
/CLKIN_EN: J2.4, R10.1, U1.10 (1A), U3.6, U4.6
/SCL: J2.1, R11.2, U5.4 (SCL)
/SDA: J2.2, R12.2, U5.5 (SDA)
/XA: U3.4, U5.2 (XA)
/XB: U4.3, U5.3 (XB)
GND: C1.2, C2.2, C3.2, C4.2, C5.2, C6.2, C7.2, C8.2, C9.2, C10.2, C11.2, C12.2, C13.2, C14.2, C15.2, C16.2, C18.2, C19.2, H1.1, H2.1, H3.1, H4.1, J1.2 (Ext), J2.10, J4.1, J4.2, J5.2 (Ext), J6.2 (Ext), J7.2 (Ext), J8.2 (Ext), J9.2 (Ext), J10.2 (Ext), J11.2 (Ext), J12.2 (Ext), J13.2 (Ext), J14.2 (Ext), J15.2 (Ext), R1.2, R10.2, R13.1, R14.1, R15.1, R16.1, R17.1, R30.1, R33.2, U1.4 (GND), U1.5 (2A), U1.6 (2B), U2.4 (GND), U3.2 (GND), U4.1, U4.2 (GND), U5.8 (GND), U6.4 (GND), U7.4 (GND), U7.5 (2A), U7.6 (2B), U8.4 (GND), U8.5 (2A), U8.6 (2B), U9.3 (GND), X1.2 (GND), X2.1 (GND), Y1.2, Y1.4, Y2.2, Y2.4
unnamed: C5.1, R4.1, U2.7 (2C), U2.8 (1Y), Y2.1
unnamed: C8.1, R6.1, Y2.3
unnamed: C11.1, U3.3, Y1.1
unnamed: C13.1, U4.4, Y1.3
unnamed: C17.1, R19.1, R30.2
unnamed: C17.2, C18.1, U3.1
unnamed: C19.1, R32.2, R33.1
unnamed: J1.1 (In), R1.1, R3.2, R5.2, R7.2, U1.2 (1C), U1.7 (2C)
unnamed: J2.6, R13.2, U6.10 (1A)
unnamed: J2.8, R14.2, U6.5 (2A)
unnamed: J5.1 (In), R25.1
unnamed: J6.1 (In), R26.1
unnamed: J7.1 (In), R29.1
unnamed: J8.1 (In), R27.1
unnamed: J9.1 (In), R28.1
unnamed: J10.1 (In), R23.1
unnamed: J11.1 (In), R24.1
unnamed: J12.1 (In), R18.2
unnamed: J13.1 (In), R31.1
unnamed: J14.1 (In), J15.1 (In)
unnamed: R3.1, X2.5 (OUT)
unnamed: R4.2, R6.2, U2.2 (1C)
unnamed: R5.1, X1.3 (CLK)
unnamed: R7.1, U2.3 (2Y)
unnamed: R2.1, R15.2, X1.1 (INH)
unnamed: R8.2, R16.2, X2.3 (OE)
unnamed: R9.2, R17.2, U2.5 (2A), U2.10 (1A)
unnamed: R18.1, U1.3 (2Y)
unnamed: R19.2, U1.8 (1Y)
unnamed: R20.1, U7.2 (1C), U7.7 (2C)
unnamed: R21.2, U6.2 (1C), U6.7 (2C)
unnamed: R22.1, U8.2 (1C), U8.7 (2C), U9.2 (C)
unnamed: R23.2, U6.8 (1Y)
unnamed: R24.2, U6.3 (2Y)
unnamed: R25.2, U7.8 (1Y)
unnamed: R26.2, U7.3 (2Y)
unnamed: R27.2, U8.8 (1Y)
unnamed: R28.2, U8.3 (2Y)
unnamed: R29.2, R31.2, U9.1 (D), U9.4 (~Q)
VCC: C1.1, C2.1, C3.1, C4.1, C6.1, C7.1, C9.1, C10.1, C12.1, C14.1, C15.1, C16.1, J2.3, J2.5, J2.7, J2.9, J3.1, J3.2, R2.2, R8.1, R9.1, R11.1, R12.1, U1.1 (1B), U1.9 (VCC), U2.1 (1B), U2.6 (2B), U2.9 (VCC), U3.5 (VCC), U4.5 (VCC), U5.1 (VDD), U5.7 (VDDO), U6.1 (1B), U6.6 (2B), U6.9 (VCC), U7.1 (1B), U7.9 (VCC), U7.10 (1A), U8.1 (1B), U8.9 (VCC), U8.10 (1A), U9.5 (VCC), X1.4 (VCC), X2.4 (VDD)

Notes on the sheet:
inverted
optional MEMS oscillator
optional crystal oscillator

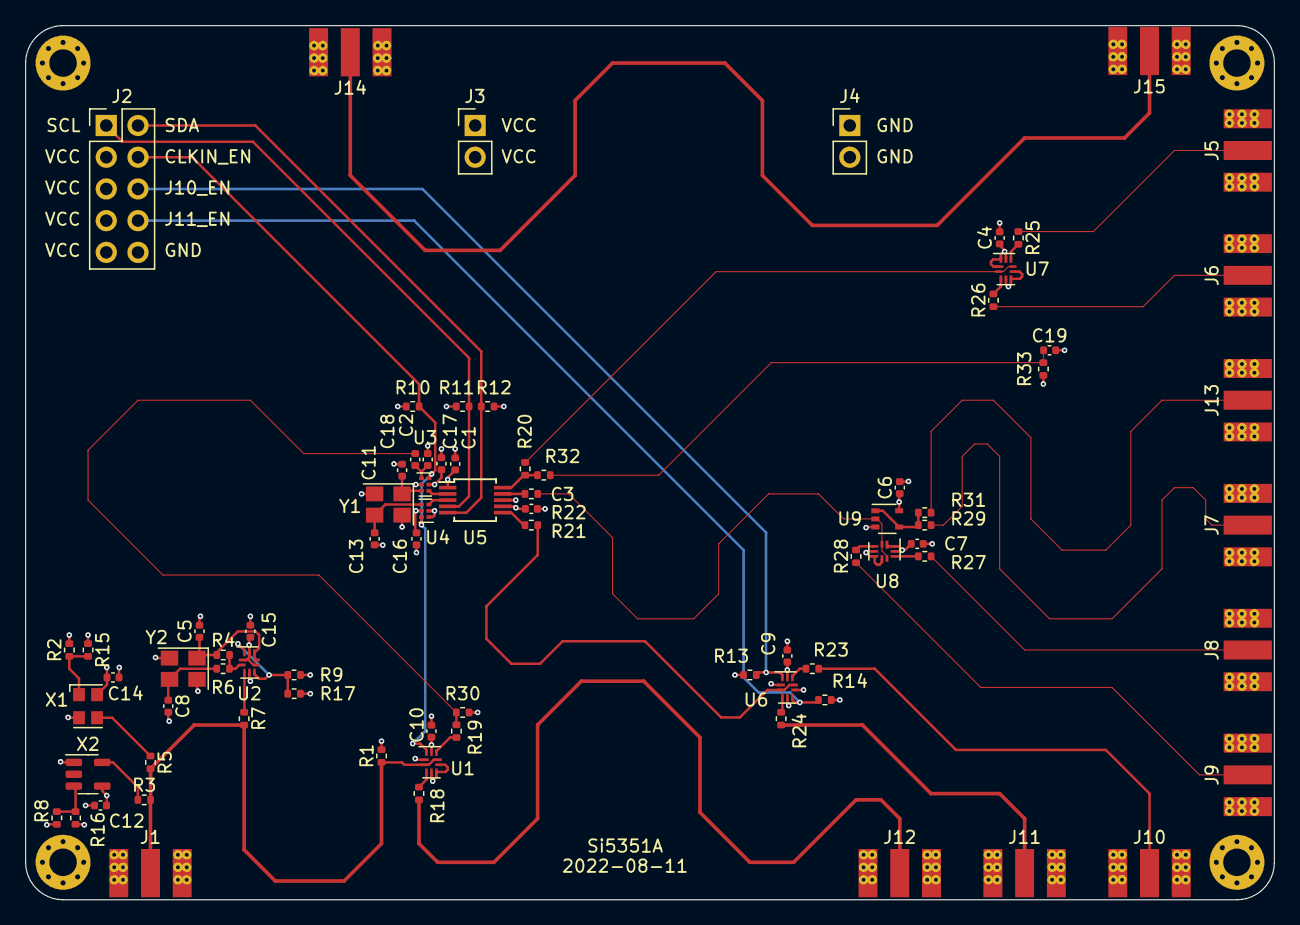
[picture p28: board Si5351A.kicad_pcb from above]

Board: 4 copper layers, 100.0 x 70.0 mm, 84 parts (0 on the bottom side), 49 nets.
