greatscottgadgets/misc/evaluation-boards/ununs/ununs.kicad_pcb

## KiCad design evaluation-boards/ununs/ununs.kicad_pcb (2022-04-09)

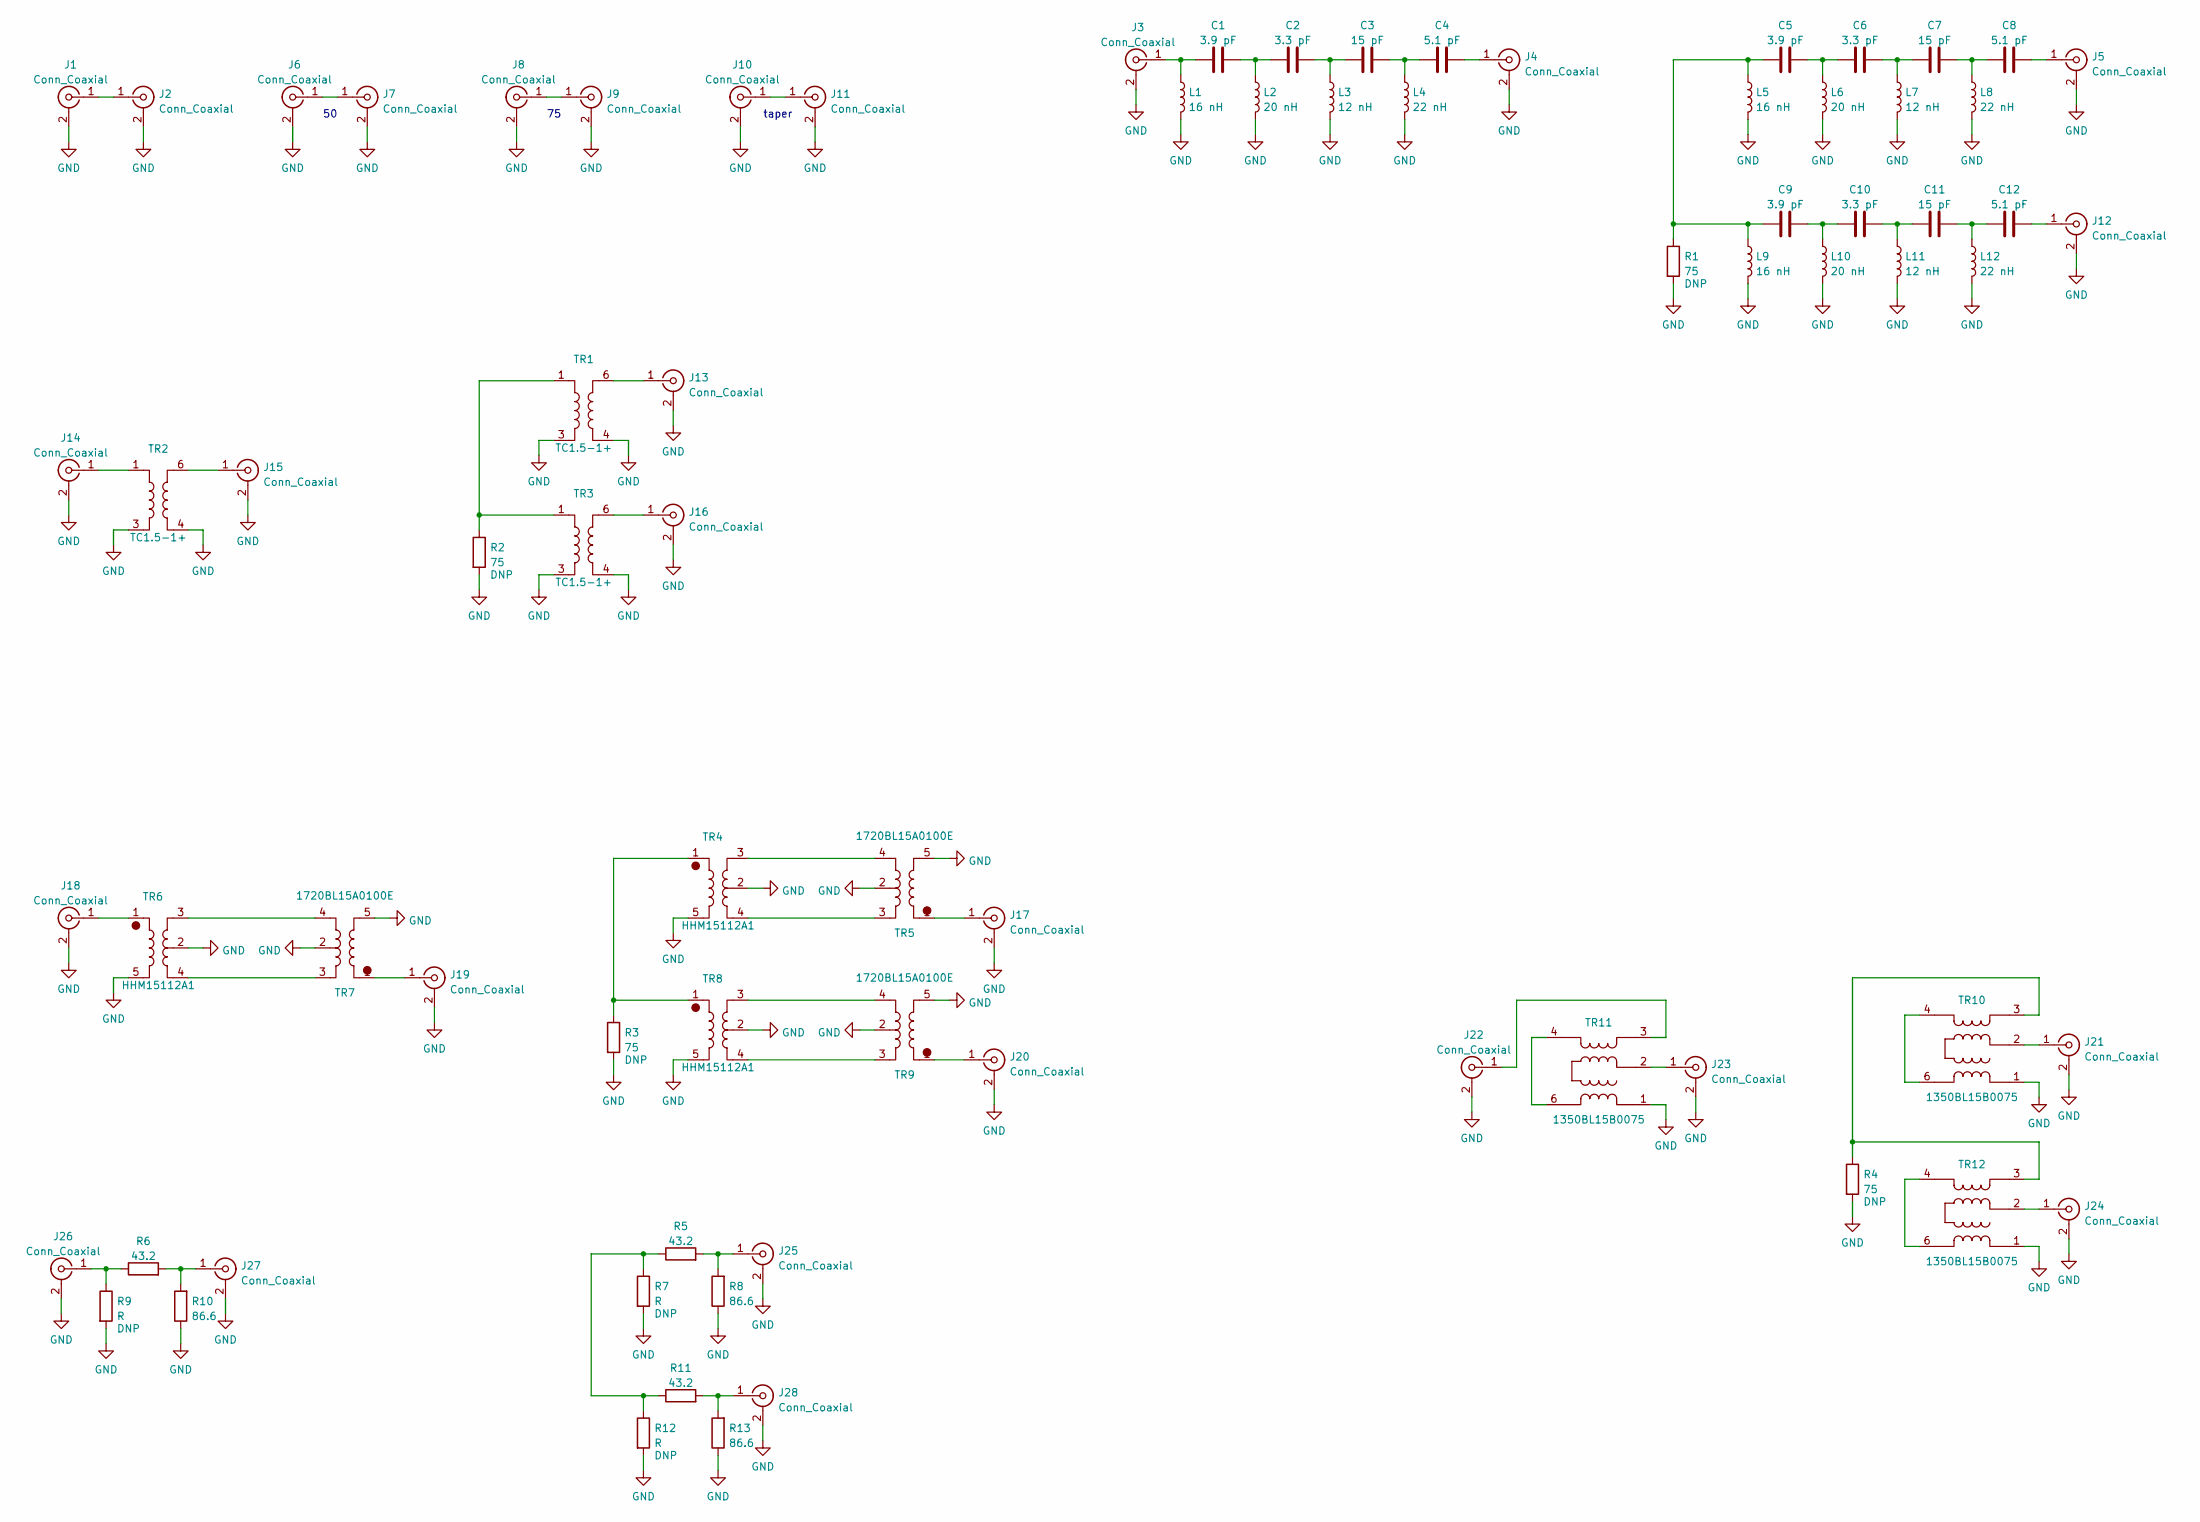
[picture p29: schematic ununs.kicad_sch]

Parts:
C1, C5, C9: 3.9 pF; C_0201_0603Metric_Pad0.64x0.40mm_HandSolder
C2, C6, C10: 3.3 pF; C_0201_0603Metric_Pad0.64x0.40mm_HandSolder
C3, C7, C11: 15 pF; C_0201_0603Metric_Pad0.64x0.40mm_HandSolder
C4, C8, C12: 5.1 pF; C_0201_0603Metric_Pad0.64x0.40mm_HandSolder
J1, J2, J4, J5, J7, J9, J11, J12, J13, J15, J16, J17, J19, J20, J21, J23, J24, J25, J27, J28: Conn_Coaxial; SMA-EDGE
J3, J6, J8, J10, J14, J18, J22, J26: Conn_Coaxial; F_Cinch_VF320_Vertical; Part Number VF320
L1, L5, L9: 16 nH; L_0201_0603Metric_Pad0.64x0.40mm_HandSolder
L2, L6, L10: 20 nH; L_0201_0603Metric_Pad0.64x0.40mm_HandSolder
L3, L7, L11: 12 nH; L_0201_0603Metric_Pad0.64x0.40mm_HandSolder
L4, L8, L12: 22 nH; L_0201_0603Metric_Pad0.64x0.40mm_HandSolder
R1, R2, R3, R4: 75; R_0402_1005Metric_Pad0.72x0.64mm_HandSolder
R5, R6, R11: 43.2; R_0402_1005Metric_Pad0.72x0.64mm_HandSolder
R7, R9, R12: R; R_0402_1005Metric_Pad0.72x0.64mm_HandSolder
R8, R10, R13: 86.6; R_0402_1005Metric_Pad0.72x0.64mm_HandSolder
TR1, TR2, TR3: TC1.5-1+; Mini-Circuits_DB1627
TR4, TR6, TR8: HHM15112A1
TR5, TR7, TR9: 1720BL15A0100E; HHM15112A1
TR10, TR11, TR12: 1350BL15B0075; Balun_Johanson_0896BM15A0001

Connections:
GND: J1.2 (Ext), J2.2 (Ext), J3.2 (Ext), J4.2 (Ext), J5.2 (Ext), J6.2 (Ext), J7.2 (Ext), J8.2 (Ext), J9.2 (Ext), J10.2 (Ext), J11.2 (Ext), J12.2 (Ext), J13.2 (Ext), J14.2 (Ext), J15.2 (Ext), J16.2 (Ext), J17.2 (Ext), J18.2 (Ext), J19.2 (Ext), J20.2 (Ext), J21.2 (Ext), J22.2 (Ext), J23.2 (Ext), J24.2 (Ext), J25.2 (Ext), J26.2 (Ext), J27.2 (Ext), J28.2 (Ext), L1.2, L2.2, L3.2, L4.2, L5.2, L6.2, L7.2, L8.2, L9.2, L10.2, L11.2, L12.2, R1.2, R2.2, R3.2, R4.2, R7.2, R8.1, R9.2, R10.1, R12.2, R13.1, TR1.3, TR1.4, TR2.3, TR2.4, TR3.3, TR3.4, TR4.2, TR4.5, TR5.2, TR5.5, TR6.2, TR6.5, TR7.2, TR7.5, TR8.2, TR8.5, TR9.2, TR9.5, TR10.1, TR11.1, TR12.1
unnamed: C1.1, J3.1 (In), L1.1
unnamed: C1.2, C2.1, L2.1
unnamed: C2.2, C3.1, L3.1
unnamed: C3.2, C4.1, L4.1
unnamed: C4.2, J4.1 (In)
unnamed: C5.1, C9.1, L5.1, L9.1, R1.1
unnamed: C5.2, C6.1, L6.1
unnamed: C6.2, C7.1, L7.1
unnamed: C7.2, C8.1, L8.1
unnamed: C8.2, J5.1 (In)
unnamed: C9.2, C10.1, L10.1
unnamed: C10.2, C11.1, L11.1
unnamed: C11.2, C12.1, L12.1
unnamed: C12.2, J12.1 (In)
unnamed: J1.1 (In), J2.1 (In)
unnamed: J6.1 (In), J7.1 (In)
unnamed: J8.1 (In), J9.1 (In)
unnamed: J10.1 (In), J11.1 (In)
unnamed: J13.1 (In), TR1.6
unnamed: J14.1 (In), TR2.1
unnamed: J15.1 (In), TR2.6
unnamed: J16.1 (In), TR3.6
unnamed: J17.1 (In), TR5.1
unnamed: J18.1 (In), TR6.1
unnamed: J19.1 (In), TR7.1
unnamed: J20.1 (In), TR9.1
unnamed: J21.1 (In), TR10.2
unnamed: J22.1 (In), TR11.3
unnamed: J23.1 (In), TR11.2
unnamed: J24.1 (In), TR12.2
unnamed: J25.1 (In), R5.2, R8.2
unnamed: J26.1 (In), R6.1, R9.1
unnamed: J27.1 (In), R6.2, R10.2
unnamed: J28.1 (In), R11.2, R13.2
unnamed: R2.1, TR1.1, TR3.1
unnamed: R3.1, TR4.1, TR8.1
unnamed: R4.1, TR10.3, TR12.3
unnamed: R5.1, R7.1, R11.1, R12.1
unnamed: TR4.3, TR5.4
unnamed: TR4.4, TR5.3
unnamed: TR6.3, TR7.4
unnamed: TR6.4, TR7.3
unnamed: TR8.3, TR9.4
unnamed: TR8.4, TR9.3
unnamed: TR10.4, TR10.6
unnamed: TR11.4, TR11.6
unnamed: TR12.4, TR12.6

Notes on the sheet:
taper

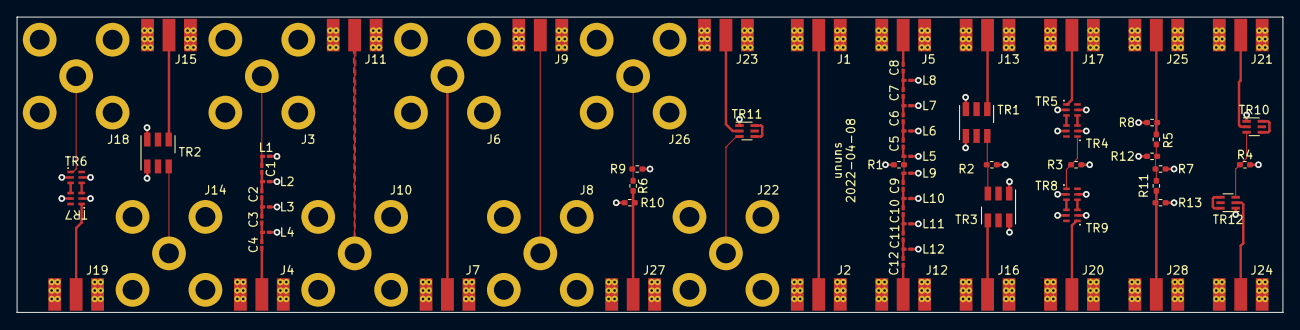
[picture p30: board ununs.kicad_pcb from above]

Board: 4 copper layers, 150.0 x 35.0 mm, 77 parts (0 on the bottom side), 48 nets.
