greatscottgadgets/misc/evaluation-boards/quad-balun-directional-coupler/quad-balun-directional-coupler.kicad_pcb

## KiCad design evaluation-boards/quad-balun-directional-coupler/quad-balun-directional-coupler.kicad_pcb (2022-03-23)

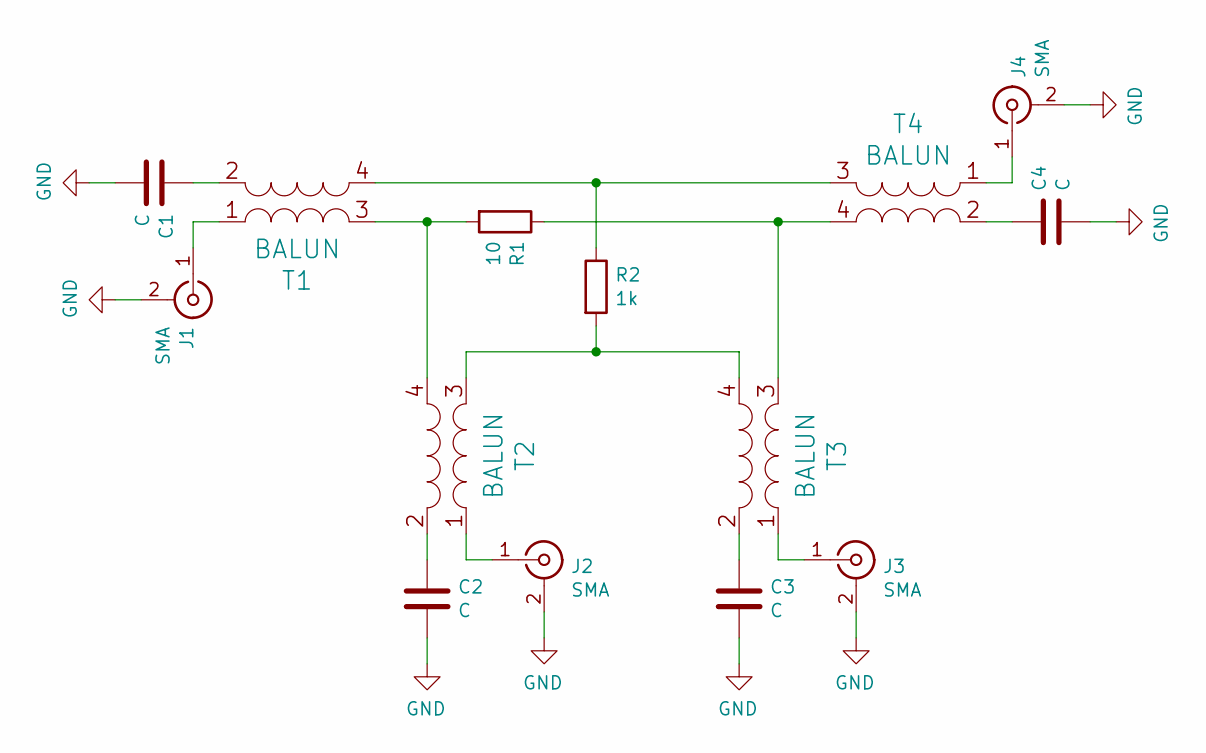
[picture p31: schematic quad-balun-directional-coupler.sch]

Parts:
C1, C2, C3, C4: C; 0402
J1, J2, J3, J4: SMA; SMA-73251-2120
R1: 10; 0402
R2: 1k; 0402
T1, T2, T3, T4: BALUN; Anaren_0805_2012Metric-6; Part Number B0322J5050AHF

Connections:
GND: C1.2, C2.2, C3.2, C4.2, J1.2 (Ext), J2.2 (Ext), J3.2 (Ext), J4.2 (Ext)
unnamed: C1.1, T1.2 (S2)
unnamed: C2.1, T2.2 (S2)
unnamed: C3.1, T3.2 (S2)
unnamed: C4.1, T4.2 (S2)
unnamed: J1.1 (In), T1.1 (S1)
unnamed: J2.1 (In), T2.1 (S1)
unnamed: J3.1 (In), T3.1 (S1)
unnamed: J4.1 (In), T4.1 (S1)
unnamed: R1.1, T3.3 (PR1), T4.4 (PR2)
unnamed: R1.2, T1.3 (PR1), T2.4 (PR2)
unnamed: R2.1, T1.4 (PR2), T4.3 (PR1)
unnamed: R2.2, T2.3 (PR1), T3.4 (PR2)

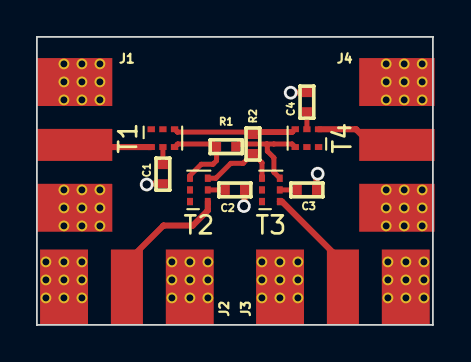
[picture p32: board quad-balun-directional-coupler.kicad_pcb from above]

Board: 4 copper layers, 22.0 x 16.0 mm, 14 parts (0 on the bottom side), 13 nets.
