greatscottgadgets/misc/evaluation-boards/BGA622H6820/BGA622H6820.kicad_pcb

## KiCad design evaluation-boards/BGA622H6820/BGA622H6820.kicad_pcb (2022-03-23)

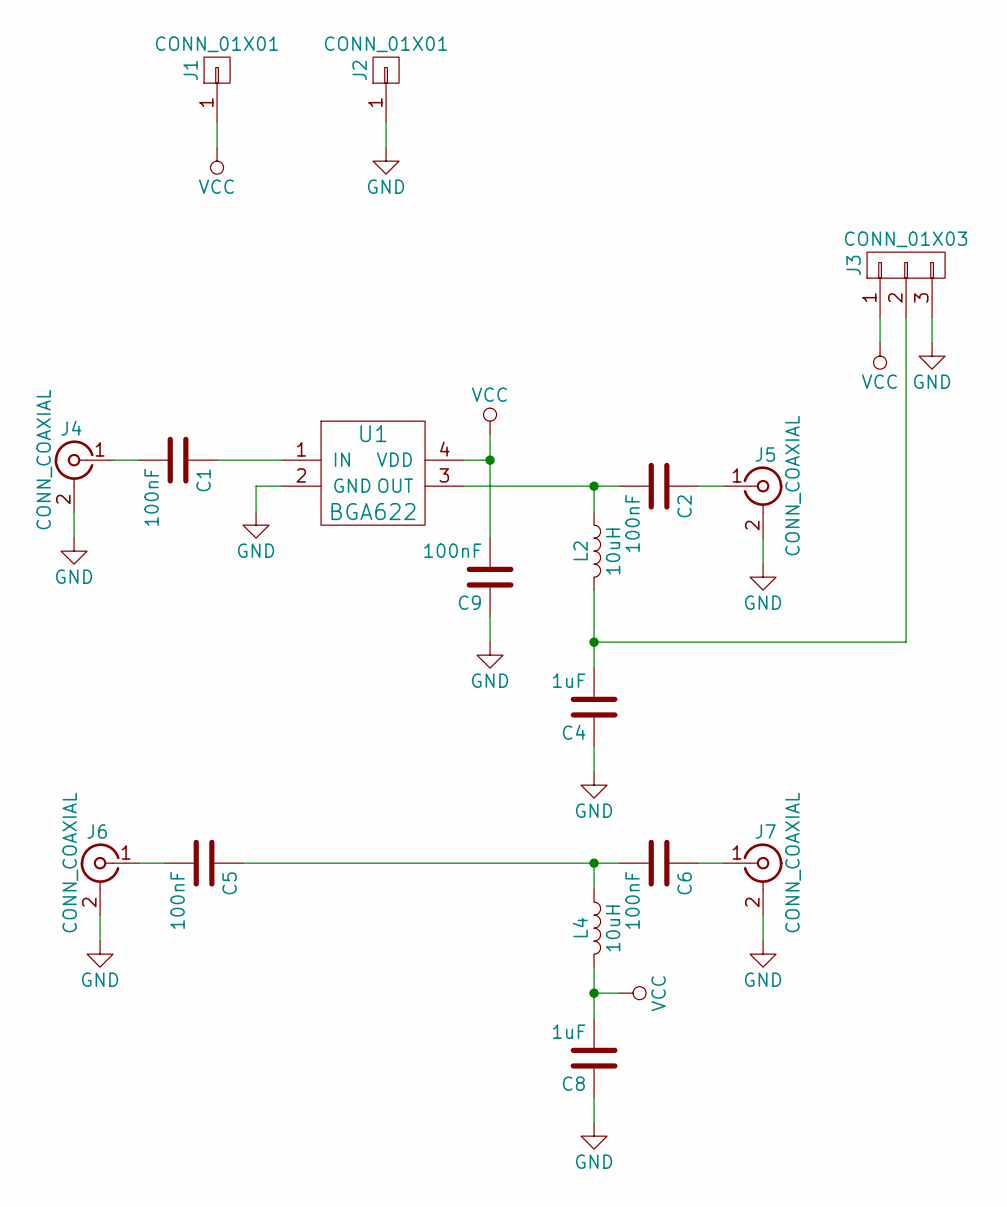
[picture p33: schematic BGA622H6820.sch]

Parts:
C1, C2, C5, C6, C9: 100nF; 0402
C4, C8: 1uF; 0603
J1, J2: CONN_01X01; HEADER-1x1
J3: CONN_01X03; HEADER-1x3
J4, J5, J6, J7: CONN_COAXIAL; SMA-VERTICAL
L2, L4: 10uH; 0603
U1: BGA622; SOT343

Connections:
GND: C4.1, C8.1, C9.1, J2.1, J3.3, J4.2 (Ext), J5.2 (Ext), J6.2 (Ext), J7.2 (Ext), U1.2 (GND)
unnamed: C1.1, U1.1 (IN)
unnamed: C1.2, J4.1 (In)
unnamed: C2.1, J5.1 (In)
unnamed: C2.2, L2.1, U1.3 (OUT)
unnamed: C4.2, J3.2, L2.2
unnamed: C5.1, C6.2, L4.1
unnamed: C5.2, J6.1 (In)
unnamed: C6.1, J7.1 (In)
VCC: C8.2, C9.2, J1.1, J3.1, L4.2, U1.4 (VDD)

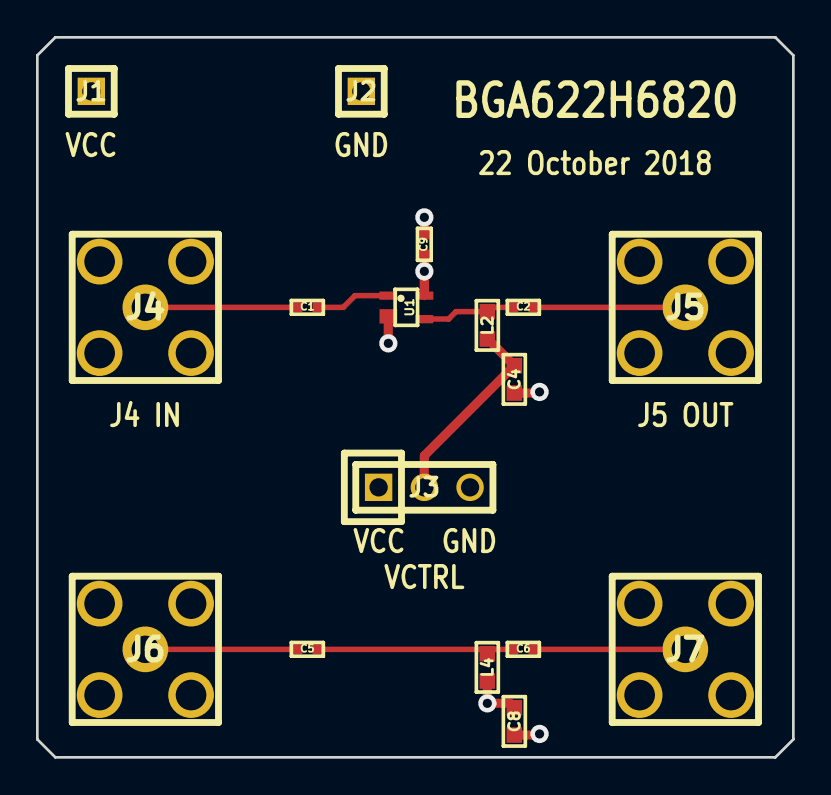
[picture p34: board BGA622H6820.kicad_pcb from above]

Board: 4 copper layers, 42.0 x 40.0 mm, 17 parts (0 on the bottom side), 10 nets.
