greatscottgadgets/misc/evaluation-boards/DC1722J5005AHF/DC1722J5005AHF.kicad_pcb

## KiCad design evaluation-boards/DC1722J5005AHF/DC1722J5005AHF.kicad_pcb (2022-03-23)

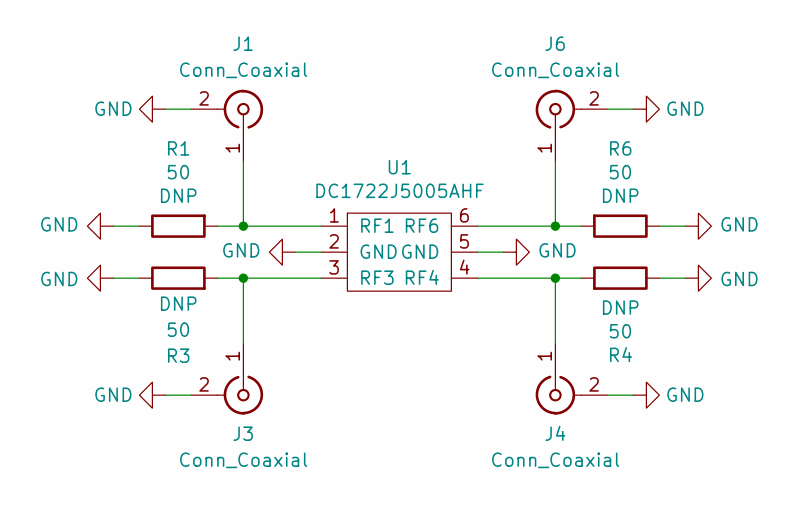
[picture p35: schematic DC1722J5005AHF.sch]

Parts:
J1, J3, J4, J6: Conn_Coaxial; SMA-73251-2120
R1, R3, R4, R6: 50; R_0402_1005Metric
U1: DC1722J5005AHF; Anaren_0805_2012Metric-6

Connections:
GND: J1.2 (Ext), J3.2 (Ext), J4.2 (Ext), J6.2 (Ext), R1.1, R3.1, R4.1, R6.1, U1.2 (GND), U1.5 (GND)
unnamed: J1.1 (In), R1.2, U1.1 (RF1)
unnamed: J3.1 (In), R3.2, U1.3 (RF3)
unnamed: J4.1 (In), R4.2, U1.4 (RF4)
unnamed: J6.1 (In), R6.2, U1.6 (RF6)

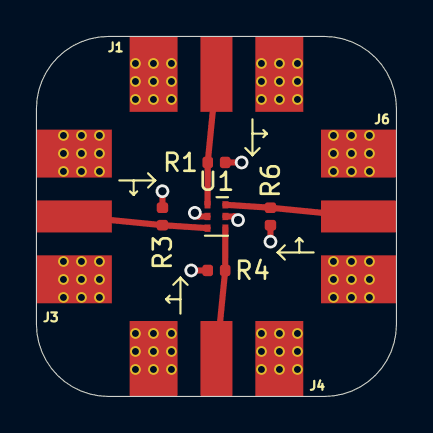
[picture p36: board DC1722J5005AHF.kicad_pcb from above]

Board: 4 copper layers, 20.0 x 20.0 mm, 9 parts (0 on the bottom side), 5 nets.
