greatscottgadgets/misc/evaluation-boards/CC-test/CC-test.kicad_pcb

## KiCad design evaluation-boards/CC-test/CC-test.kicad_pcb (2021-02-22)

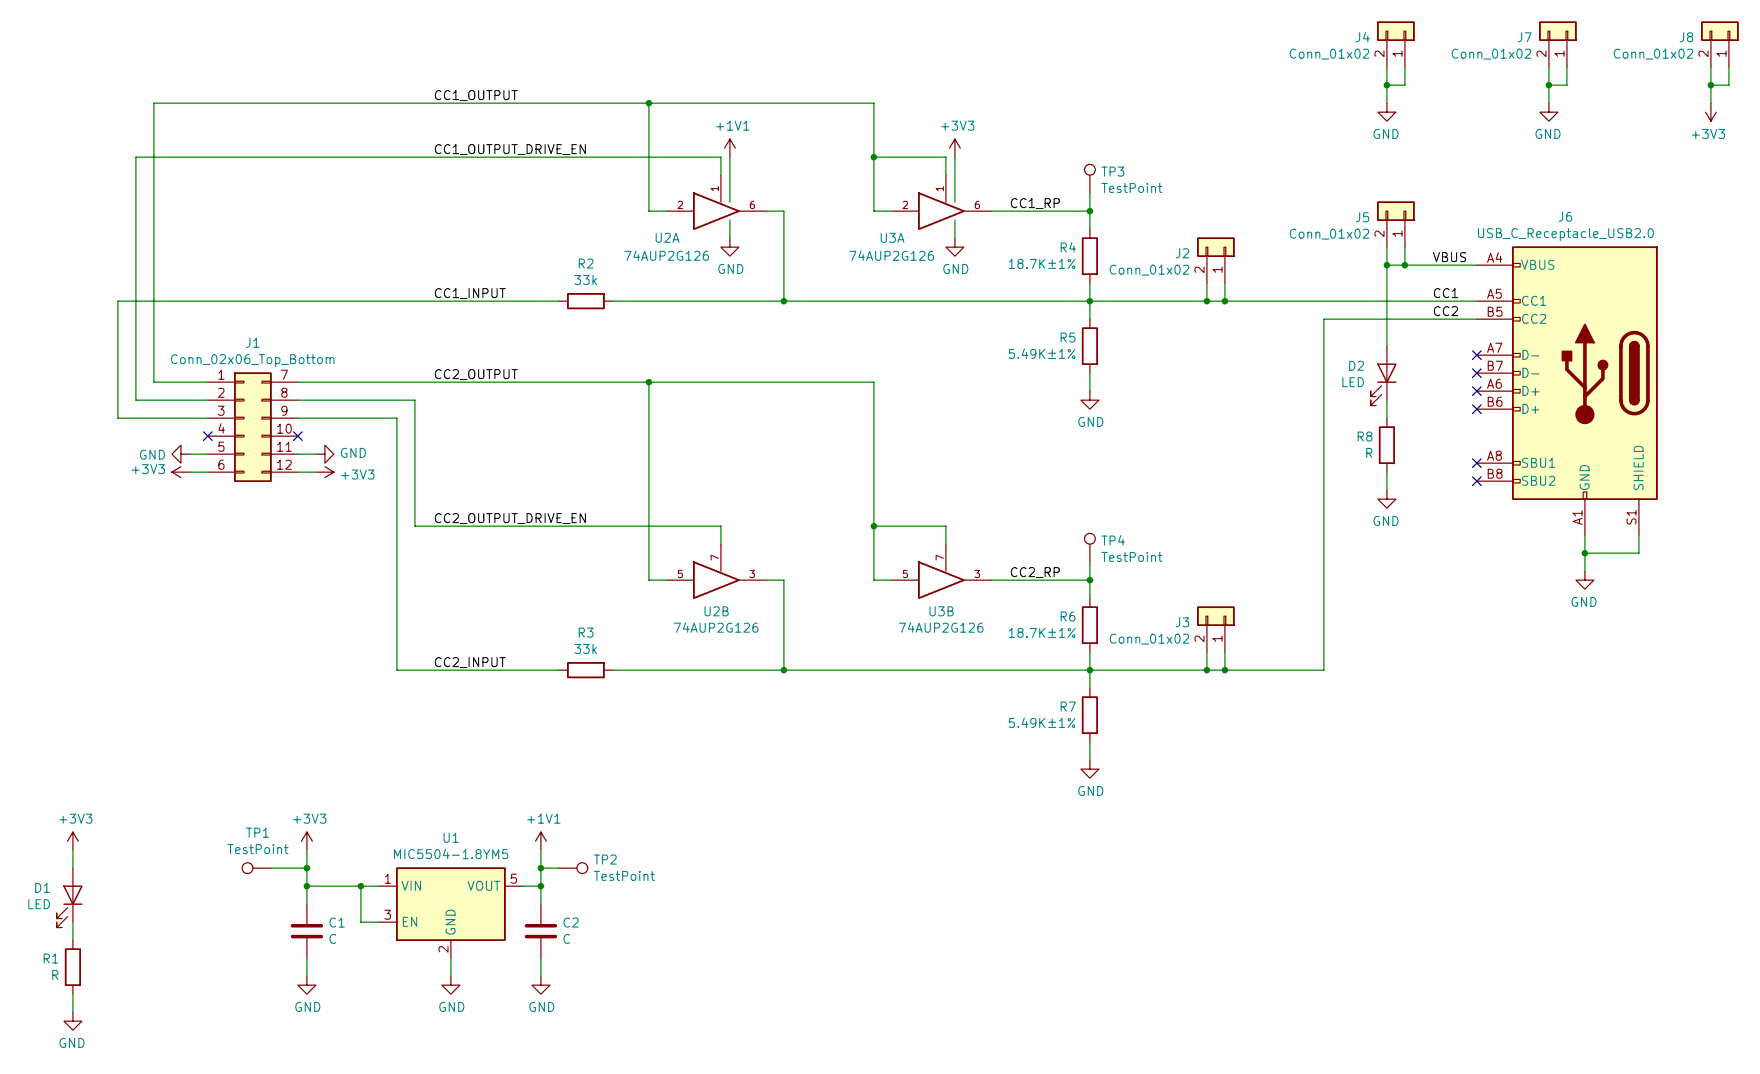
[picture p37: schematic CC-test.sch]

Parts:
C1: C; C_0402_1005Metric
C2: C; C_0603_1608Metric
D1, D2: LED; LED_0603_1608Metric_Pad1.05x0.95mm_HandSolder
J1: Conn_02x06_Top_Bottom; PinHeader_2x06_P2.54mm_PMOD
J2, J3, J4, J5, J7, J8: Conn_01x02; PinHeader_1x02_P2.54mm_Vertical
J6: USB_C_Receptacle_USB2.0; USB_C_Receptacle_HRO_TYPE-C-31-M-12
R1, R8: R; R_0402_1005Metric
R2, R3: 33k; R_0402_1005Metric
R4, R6: 18.7K±1%; R_0402_1005Metric
R5, R7: 5.49K±1%; R_0402_1005Metric
TP1, TP2, TP3, TP4: TestPoint; TestPoint_Pad_D1.0mm
U1: MIC5504-1.8YM5; SOT-23-5
U2, U3: 74AUP2G126; X2-DFN1210-8_1.2x1mm_P0.3mm; Part Number 74AUP2G126RA3-7

Connections:
+1V1: C2.1, TP2.1, U1.5 (VOUT), U2.8 (VCC)
+3V3: C1.1, D1.2 (A), J1.6, J1.12, J8.1, J8.2, TP1.1, U1.1 (VIN), U1.3 (EN), U3.8
/CC1: J2.1, J2.2, J6.A5 (CC1), R2.2, R4.2, R5.1, U2.6
/CC1_INPUT: J1.3, R2.1
/CC1_OUTPUT: J1.1, U2.2, U3.1, U3.2
/CC1_OUTPUT_DRIVE_EN: J1.2, U2.1
/CC1_RP: R4.1, TP3.1, U3.6
/CC2: J3.1, J3.2, J6.B5 (CC2), R3.2, R6.2, R7.1, U2.3
/CC2_INPUT: J1.9, R3.1
/CC2_OUTPUT: J1.7, U2.5, U3.5, U3.7
/CC2_OUTPUT_DRIVE_EN: J1.8, U2.7
/CC2_RP: R6.1, TP4.1, U3.3
/VBUS: D2.2 (A), J5.1, J5.2, J6.A4 (VBUS), J6.A9 (VBUS), J6.B4 (VBUS), J6.B9 (VBUS)
GND: C1.2, C2.2, J1.5, J1.11, J4.1, J4.2, J6.A1 (GND), J6.A12 (GND), J6.B1 (GND), J6.B12 (GND), J6.S1 (SHIELD), J7.1, J7.2, R1.2, R5.2, R7.2, R8.2, U1.2 (GND), U2.4 (GND), U3.4 (GND)
unnamed: D1.1 (K), R1.1
unnamed: D2.1 (K), R8.1

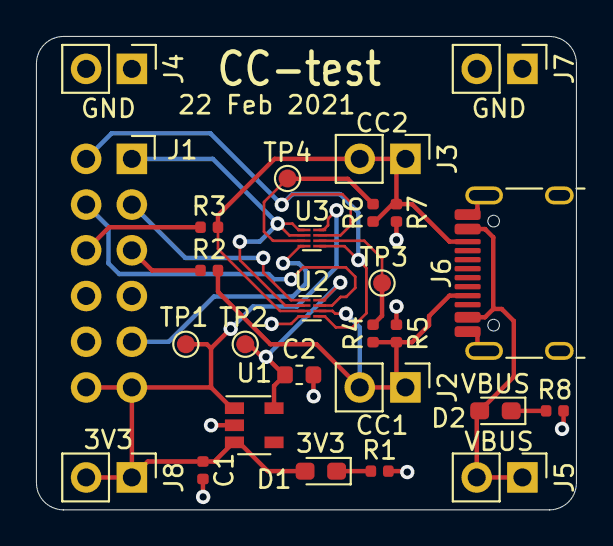
[picture p38: board CC-test.kicad_pcb from above]

Board: 2 copper layers, 30.0 x 26.3 mm, 27 parts (0 on the bottom side), 16 nets.
