greatscottgadgets/misc/evaluation-boards/sky13374/sky13374.kicad_pcb

## KiCad design evaluation-boards/sky13374/sky13374.kicad_pcb (2016-09-26)

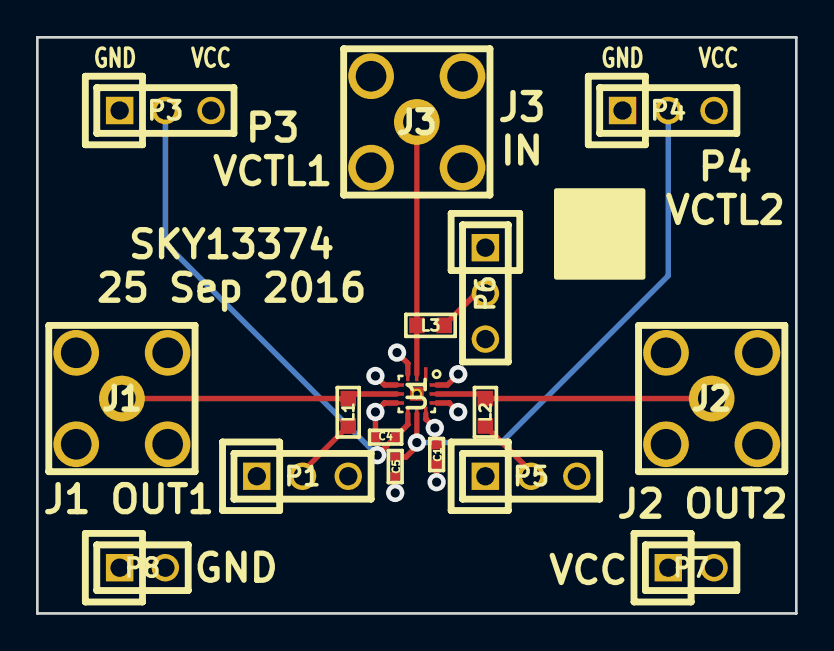
[picture p39: board sky13374.kicad_pcb from above]

Board: 4 copper layers, 42.2 x 32.0 mm, 17 parts (0 on the bottom side), 10 nets.

Parts:
C1: 100nF; 0402
C4, C5: 33pF; 0402
J1, J2, J3: SMA; SMA-VERTICAL
L1, L2, L3: 15uH; 0603
P1, P3, P4, P5, P6: CONN_01X03; HEADER-1x3
P7, P8: CONN_01X02; HEADER-1x2
U1: SKY13374; SKY13374-397LF

Connections:
GND: C1.1, C4.2, C5.1, J1.2, J2.2, J3.2, P1.1, P3.1, P4.1, P5.1, P6.1, P8.1, P8.2, U1.0, U1.3, U1.4, U1.6, U1.10, U1.12
unnamed: C4.1, P3.2, U1.7
unnamed: C5.2, P4.2, U1.8
unnamed: J1.1, L1.2, U1.5
unnamed: J2.1, L2.2, U1.11
unnamed: J3.1, L3.2, U1.2
unnamed: L1.1, P1.2
unnamed: L2.1, P5.2
unnamed: L3.1, P6.2
VCC: C1.2, P1.3, P3.3, P4.3, P5.3, P6.3, P7.1, P7.2, U1.9
