greatscottgadgets/misc/evaluation-boards/sky13411/sky13411.kicad_pcb

## KiCad design evaluation-boards/sky13411/sky13411.kicad_pcb (2016-09-26)

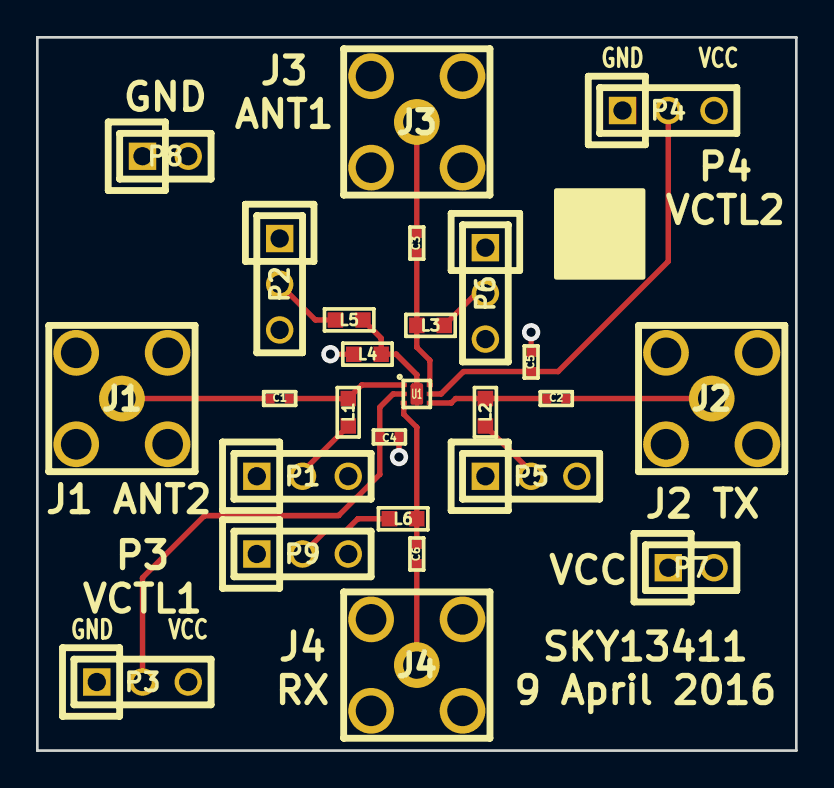
[picture p40: board sky13411.kicad_pcb from above]

Board: 4 copper layers, 42.2 x 39.6 mm, 26 parts (0 on the bottom side), 18 nets.

Parts:
C1, C2, C3, C6: 100nF; 0402
C4, C5: 33pF; 0402
J1, J2, J3, J4: SMA; SMA-VERTICAL
L1, L2, L3, L4, L5, L6: 15uH; 0603
P1, P2, P3, P4, P5, P6, P9: CONN_01X03; HEADER-1x3
P7, P8: CONN_01X02; HEADER-1x2
U1: SKY13411; SKY13411-374LF

Connections:
GND: C4.2, C5.1, J1.2, J2.2, J3.2, J4.2, L4.1, P1.1, P2.1, P3.1, P4.1, P5.1, P6.1, P8.1, P8.2, P9.1
unnamed: C1.1, L1.2, U1.1
unnamed: C1.2, J1.1
unnamed: C2.1, J2.1
unnamed: C2.2, L2.2, U1.4
unnamed: C3.1, J3.1
unnamed: C3.2, L3.2, U1.6
unnamed: C4.1, P3.2, U1.2
unnamed: C5.2, P4.2, U1.5
unnamed: C6.1, L6.2, U1.3
unnamed: C6.2, J4.1
unnamed: L1.1, P1.2
unnamed: L2.1, P5.2
unnamed: L3.1, P6.2
unnamed: L4.2, L5.2, U1.0
unnamed: L5.1, P2.2
unnamed: L6.1, P9.2
VCC: P1.3, P2.3, P3.3, P4.3, P5.3, P6.3, P7.1, P7.2, P9.3
