greatscottgadgets/misc/(commit log)

2016-03-04 started evaluation boards, gsg-kicad-lib submodule
2016-03-05 started SKY13350 evaluation board
    [sky13350.kicad_pcb, sky13350.sch]
2016-03-06 finished SKY13350
    [sky13350.kicad_pcb, sky13350.sch]
2016-03-06 SKY13351 evaluation board
    [sky13351.kicad_pcb, sky13351.sch]
2016-09-26 SKY13411 evaluation board
    [sky13411.kicad_pcb, sky13411.sch]
2016-09-26 SKY13374 evaluation board
    [sky13374.kicad_pcb, sky13374.sch]
2020-08-12 add BGB741L7ESD evaluation board
    [BGB741L7ESD.kicad_pcb, BGB741L7ESD.sch]
2020-08-12 update BGB741L7ESD to KiCad 5.1
    [BGB741L7ESD.sch]
2020-08-12 BGB741L7ESD: update with PCB edge SMA connectors
    [BGB741L7ESD.kicad_pcb, BGB741L7ESD.sch]
2021-02-22 add CC-test board for LUNA
    [CC-test.kicad_pcb, CC-test.sch]
2021-02-22 CC-test: change U2 and U3 to 74AUP2G126RA3-7
    [CC-test.kicad_pcb, CC-test.sch]
2022-03-23 add BGA622H6820 evaluation board
    [BGA622H6820.kicad_pcb, BGA622H6820.sch]
2022-03-23 add .gitignore for KiCad
2022-03-23 add DC1722J5005AHF evaluation board
    [DC1722J5005AHF.kicad_pcb, DC1722J5005AHF.sch]
2022-03-23 add filter test board
    [filters.kicad_pcb, filters.sch]
2022-03-23 add quad balun directional coupler
    [quad-balun-directional-coupler.kicad_pcb, quad-balun-directional-coupler.sch]
2022-03-23 add trace width test board
    [trace-width-sunstone.kicad_pcb, trace-width.kicad_pcb, trace-width.sch]
2022-03-23 update trace width test board
    - widen traces
    - use metric widths
    - revert to CONSMA003.062 footprint
    - add ground plane cutouts under SMA footprint
    The schematic wasn't updated as it is not very useful.
    [trace-width.kicad_pcb]
2022-04-07 add trace width layout for JLCPCB
    [trace-width-jlcpcb.kicad_pcb]
2022-04-09 update trace width layout
    [trace-width.kicad_pcb]
2022-04-09 add limiters test board
    [limiters.kicad_pcb, limiters.kicad_sch, limiters.sch]
2022-04-09 add ununs test board
    [ununs.kicad_pcb, ununs.kicad_sch, ununs.sch]
2022-04-09 add passives test board
    [passives.kicad_pcb, passives.kicad_sch, passives.sch]
2022-08-11 add Si5351A board
    [Si5351A.kicad_pcb, Si5351A.kicad_sch]
2023-01-21 update trace width test board with SMA variants
2023-01-23 add pmos-or: FET-based alternative for diode-OR
    [pmos-or.kicad_pcb, pmos-or.kicad_sch]
2023-01-24 add vbus-switch board
    [vbus-switch.kicad_pcb, vbus-switch.kicad_sch]
2023-01-24 vbus-switch: up minimum trace/space to 3.5 mil
    [vbus-switch.kicad_pcb]
2023-01-24 vbus-switch: add part selections
    [vbus-switch.kicad_pcb, vbus-switch.kicad_sch]
2023-01-24 pmos-or: add part selections
    [pmos-or.kicad_pcb, pmos-or.kicad_sch]
2023-02-12 update vbus-switch
    [vbus-switch.kicad_pcb, vbus-switch.kicad_sch]
2023-02-13 vbus-switch: update resistor selection
    [vbus-switch.kicad_pcb, vbus-switch.kicad_sch]
2023-03-22 add SMA footprint test PCB for JLCPCB
    [sma-jlcpcb.kicad_pcb]
2023-04-21 add rf-switch-dpdt board
    [rf-switch-dpdt.kicad_pcb, rf-switch-dpdt.kicad_sch]
2023-04-22 update CONSMA003.062 footprint
    [pmos-or.kicad_sch, rf-switch-dpdt.kicad_pcb]
2023-04-22 add rf-switch-sp3t board
    [rf-switch-sp3t.kicad_pcb, rf-switch-sp3t.kicad_sch]
2023-04-22 add rf-switch-spdt board
    [rf-switch-spdt.kicad_pcb, rf-switch-spdt.kicad_sch]
2024-01-05 Update JLCPCB 7628 stack-up trace width board
    JLCPCB changed their stack-ups at some point in 2022. This board is
    intended to confirm the appropriate trace width for 50 ohm microstrip on
    their new 6-layer stack-up.
    [trace-width-jlcpcb.kicad_pcb]
2024-11-04 Update trace width and SMA connector boards
    [sma-jlcpcb.kicad_pcb, sma-jlcpcb.kicad_sch, trace-width-jlcpcb.kicad_pcb]
2024-11-04 Update passives board
    [passives.kicad_pcb, passives.kicad_sch]
2024-11-04 Remove .kicad_prl file
2024-11-04 Rename BGB741L7ESD board to rf-amps
    [rf-amps.kicad_pcb, rf-amps.sch]
2024-11-04 Update rf-amps board
    [rf-amps.kicad_pcb, rf-amps.kicad_sch, rf-amps.sch]
2024-11-05 Add more amplifiers to rf-amps board
    [rf-amps.kicad_pcb, rf-amps.kicad_sch]
2024-11-05 Update TSLP-7-1 footprint
    [rf-amps.kicad_pcb, rf-amps.kicad_sch]
2024-11-12 Update RF test boards
    - limiters
    - rf-switch-spdt
    - rf-switch-sp3t
    [limiters.kicad_pcb, limiters.kicad_sch, rf-switch-sp3t.kicad_pcb, rf-switch-sp3t.kicad_sch, rf-switch-spdt.kicad_pcb, rf-switch-spdt.kicad_sch]
2024-11-12 Add rf-switch-sp4t board
    [rf-switch-sp4t.kicad_pcb, rf-switch-sp4t.kicad_sch]
2024-11-13 Update filter test board
    [filters.kicad_pcb, filters.kicad_sch, filters.sch]
2024-12-06 Update SMA connector board
    [sma-jlcpcb.kicad_pcb, sma-jlcpcb.kicad_sch]
2024-12-10 Update limiters board
    [limiters.kicad_pcb, limiters.kicad_sch]
2025-03-11 Update filters board
    [filters.kicad_pcb, filters.kicad_sch]
2025-03-12 Add leds board
    [leds.kicad_pcb, leds.kicad_sch]
2025-05-14 Add baluns board
    [baluns.kicad_pcb, baluns.kicad_sch]
2025-06-16 Update baluns board
