greatscottgadgets/misc/(notices)

Notices in the files:
parts and their libraries:
COPYRIGHT: Copyright 2023 Great Scott Gadgets
LICENSE: Licensed under the CERN-OHL-P v2
COPYRIGHT: Copyright 2025 Great Scott Gadgets
COPYRIGHT: Copyright 2023-2024 Great Scott Gadgets
COPYRIGHT: Copyright 2024 Great Scott Gadgets
COPYRIGHT: Copyright 2024-2025 Great Scott Gadgets
